Iron-Byron/Testing-Documentation-for-SMP/Images/PCBeasyeda.png

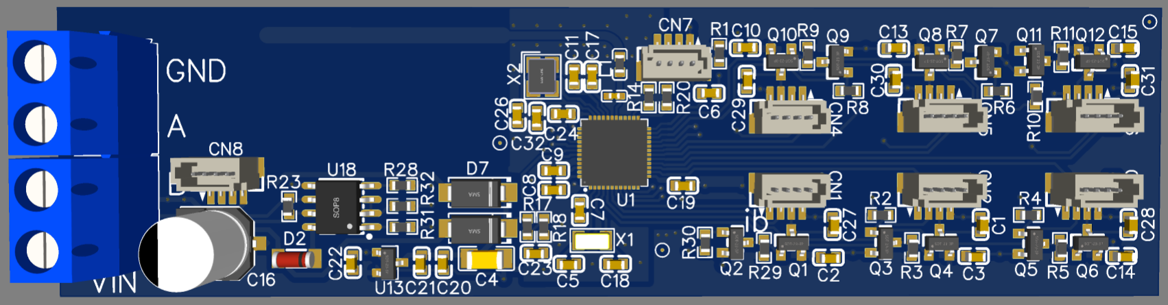
Images/PCBeasyeda.png
