Iron-Byron/Testing-Documentation-for-SMP/Diagram.pptx

4

5

6

1

2

3

1

## Slide 2

Counter

Analog

3V3

GND

## Slide 3

4

5

6

1

2

3

## Slide 4

Sense Board 1

Sense Board 2

Sense Board 4

Sense Board 3

Sense Board 5

Sense Board 6

Main Processing MCU

(6x ADC Temperature Sensors)

(6x Counter Moisture Sensors)

Outputs

RS485
String

BLE Firmware
Update

BLE
Calibration

## Slide 5

+

3v3

control signal

Battery

+

+

control signal

switch

+

Sensor 1

MCU

control signal

switch

+

+

Sensor 2

control signal

switch

switch

+

Sensor 4

Sensor 3

control signal

control signal

switch

+

Sensor 5

switch

+

Sensor 6

## Slide 6

## Slide 7

100

100

100

200

200
