Iron-Byron/Testing-Documentation-for-SMP/Schematic of Sense boards/SMP ver 11.00/SMP ver 11.00 PCB Assy files/SMP ver 11.00 PCB Assy files/SMP ver 11.00 PCB 3D Bottom files.PDF

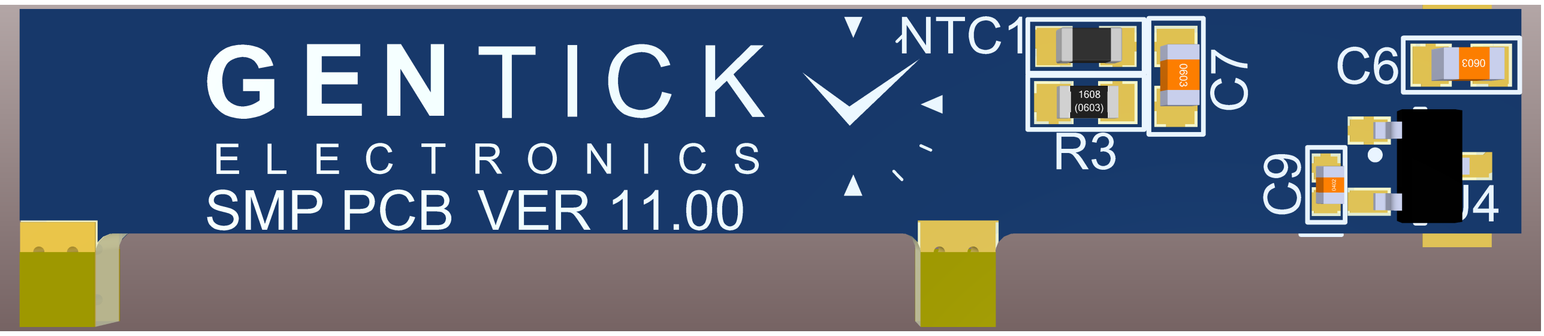
[picture p6: figure]
