Iron-Byron/Testing-Documentation-for-SMP/Schematic of Sense boards/SMP ver 10.00/SMP ver 10.00 PCB PDF files/SMP ver 10.00 PCB 3D Bottom files.PDF

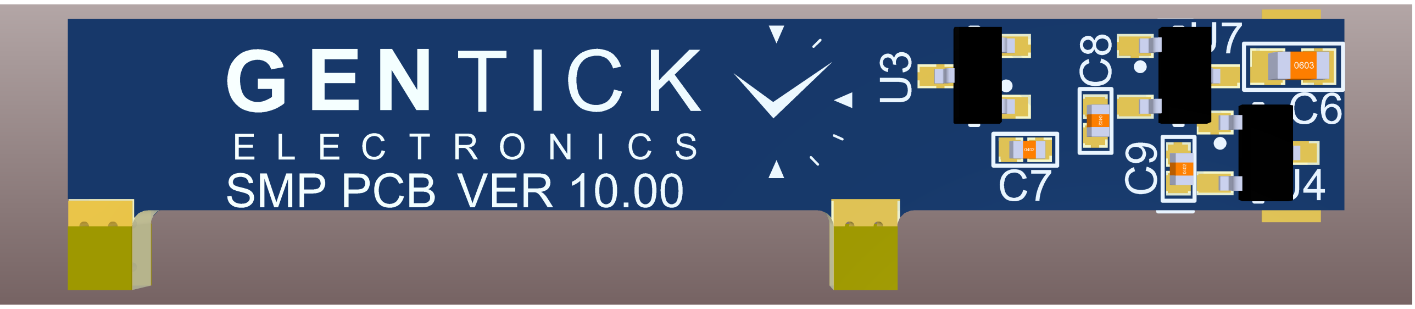
[picture p8: figure]
