Iron-Byron/Testing-Documentation-for-SMP/Images/29.04.2025.1to3temp.png

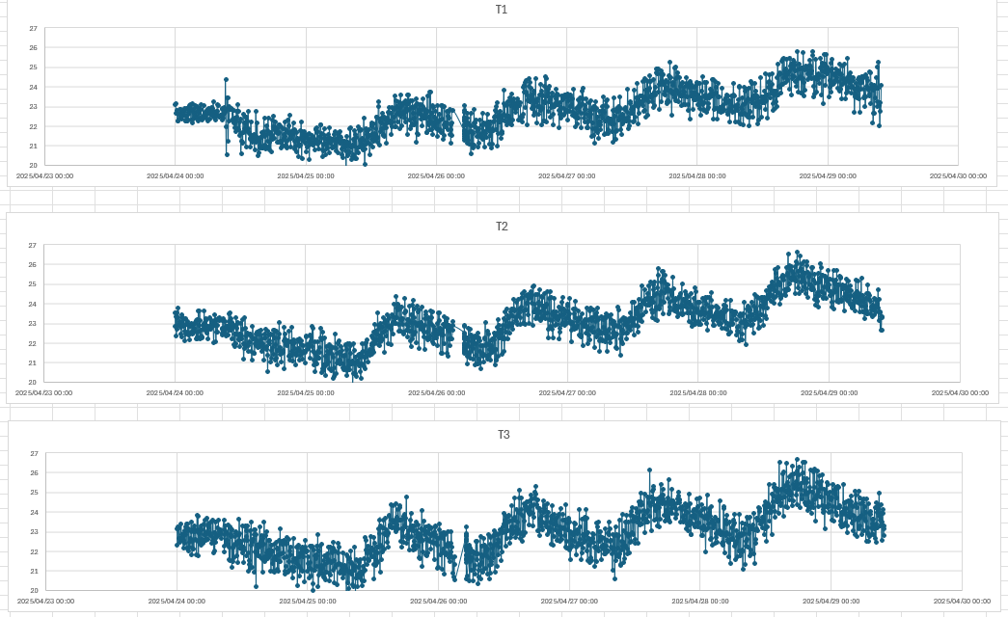
Images/29.04.2025.1to3temp.png
