Iron-Byron/Testing-Documentation-for-SMP/Images/29.04.2025.4to6temp.png

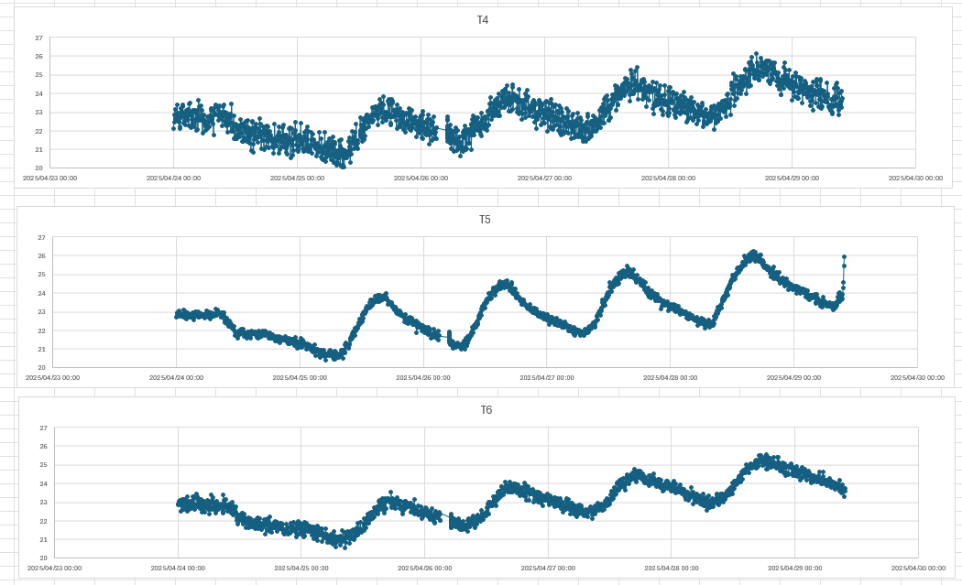
Images/29.04.2025.4to6temp.png
