Iron-Byron/Testing-Documentation-for-SMP/Images/Connector.png

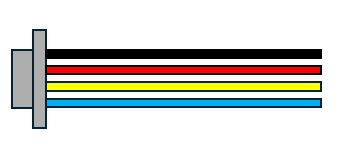
Images/Connector.png
