Iron-Byron/Testing-Documentation-for-SMP/Images/MCUboard.png

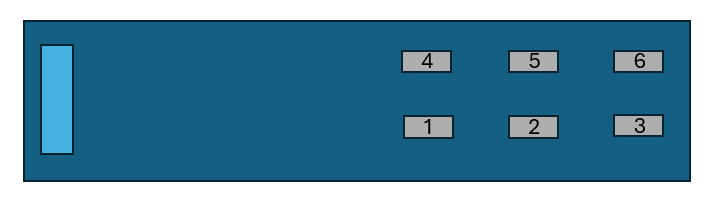
Images/MCUboard.png
