Iron-Byron/Testing-Documentation-for-SMP/Images/nrf52832_001.jpg

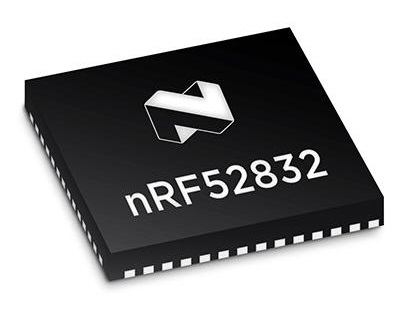
Images/nrf52832_001.jpg
