Iron-Byron/Testing-Documentation-for-SMP/Images/NTCno.nos.png

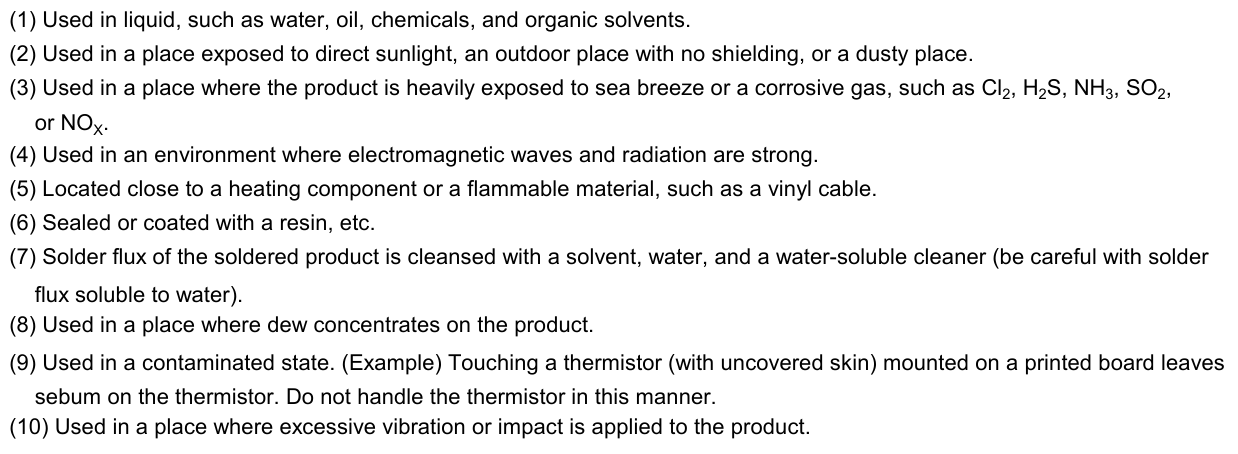
Images/NTCno.nos.png
