Iron-Byron/Testing-Documentation-for-SMP/Images/Probespacing.png

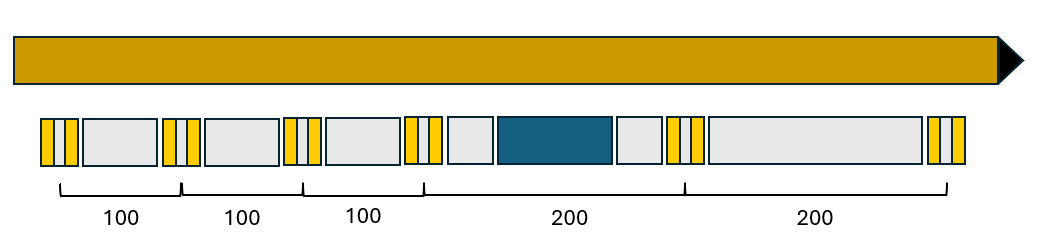
Images/Probespacing.png
