Iron-Byron/Testing-Documentation-for-SMP/Images/soilTemps.png

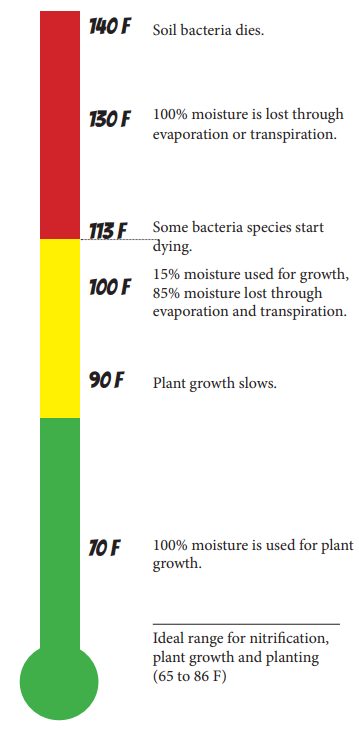
Images/soilTemps.png
