Iron-Byron/Testing-Documentation-for-SMP/Images/TempSchemat.png

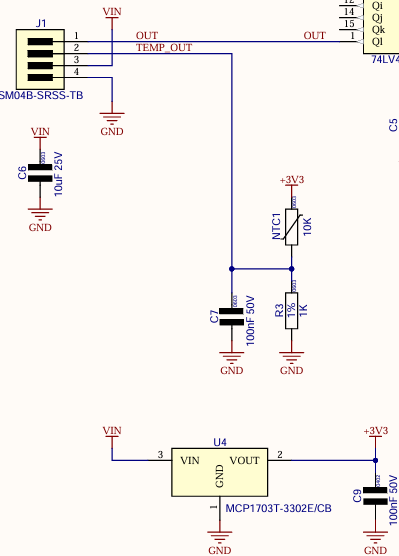
Images/TempSchemat.png
