Iron-Byron/Testing-Documentation-for-SMP/Schematic of Sense boards/SMP ver 11.00/SMP ver 11.00 PCB BOM_Building.xlsx

Title : SMP ver 11.00 PCB Parts List
Doc No : n/a
Date : 19/11/2024
Prepared By : EDM
Doc Rev : 01 |  |  | `
 |  |  |  |  |  |  |  |  |  |  | 1000 | stock
Item | Quantity | Designator | Description | Value | Voltage | Tol | Watt | Footprint | Manufacturer | Part Number | DNF
1 | 3 | C4, C5, C9 | Cap Ceramic X5R | 100nF | 50V | 5% |  | CAPC0402X60N | Various | 100nF 0402 50V 5% X5R | 3000
2 | 1 | C7 | Cap Ceramic X5R | 100nF | 50V | 5% |  | CAPC0603X85N | Various | 100nF 0603 50V 5% X5R | 1000
3 | 1 | C1 | Cap Ceramic C0G/NP0 | 100pF | 50V | 10% |  | CAPC0402X60N | Various | 100pF 0402 50V 10% C0G/NP0 | 1000
4 | 1 | C2 | Cap Ceramic C0G/NP0 | 10pF | 50V | 5% |  | CAPC0402X60N | Various | 10pF 0402 50V 5% C0G/NP0 | 1000
5 | 1 | C6 | Cap Ceramic X5R | 10uF | 25V | 10% |  | CAPC0603X85N | Various | 10uF 0603 25V 10% X5R | 1000
6 | 1 | C3 | Cap Ceramic C0G/NP0 | 4.7pF | 50V | 5% |  | CAPC0402X60N | Various | 4.7pF 0402 50V 5% C0G/NP0 | 1000
7 | 1 | J1 | Connector Wire to Board 1.0mm Rt Angle | SM04B-SRSS-TB |  |  |  | SM04B-SRSS-TB | JST | SM04B-SRSS-TB | 1000 | 1500
8 | 1 | U1 | IC 12-Bit Binary Ripple Counter | 74LV4040FT |  |  |  | TSSOP16-4.5x5.0 | Toshiba | 74LV4040FT | 1000 | 2500
9 | 1 | U2 | IC Single Schmitt-Trigger Inverter | 74AHC1G14DBVR |  |  |  | SOT23-5 | Texas | 74AHC1G14DBVR | 1000
10 | 1 | NTC1 | NTC Thermistor 0603 | 10K |  |  |  | NTC0603 | Panasonic | ERT-J1VG103FA | 1000
11 | 1 | R3 | Resistor Chip SMD | 1K |  | 1% | 100mW | RESC0603X60N | Various | 1K 0603 1% | 1000
12 | 2 | R1, R2 | Resistor Chip SMD | 510R |  | 1% | 63mW | RESC0402X40N | Various | 510R 0402 1% | 2000
13 | 1 | U4 | Voltage Regulator LDO 250mA | XC6206P332MR-G |  |  |  | SOT23A | Torex | XC6206P332MR-G | 1000
14 | 1 |  | SMP ver 11.00 PCB (2 Layer) |  |  |  |  |  | EDM |  | 1000
