Iron-Byron/Testing-Documentation-for-SMP/Schematic of Sense boards/SMP ver 11.00/SMP ver 11.00 PCB Assy files/SMP ver 11.00 PCB Assy files/SMP ver 11.00 PCB Parts List.xlsx

Title : SMP ver 11.00 PCB Parts List
Doc No : n/a
Date : 19/11/2024
Prepared By : EDM
Doc Rev : 01 |  |  | `
Item | Quantity | Designator | Description | Value | Voltage | Tol | Watt | Footprint | Manufacturer | Part Number | DNF
1 | 3 | C4, C5, C9 | Cap Ceramic X5R | 100nF | 50V | 5% |  | CAPC0402X60N | Various | 100nF 0402 50V 5% X5R
2 | 1 | C7 | Cap Ceramic X5R | 100nF | 50V | 5% |  | CAPC0603X85N | Various | 100nF 0603 50V 5% X5R
3 | 1 | C1 | Cap Ceramic C0G/NP0 | 100pF | 50V | 10% |  | CAPC0402X60N | Various | 100pF 0402 50V 10% C0G/NP0
4 | 1 | C2 | Cap Ceramic C0G/NP0 | 10pF | 50V | 5% |  | CAPC0402X60N | Various | 10pF 0402 50V 5% C0G/NP0
5 | 1 | C6 | Cap Ceramic X5R | 10uF | 25V | 10% |  | CAPC0603X85N | Various | 10uF 0603 25V 10% X5R
6 | 1 | C3 | Cap Ceramic C0G/NP0 | 4.7pF | 50V | 5% |  | CAPC0402X60N | Various | 4.7pF 0402 50V 5% C0G/NP0
7 | 1 | J1 | Connector Wire to Board 1.0mm Rt Angle | SM04B-SRSS-TB |  |  |  | SM04B-SRSS-TB | JST | SM04B-SRSS-TB
8 | 1 | U1 | IC 12-Bit Binary Ripple Counter | 74LV4040APWR |  |  |  | TSSOP16-4.5x5.0 | Texas | 74LV4040APWR
9 | 1 | U2 | IC Single Schmitt-Trigger Inverter | 74AHC1G14DBVR |  |  |  | SOT23-5 | Texas | 74AHC1G14DBVR
10 | 1 | NTC1 | NTC Thermistor 0603 | 1K |  |  |  | NTC0603 | Panasonic | ERT-J1VG102J
11 | 1 | R3 | Resistor Chip SMD | 1K |  | 1% | 100mW | RESC0603X60N | Various | 1K 0603 1%
12 | 2 | R1, R2 | Resistor Chip SMD | 510R |  | 1% | 63mW | RESC0402X40N | Various | 510R 0402 1%
13 | 1 | U4 | Voltage Regulator LDO 250mA | MCP1703T-3302E/CB |  |  |  | SOT23A | Microchip | MCP1703T-3302E/CB
14 | 1 |  | SMP ver 11.00 PCB (2 Layer) |  |  |  |  |  | EDM
