Iron-Byron/Testing-Documentation-for-SMP/Schematic of Sense boards/SMP ver 11.00/SMP ver 11.00 PCB Assy files/SMP ver 11.00 PCB Assy files/SMP ver 11.00 PCB Assy files.PDF

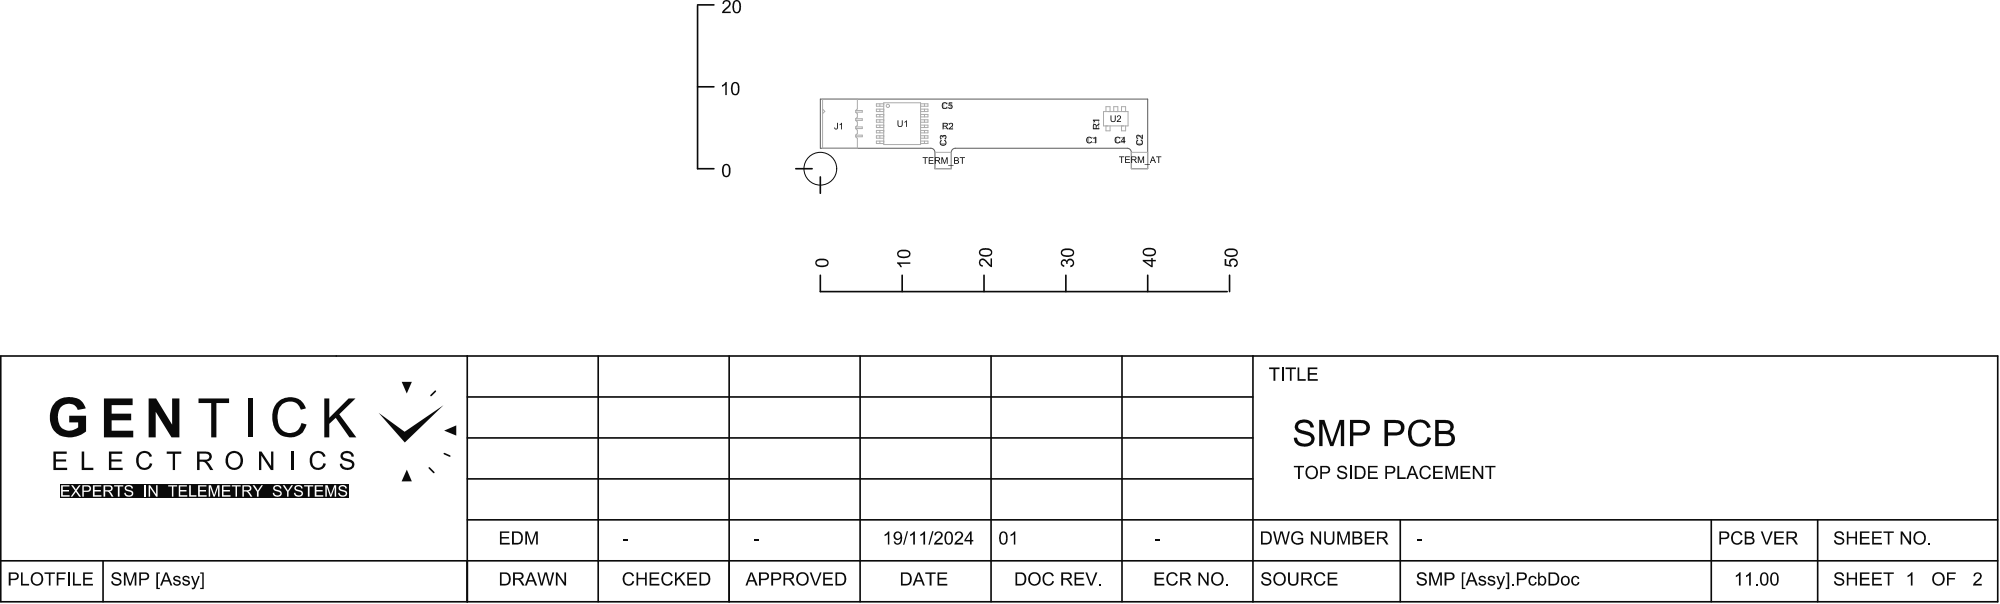
[picture p112: page 1]

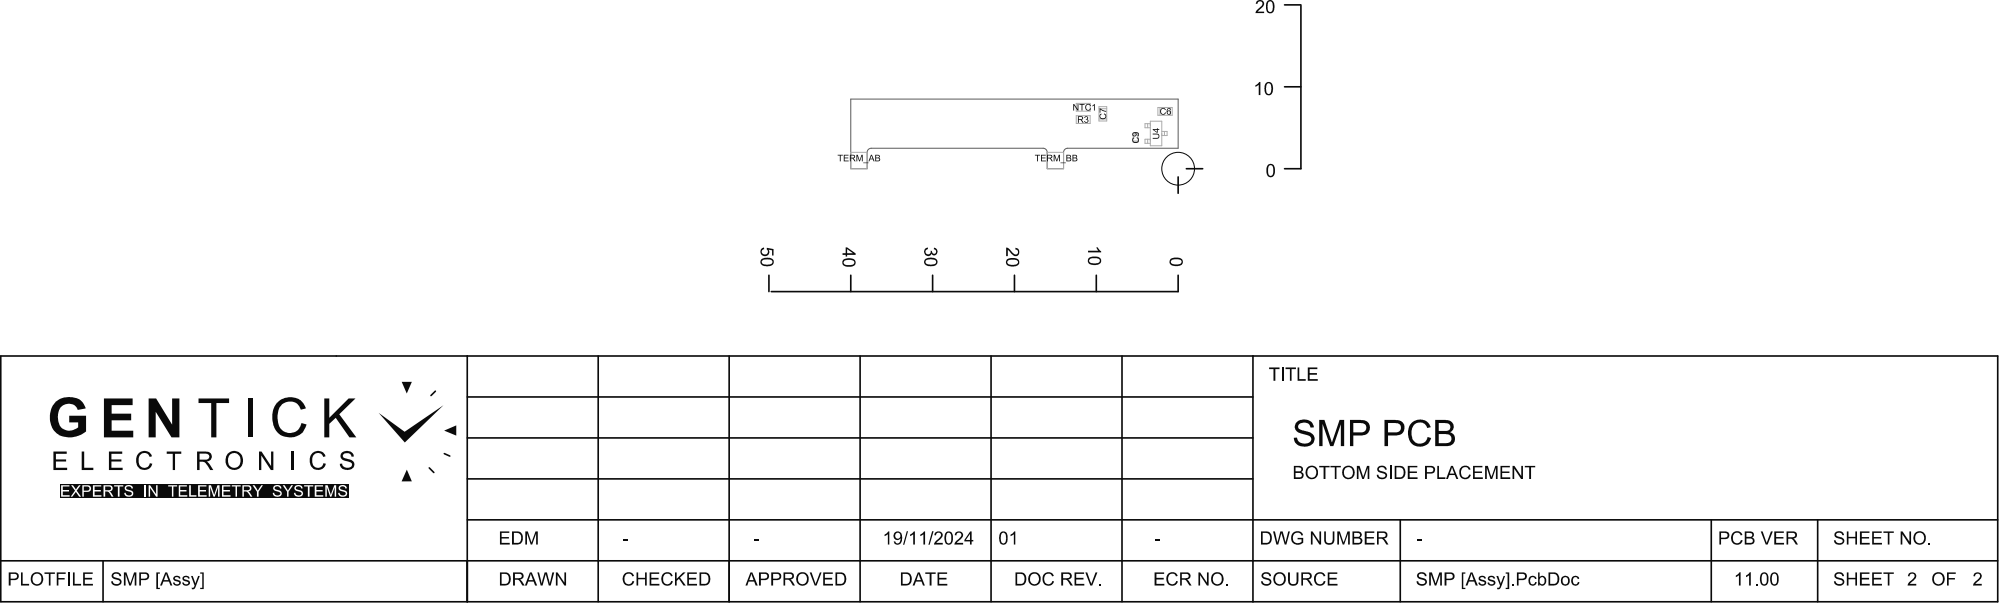
[picture p113: page 2]
