Iron-Byron/Testing-Documentation-for-SMP/Schematic of Sense boards/SMP ver 11.00/SMP ver 11.00 PCB PDF files/SMP ver 11.00 PCB PDF files/SMP ver 11.00 PCB Mfg files.PDF

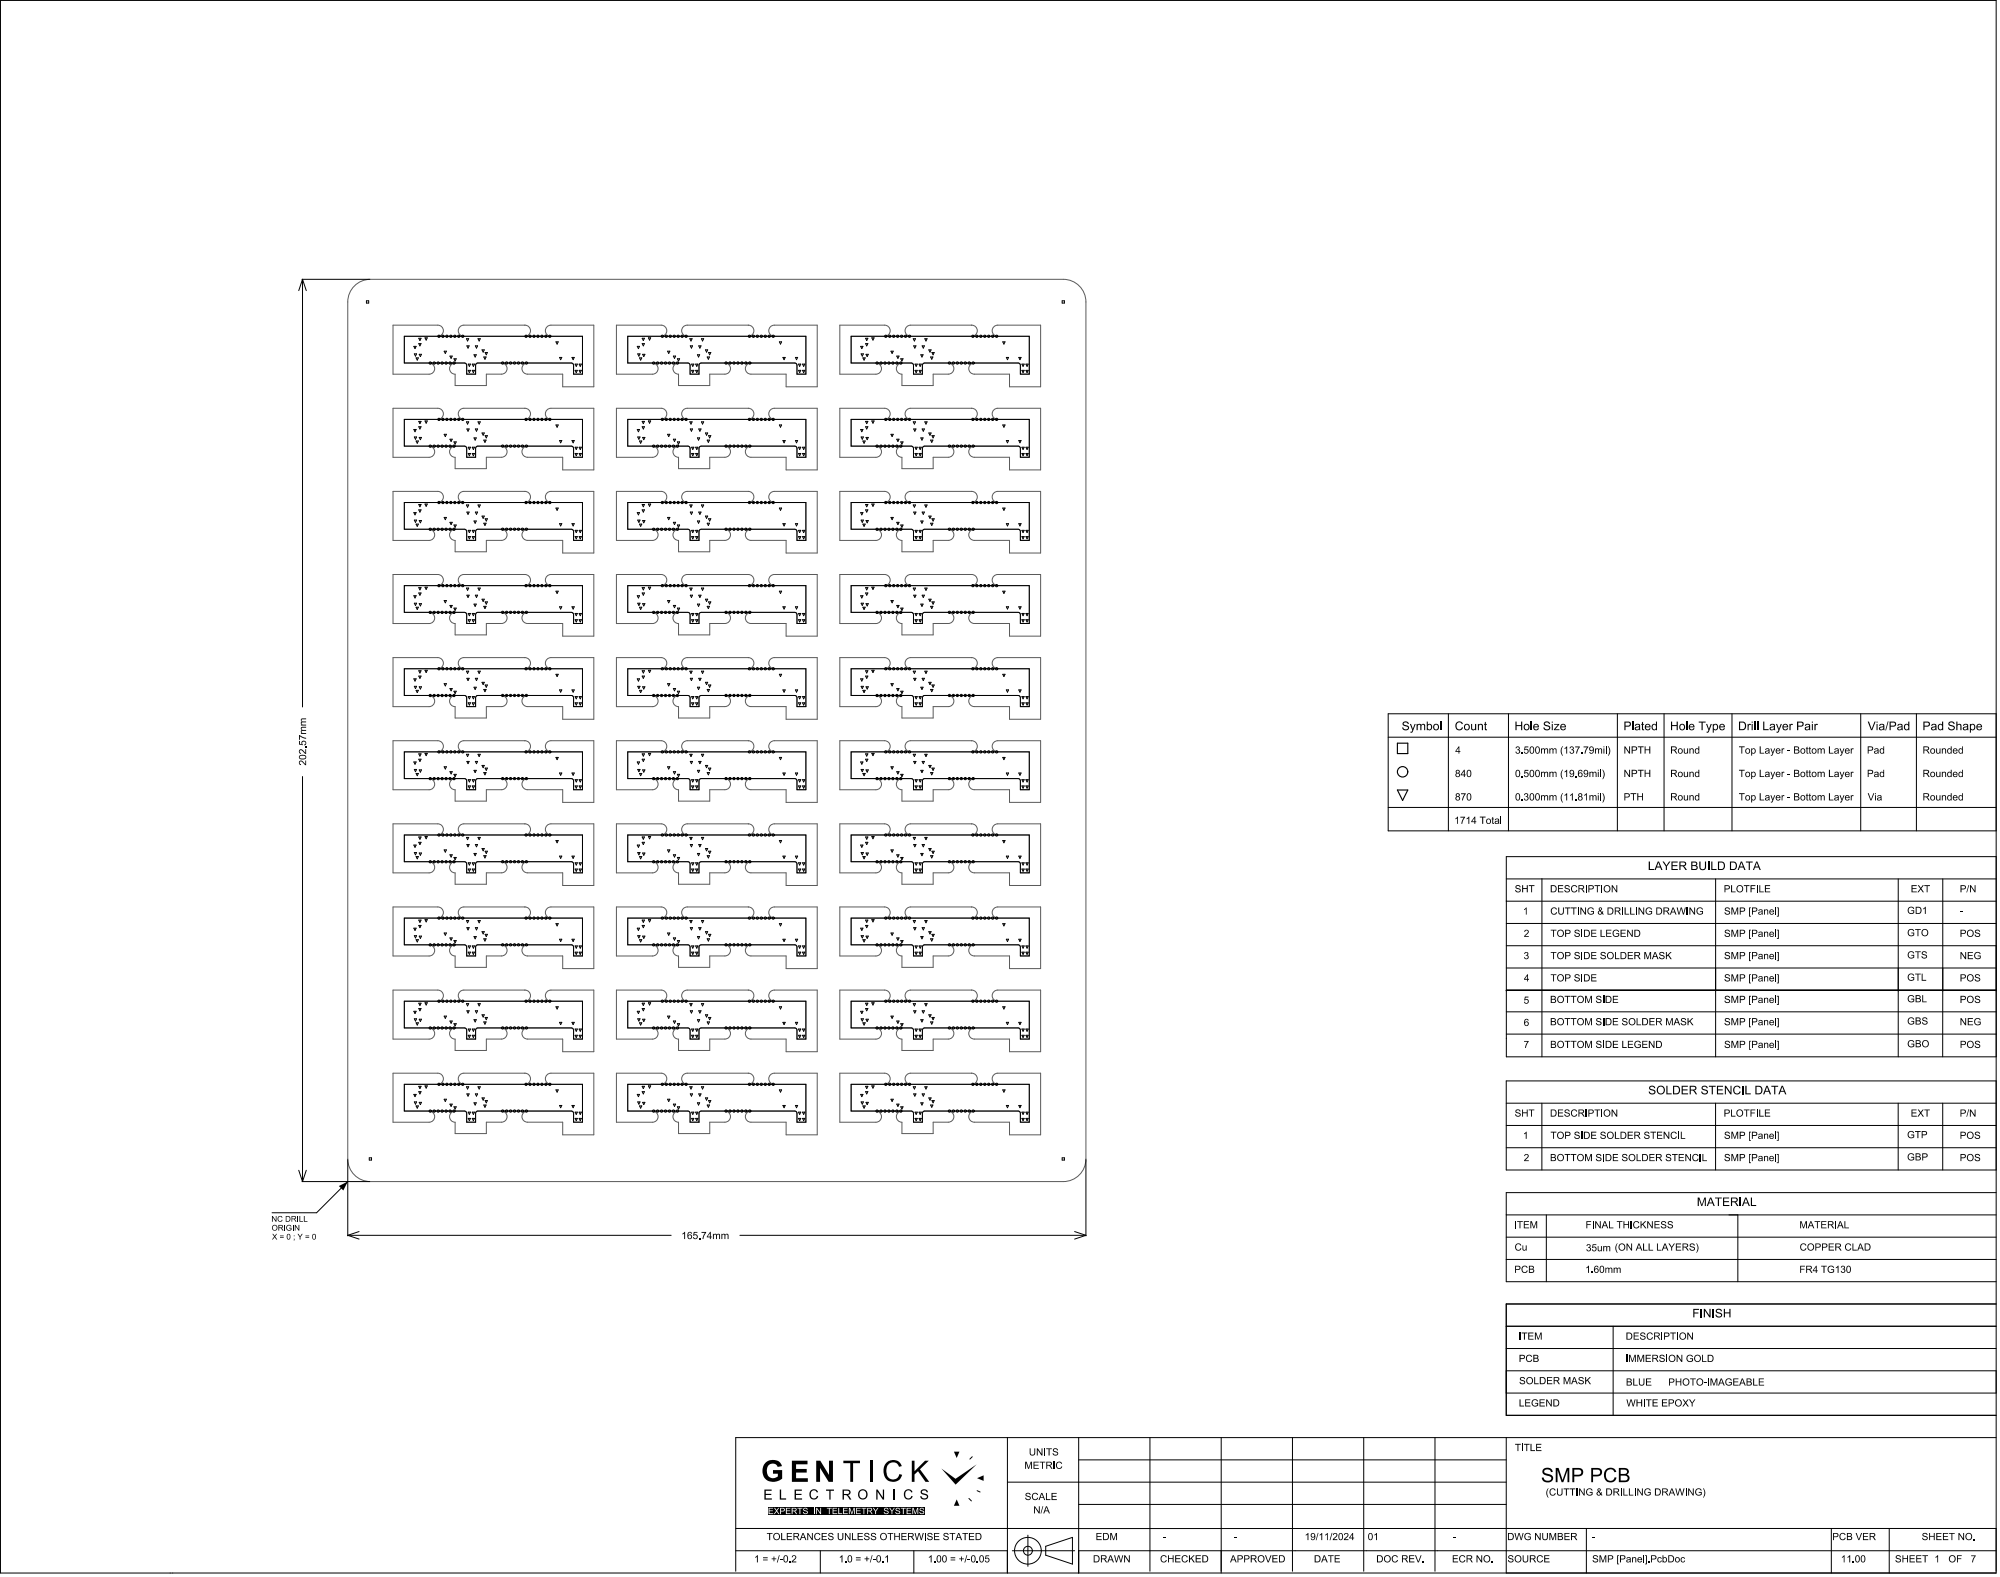
[picture p114: page 1]

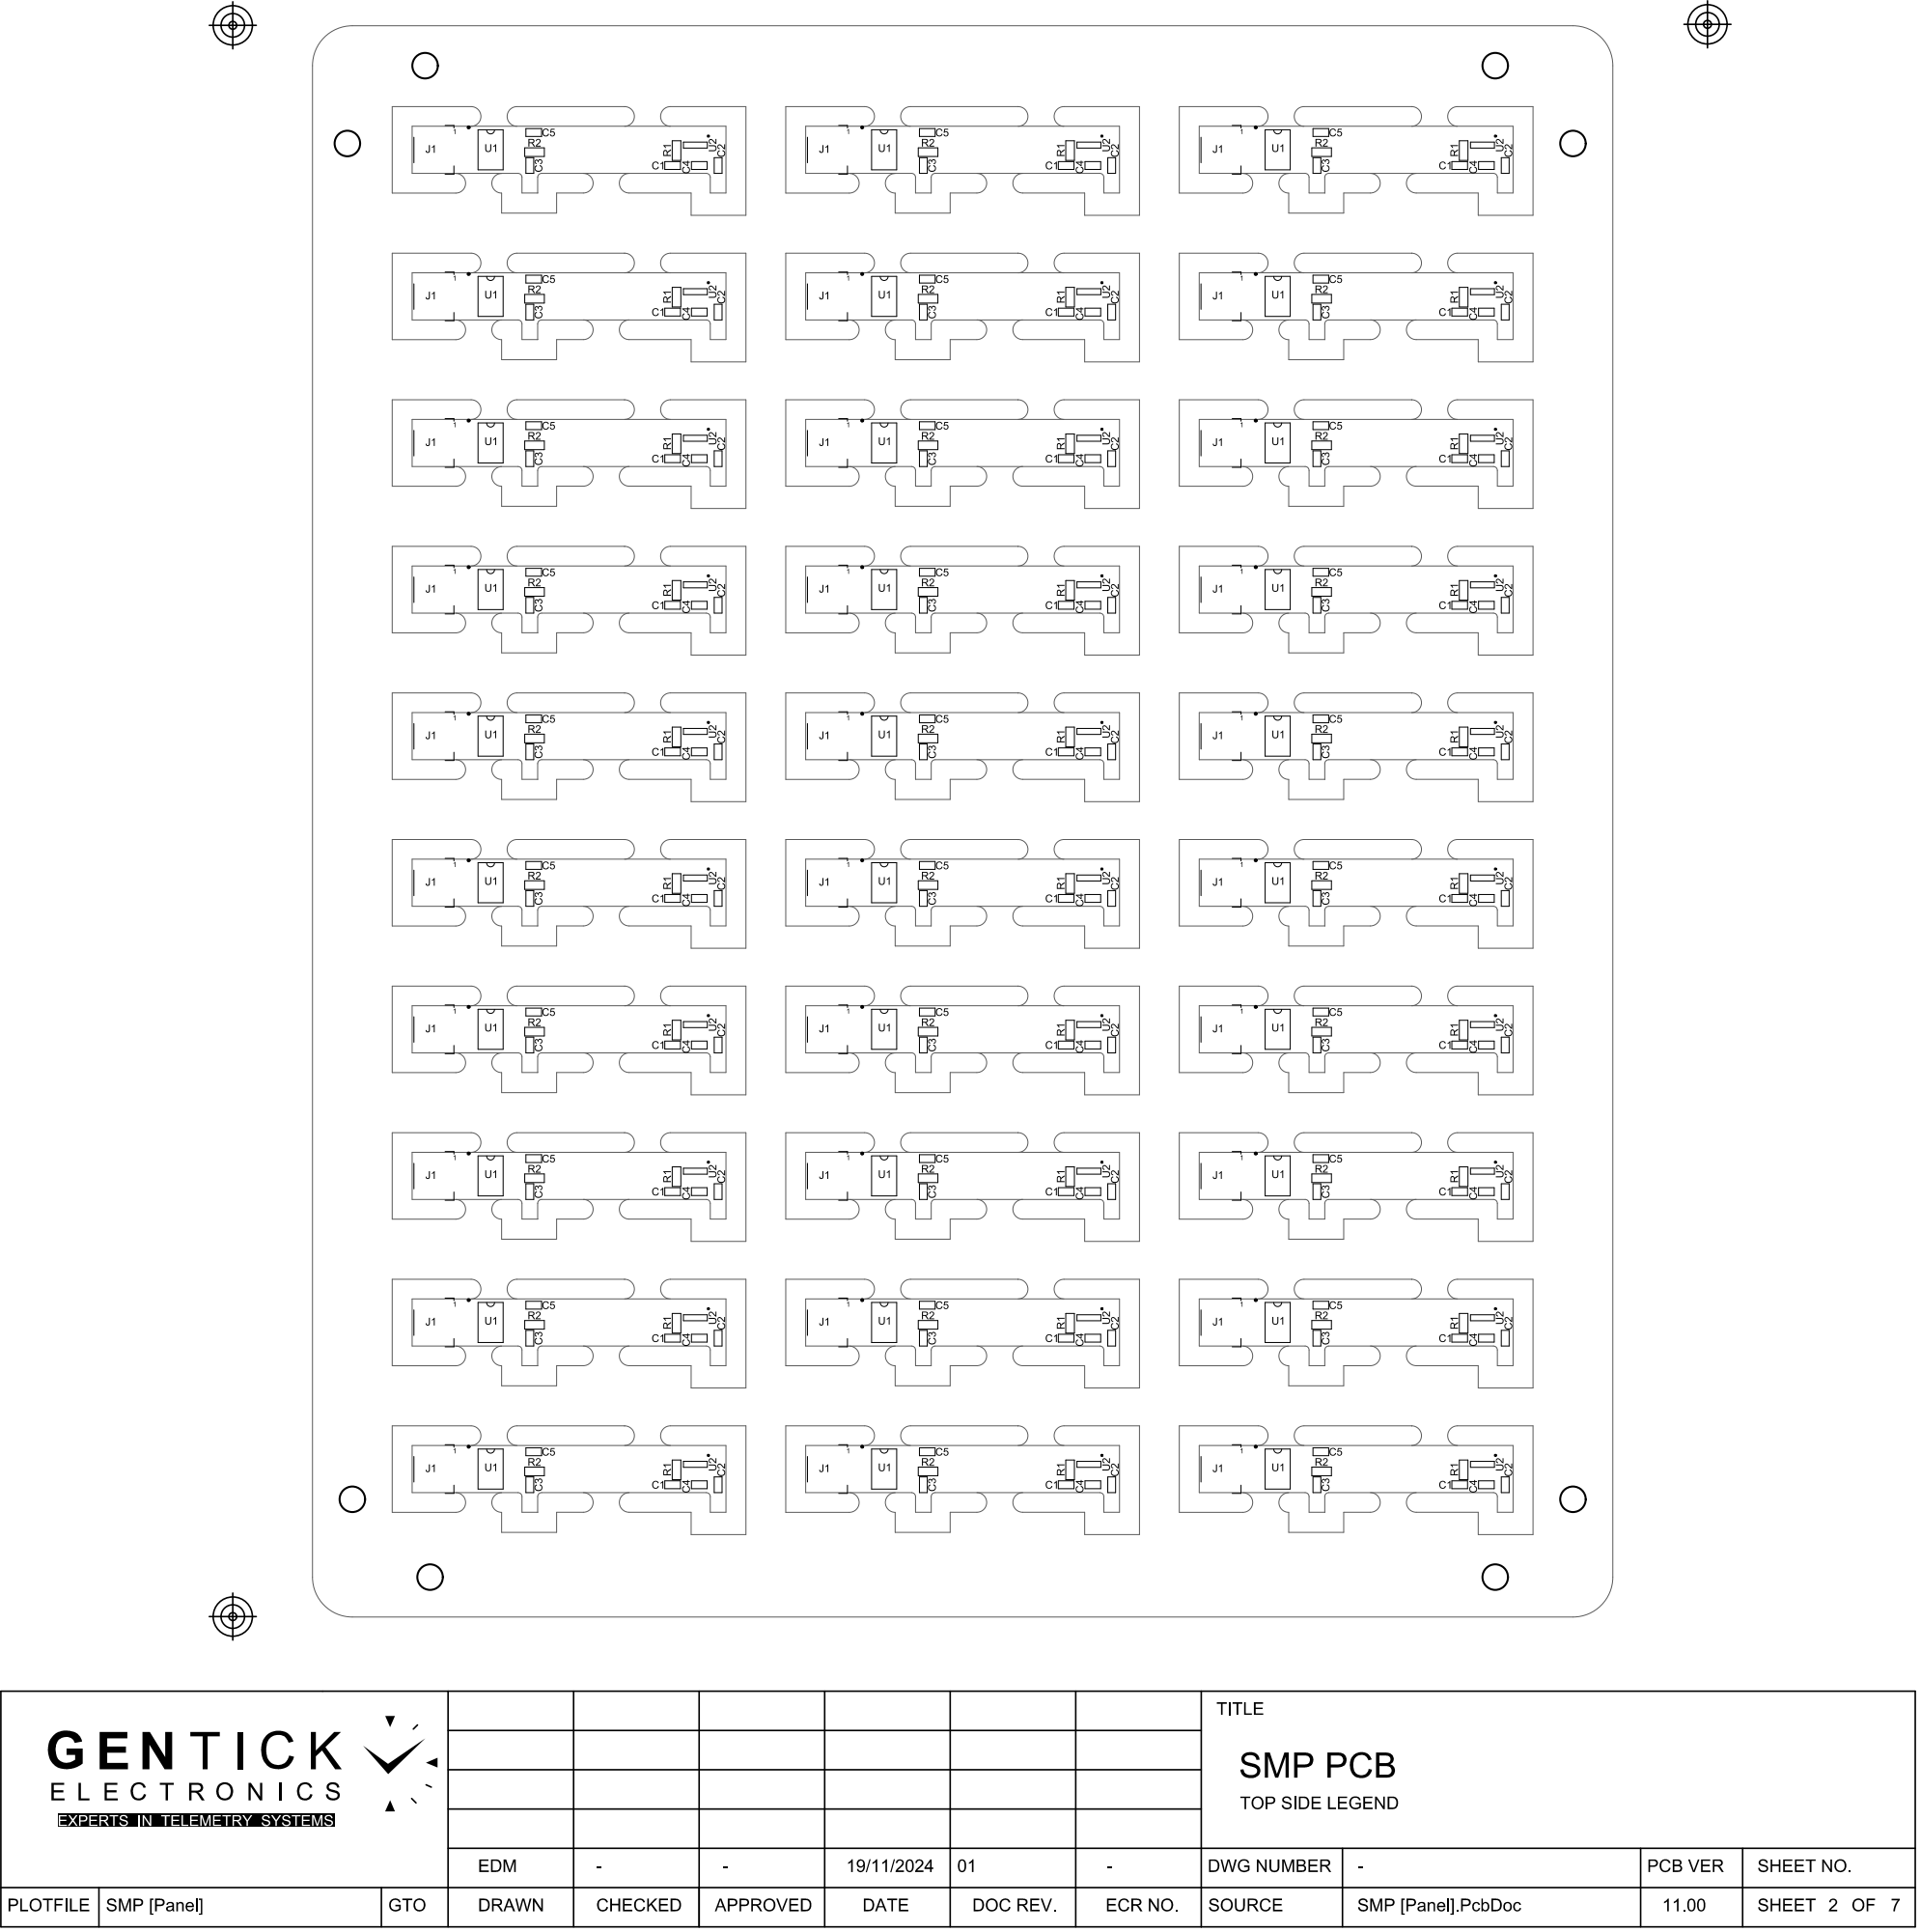
[picture p115: page 2]

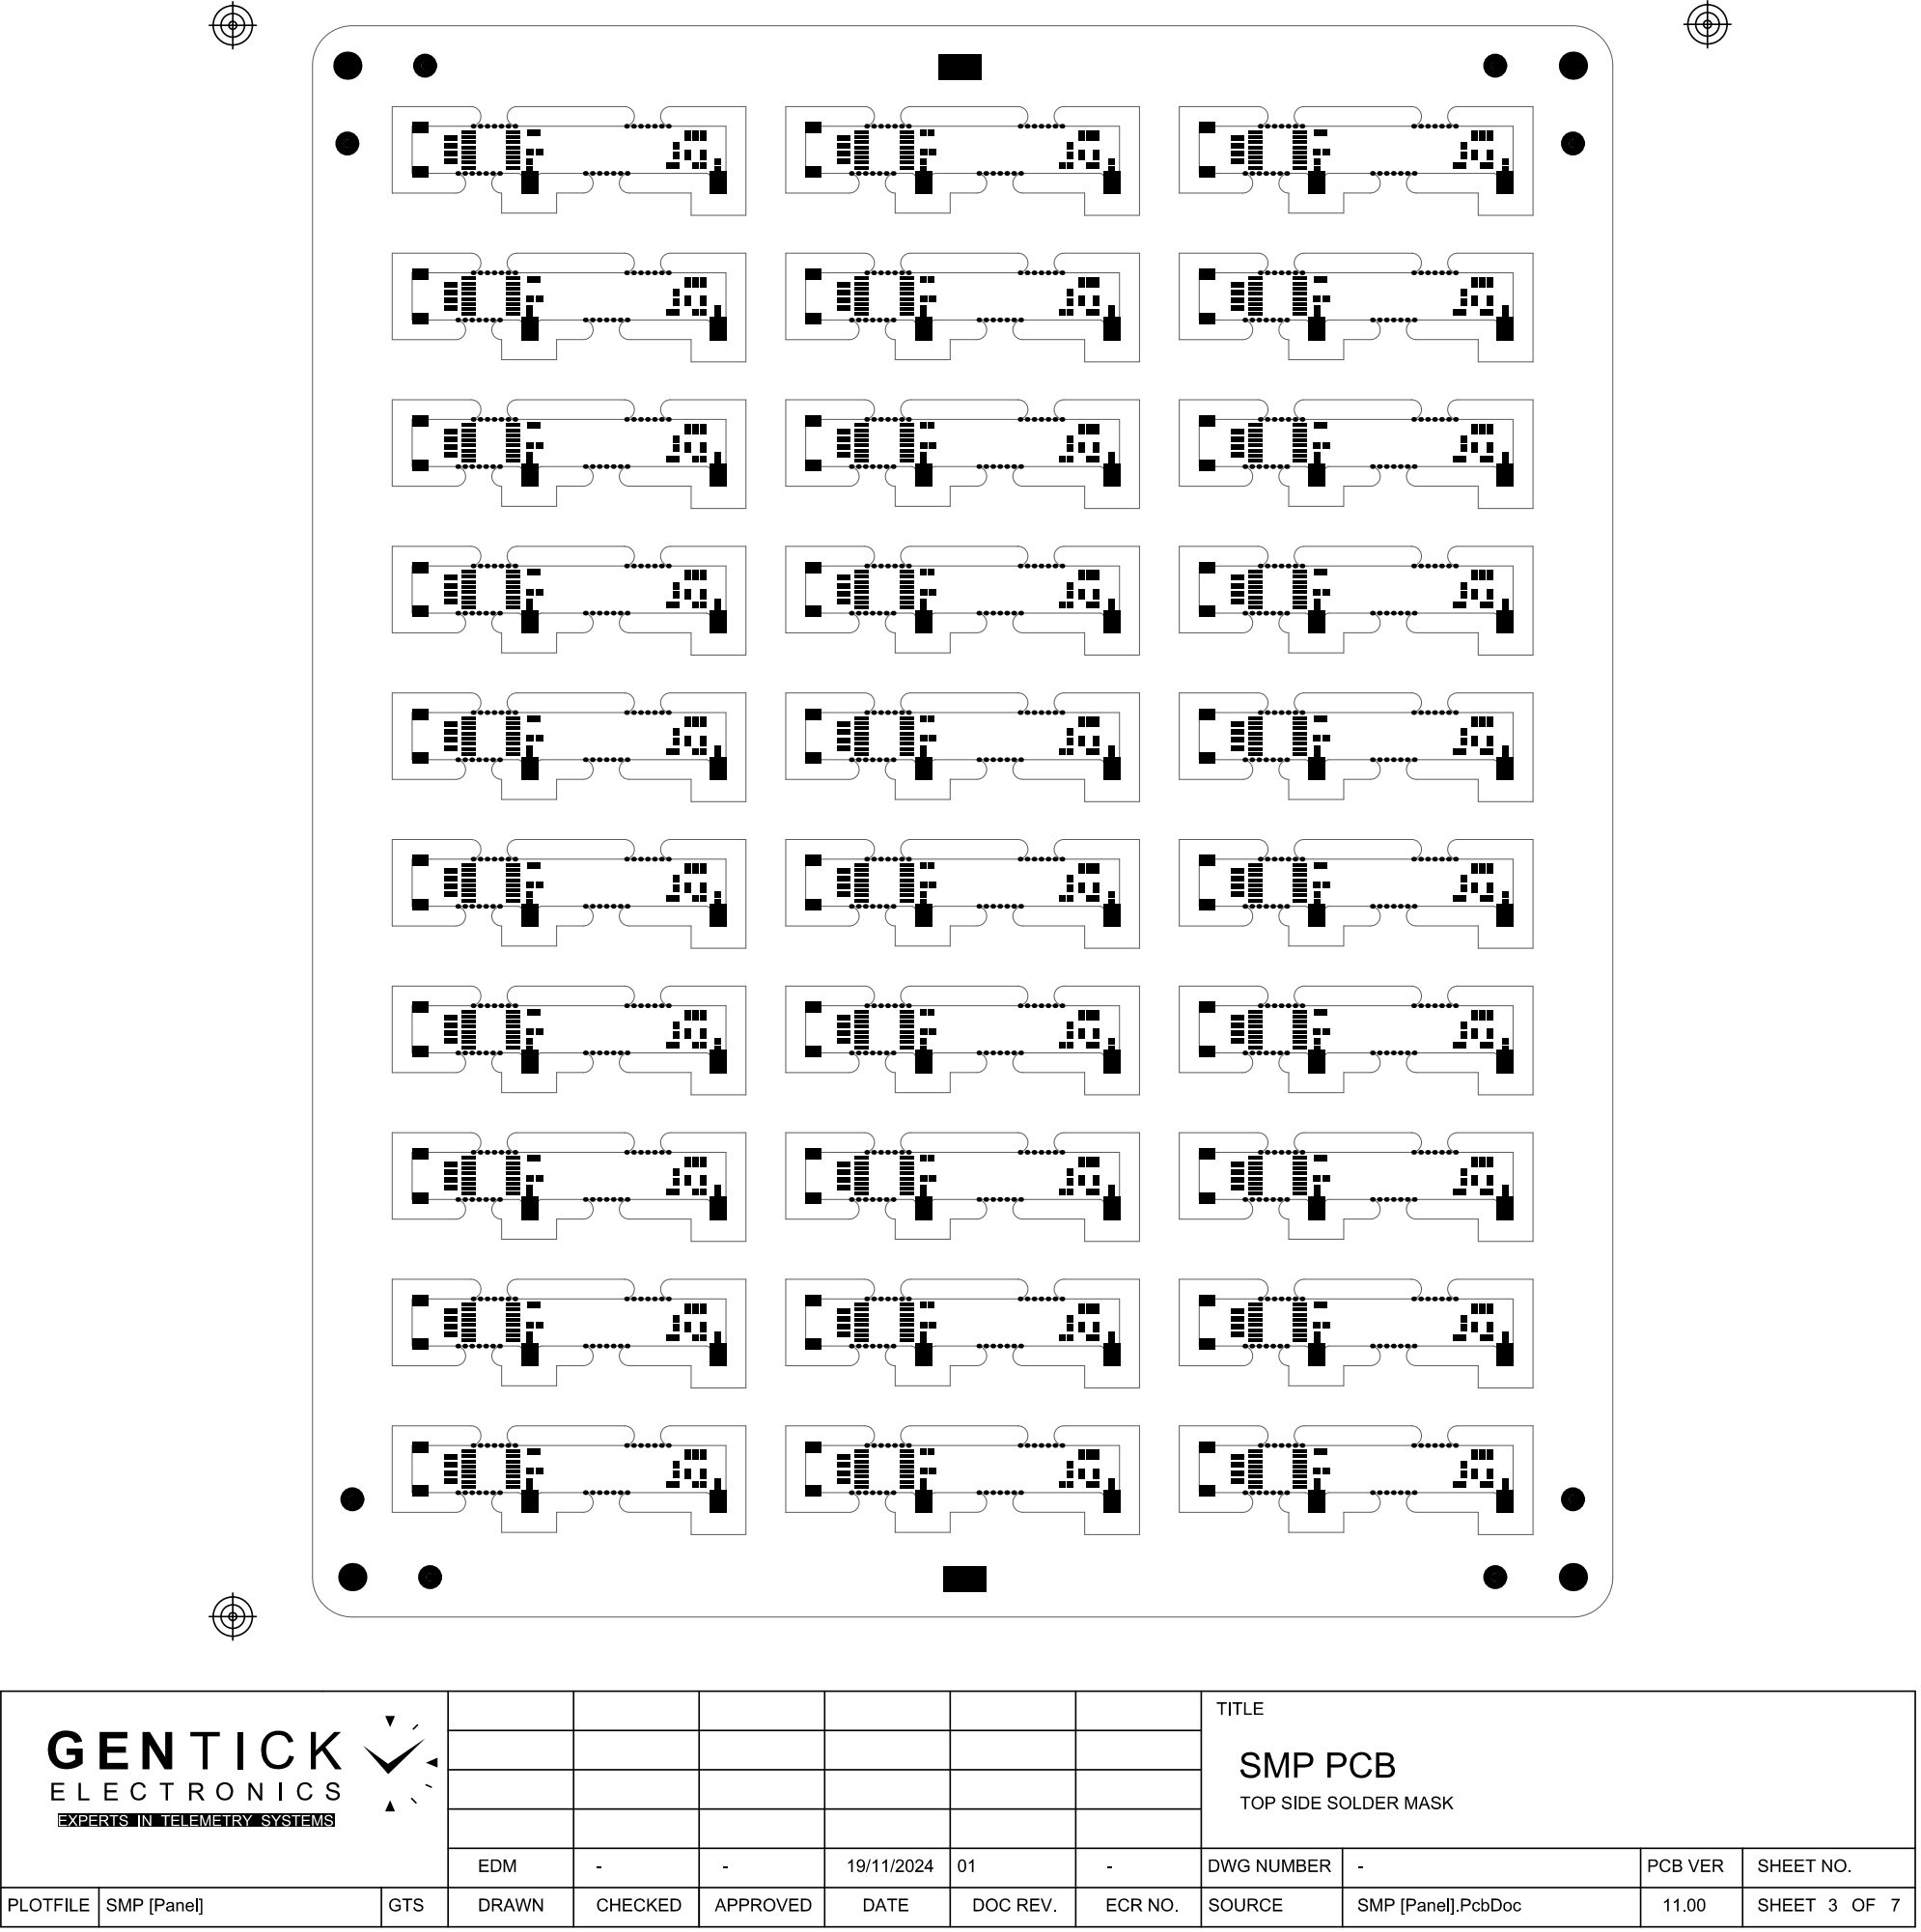
[picture p116: page 3]

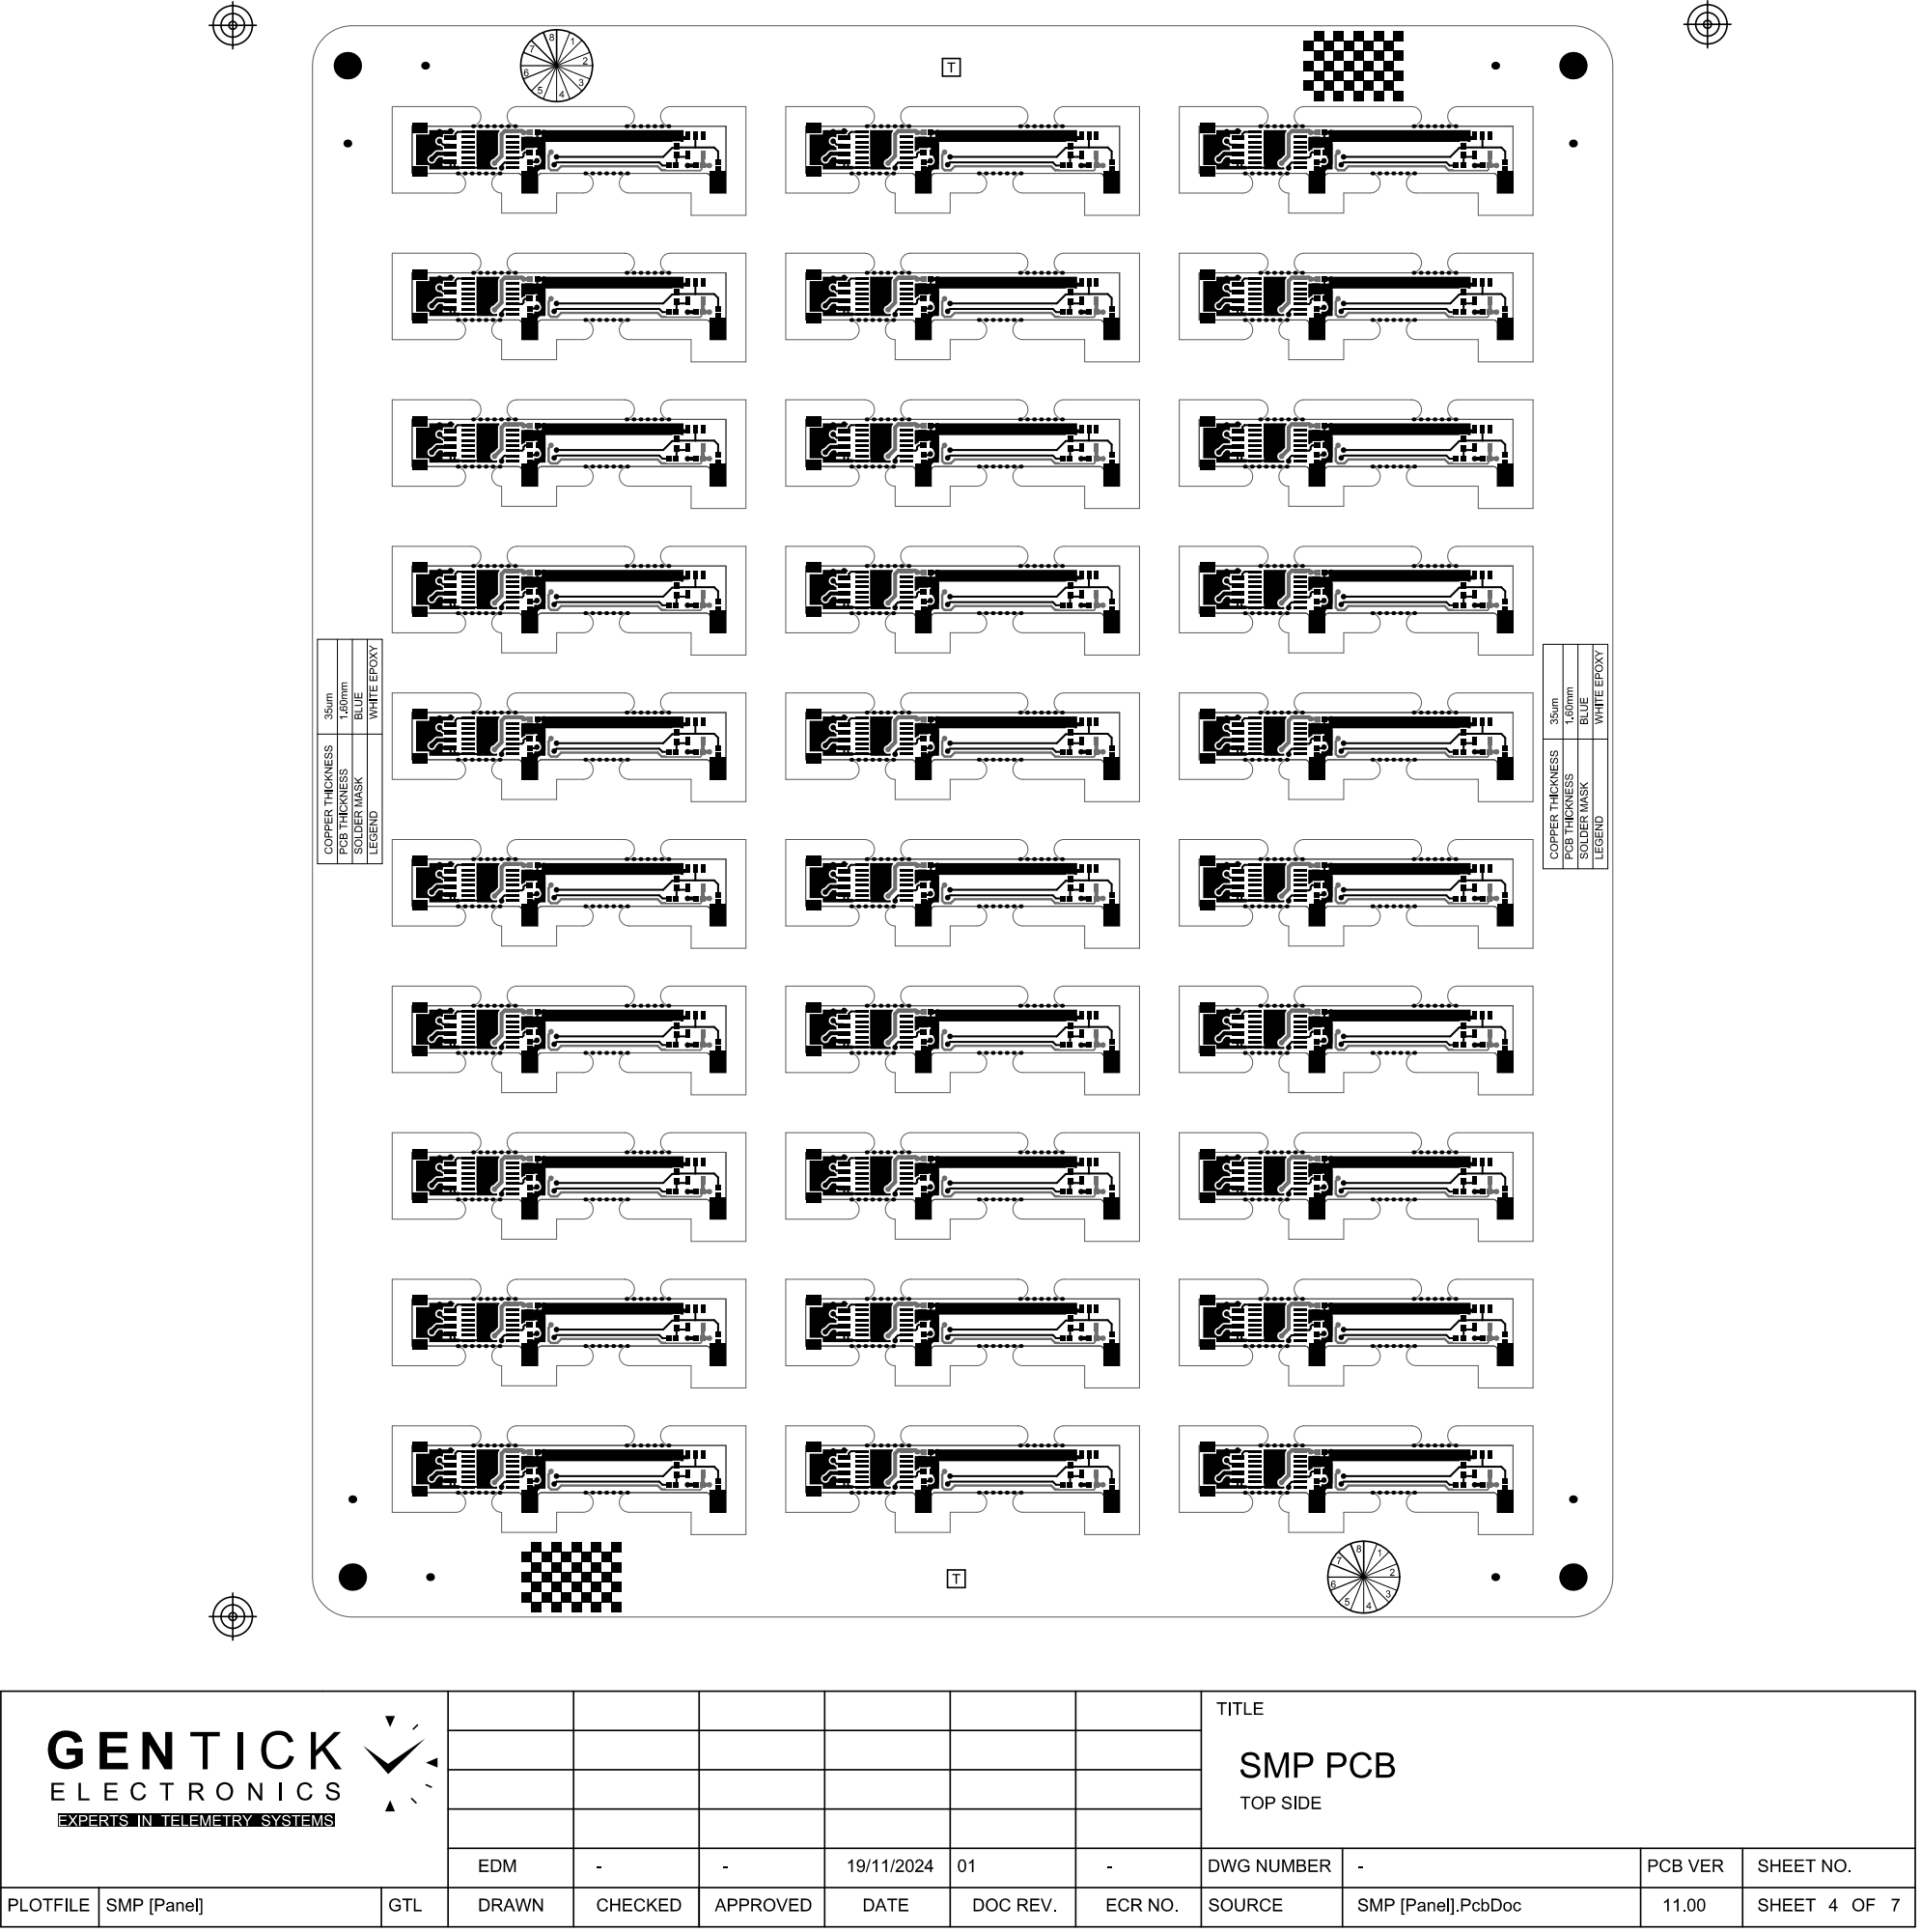
[picture p117: page 4]

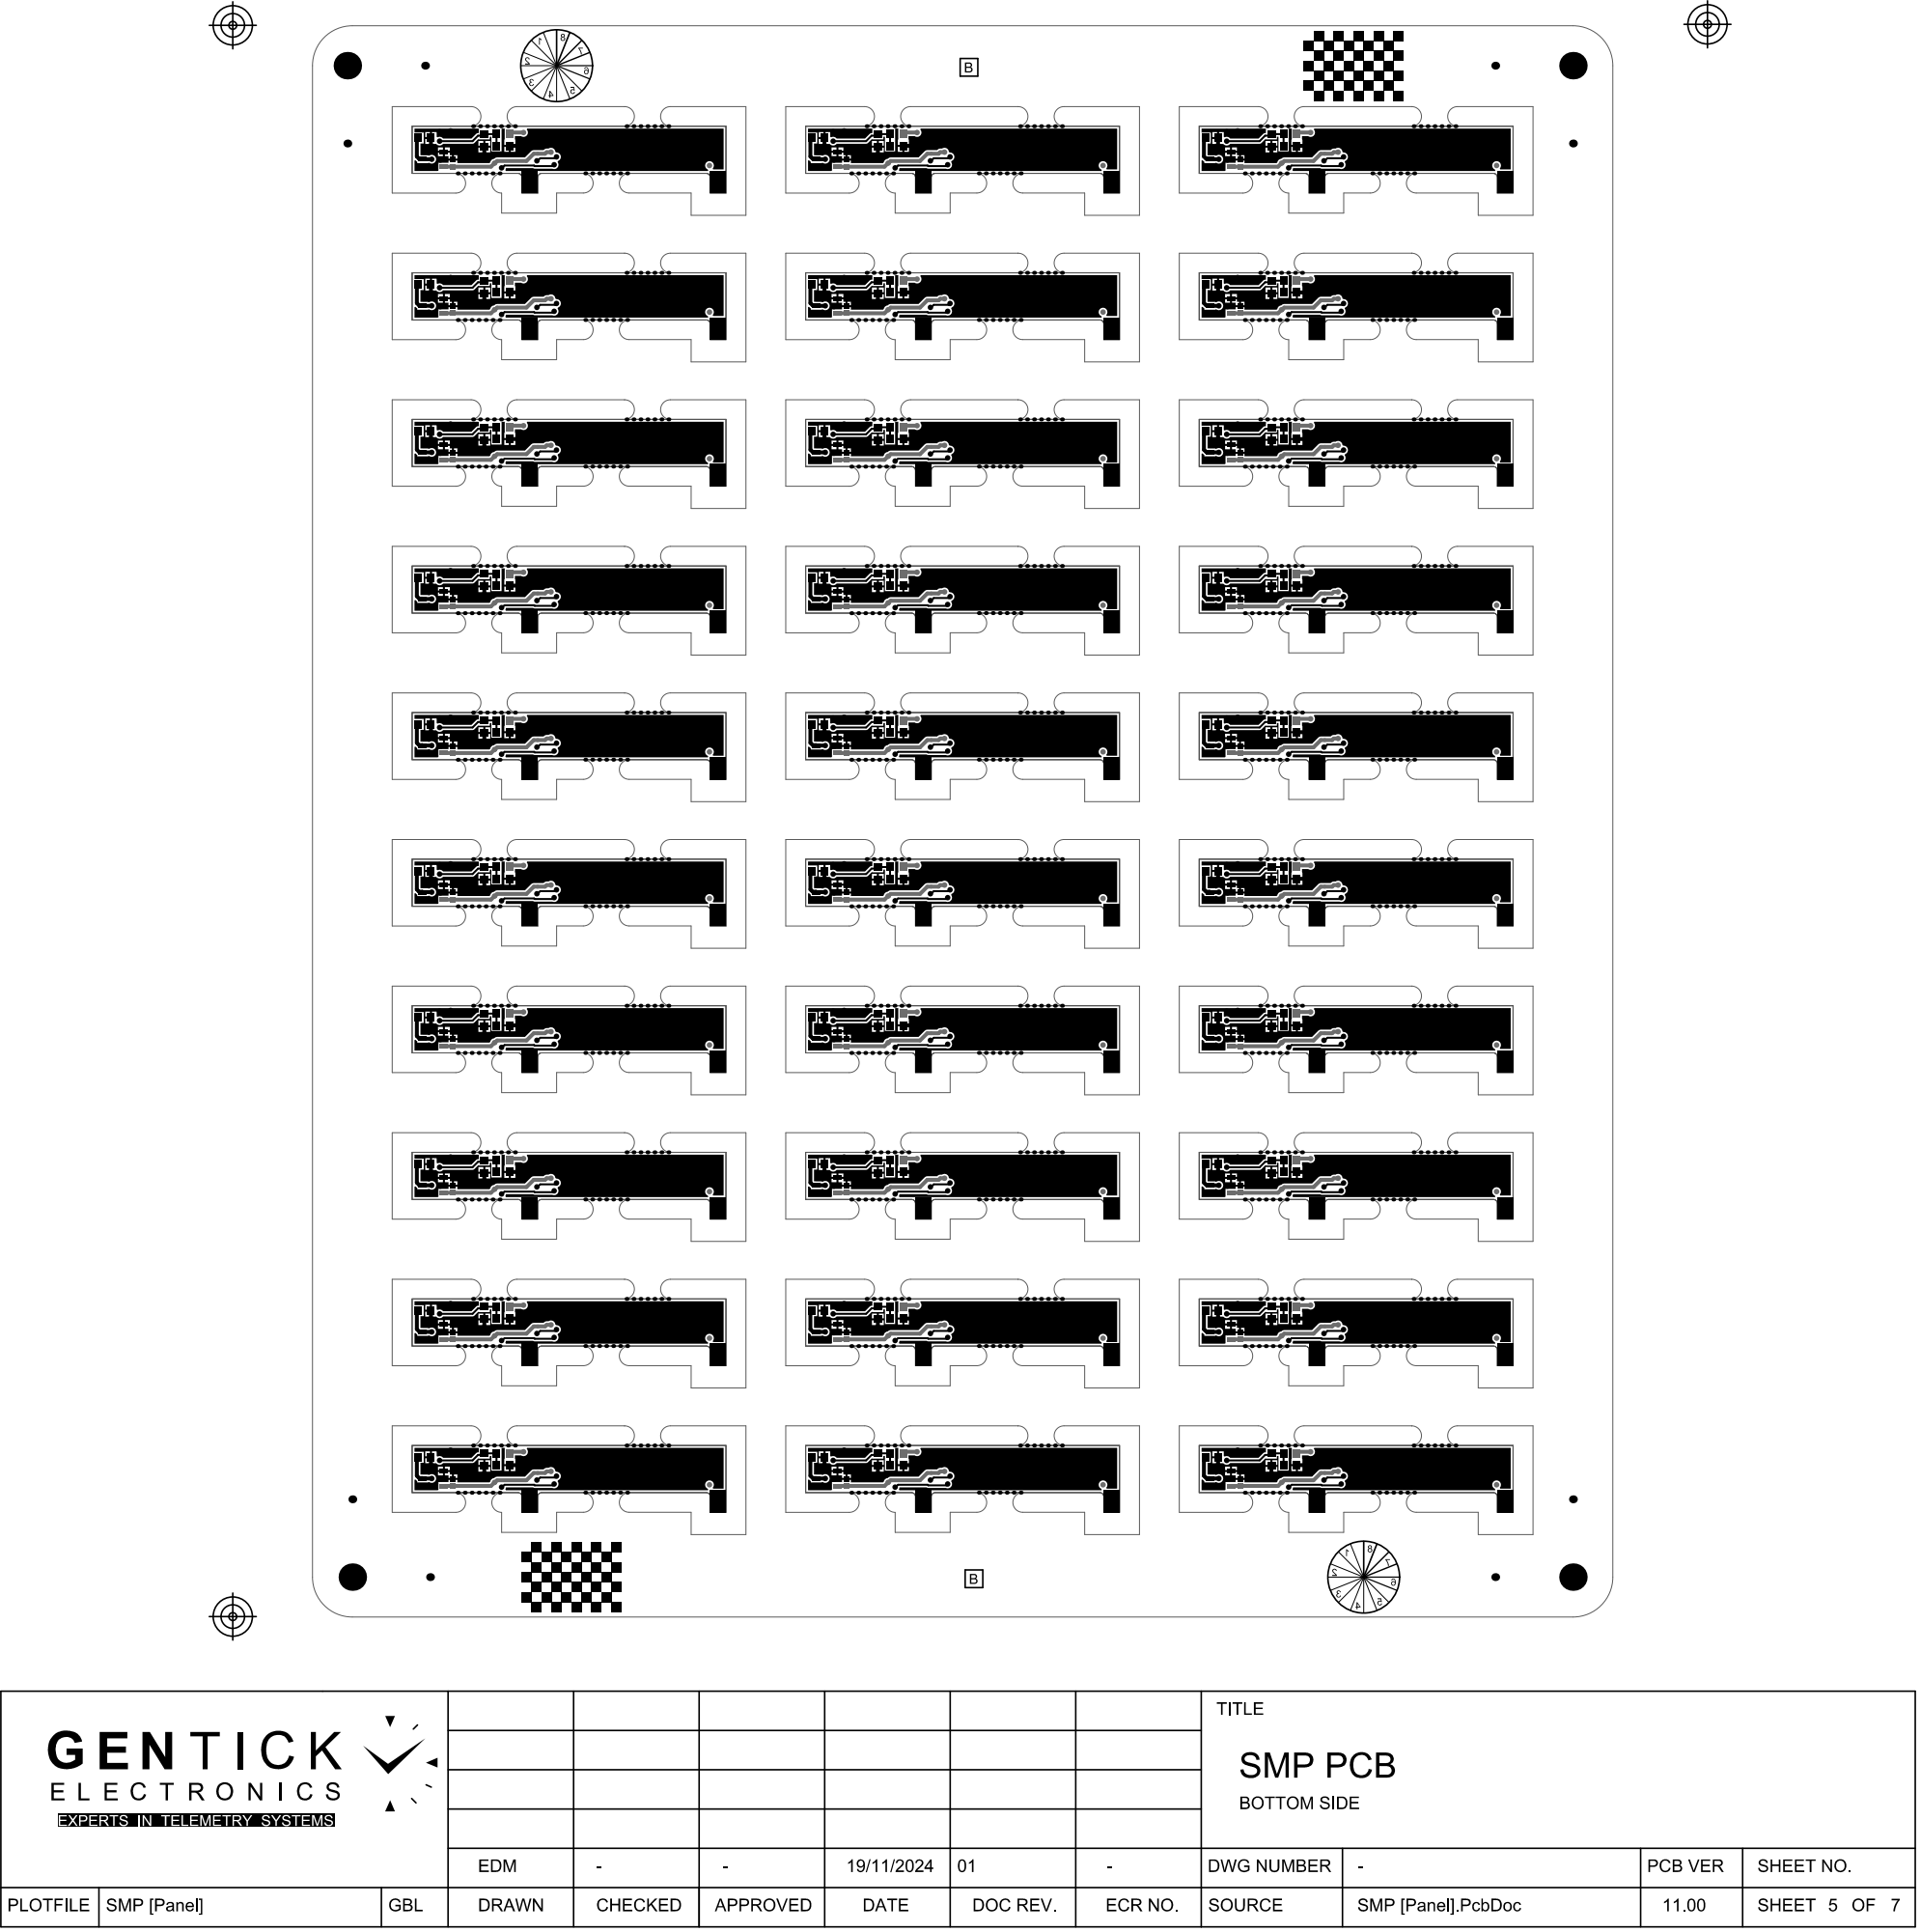
[picture p118: page 5]

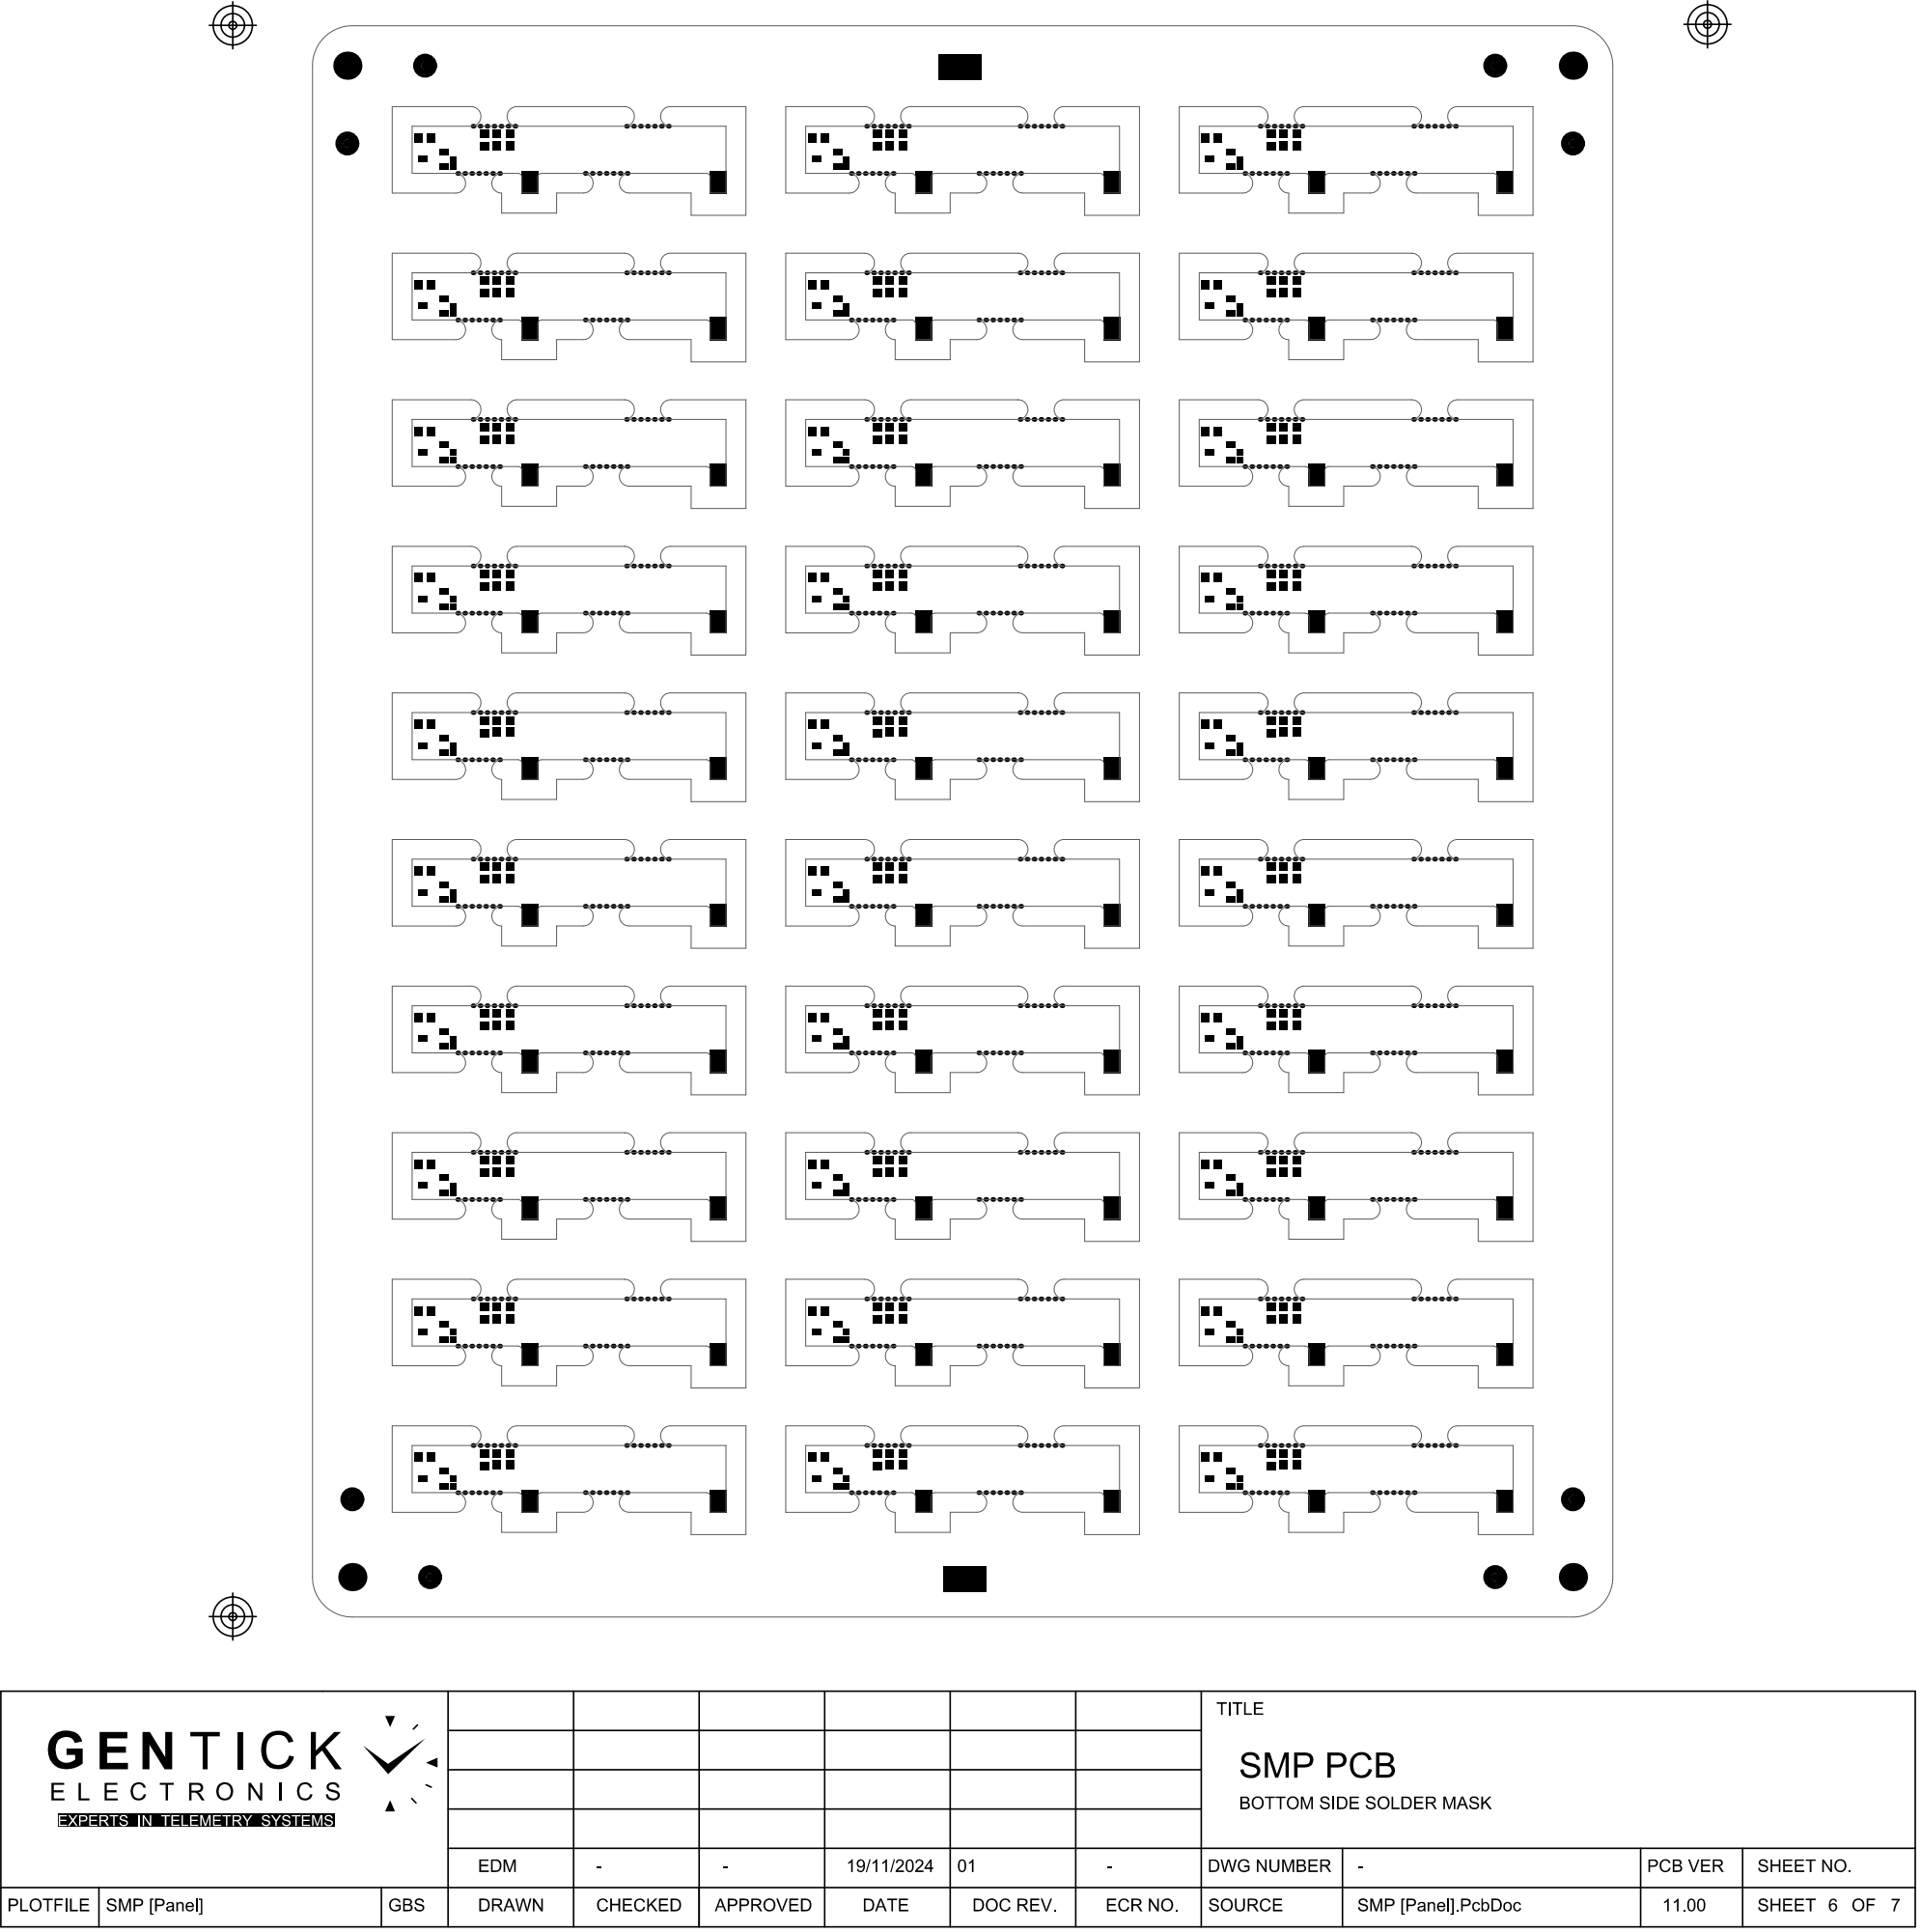
[picture p119: page 6]

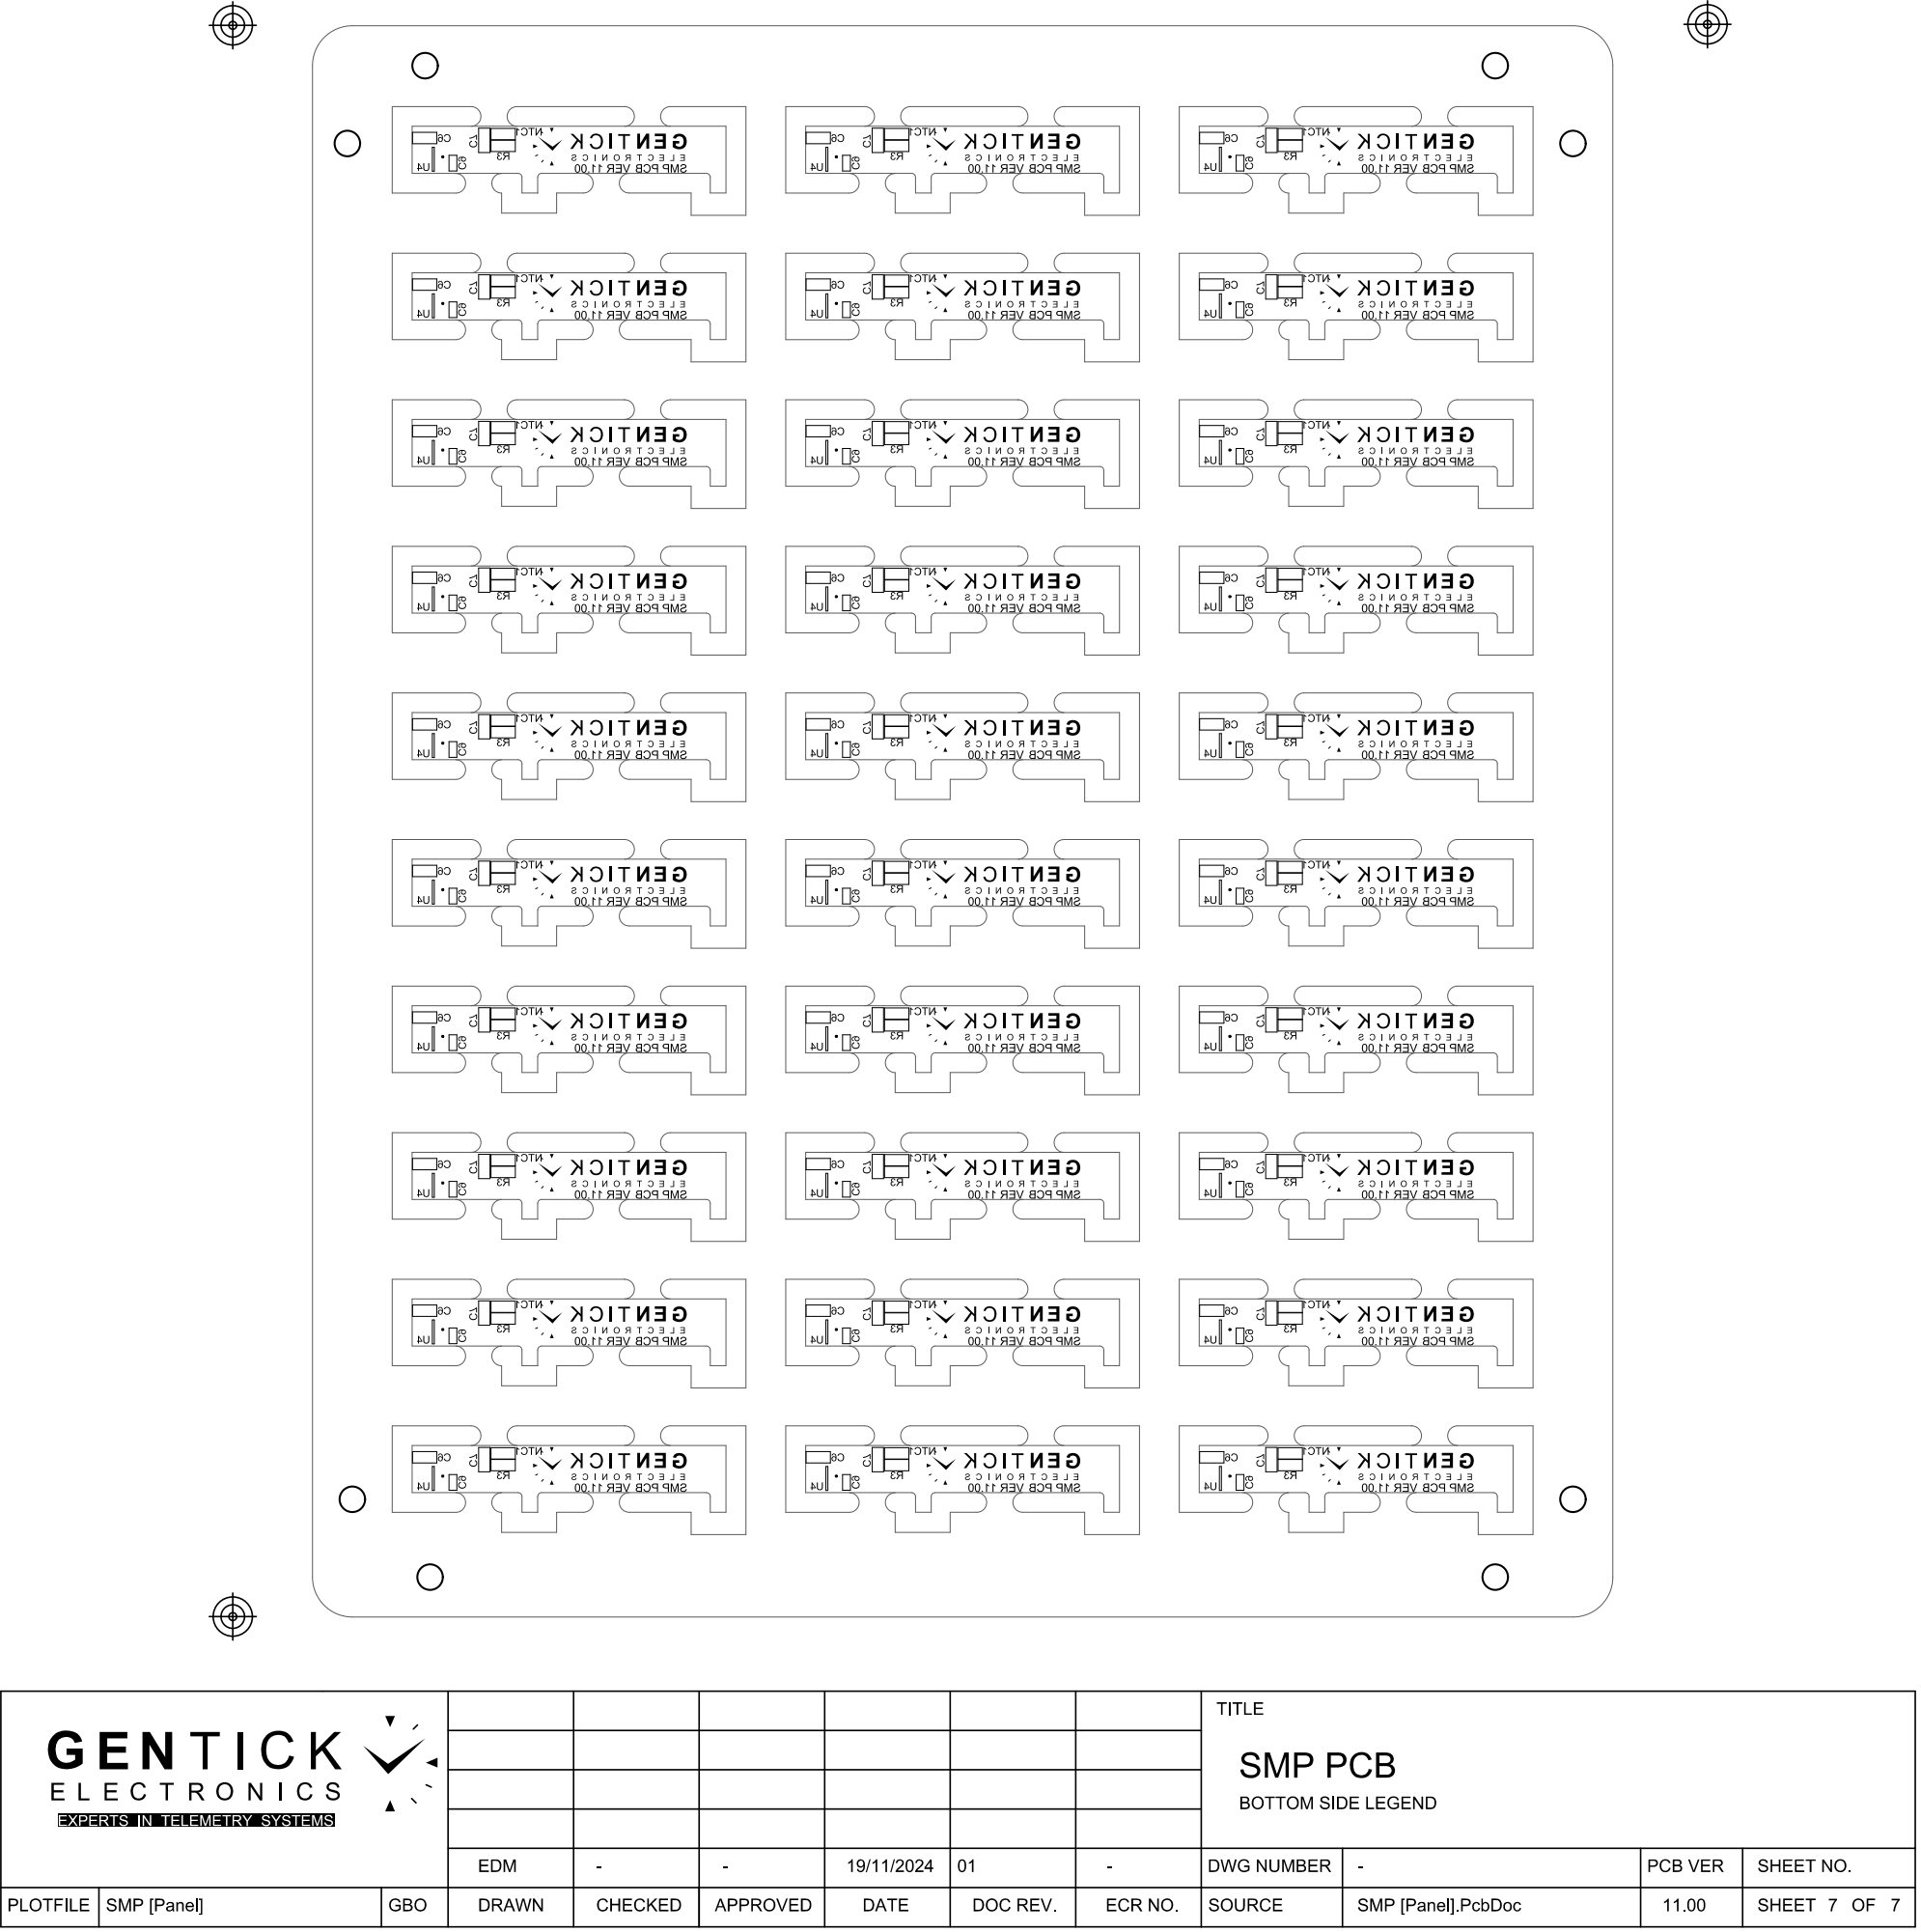
[picture p120: page 7]
