Iron-Byron/Testing-Documentation-for-SMP/Schematic of Sense boards/SMP ver 11.00/SMP ver 11.00 PCB PDF files/SMP ver 11.00 PCB PDF files/SMP ver 11.00 PCB Sch files.PDF

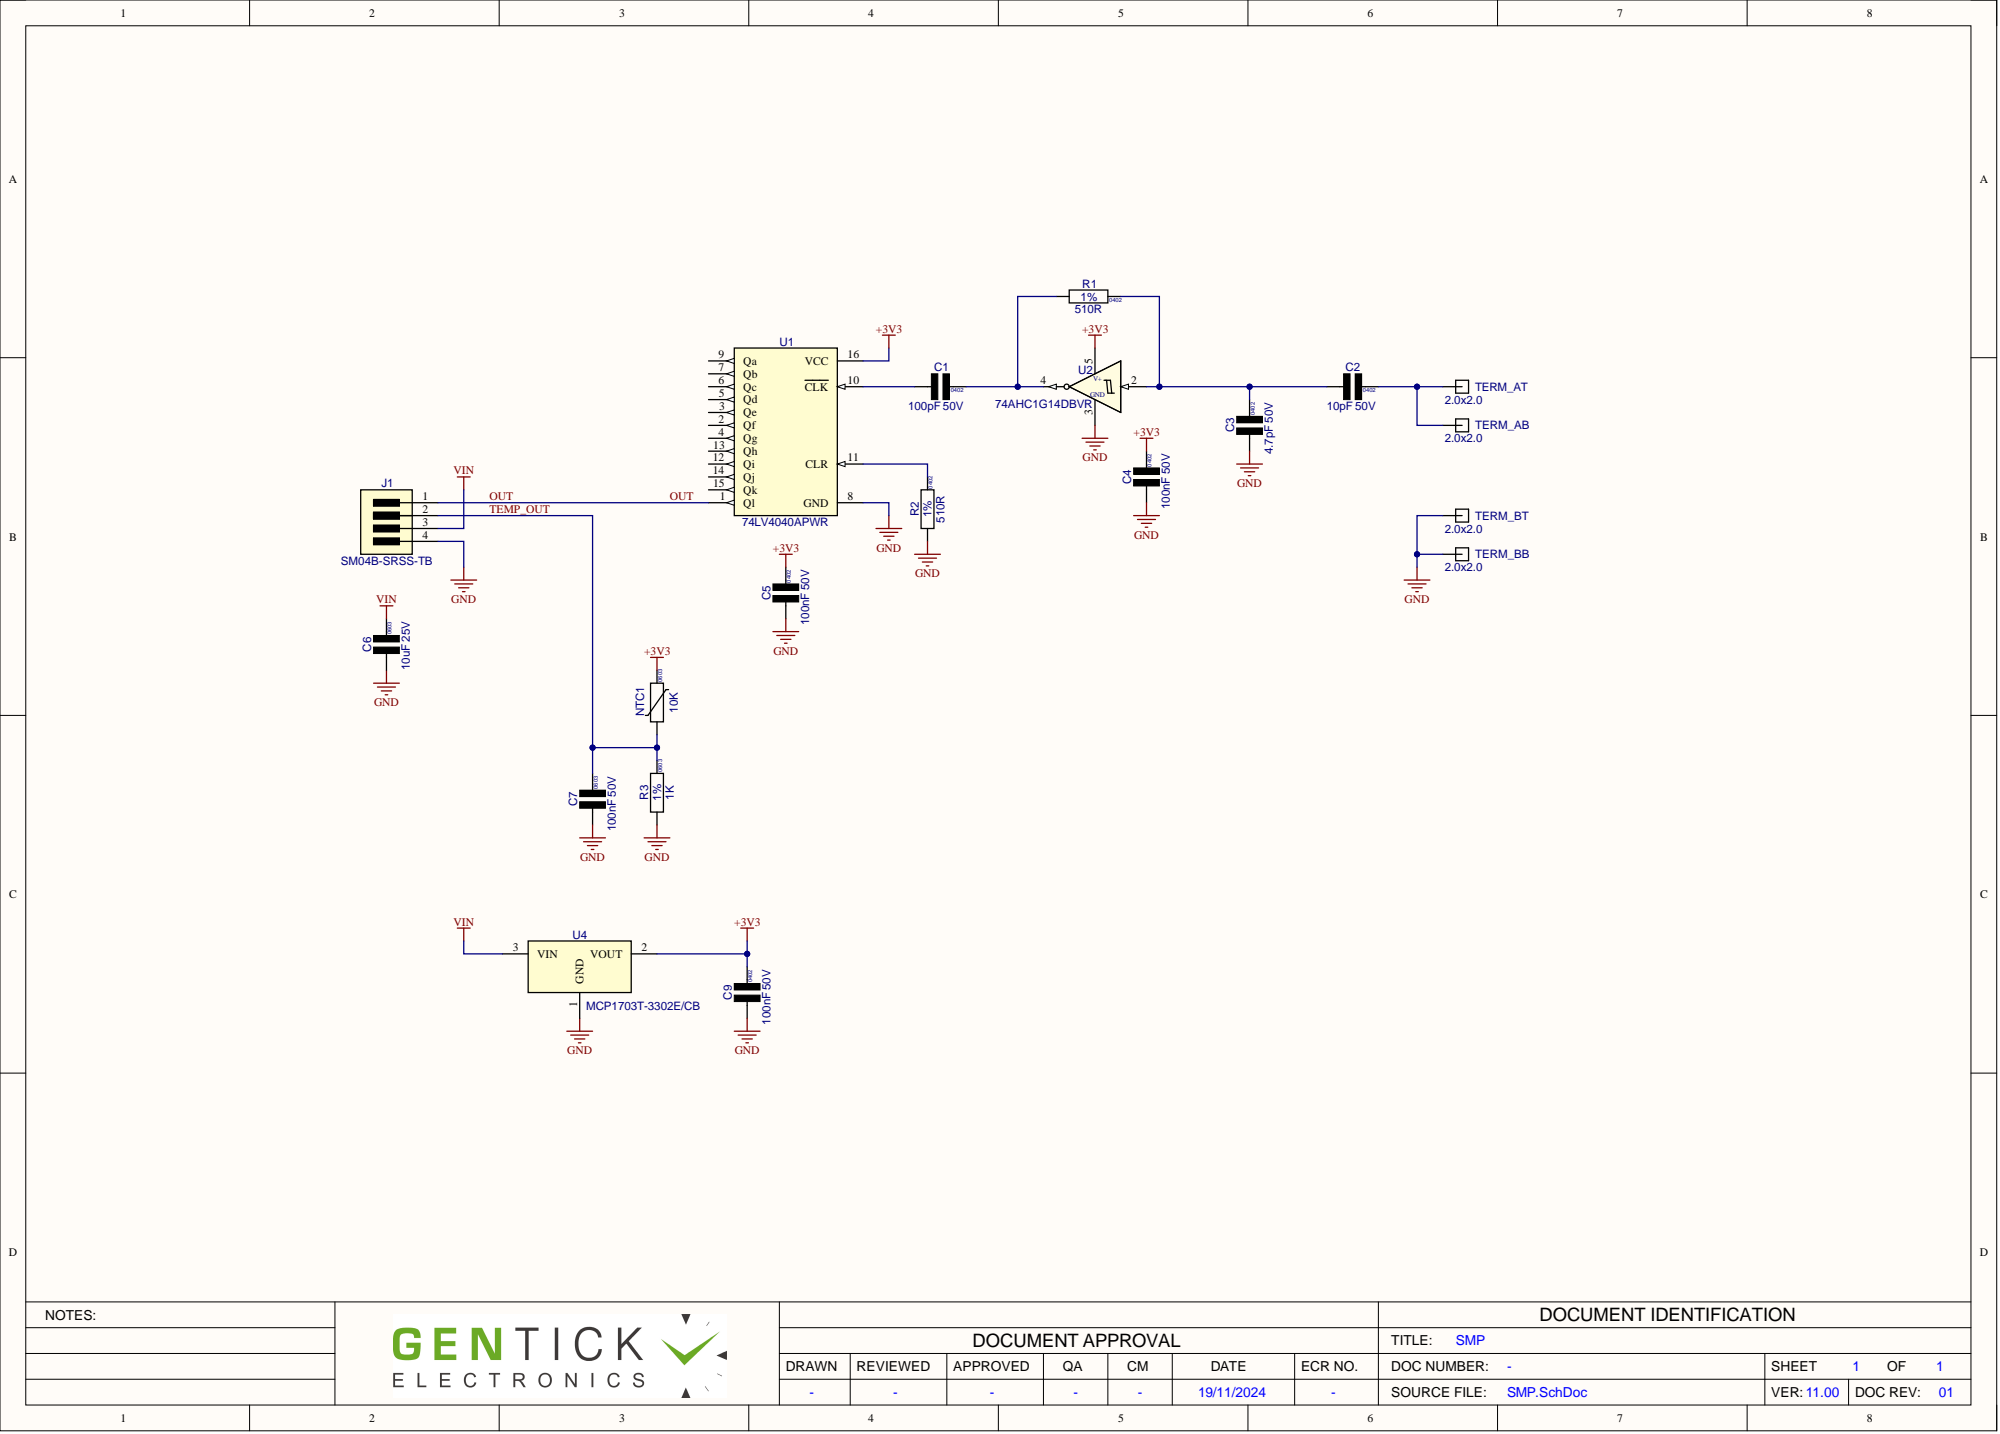
[picture p121: page 1]
