Iron-Byron/Testing-Documentation-for-SMP/Schematic of Sense boards/SMP ver 11.00/SMP ver 11.00 PCB PDF files/SMP ver 11.00 PCB PDF files/SMP ver 11.00 PCB Stencil files.PDF

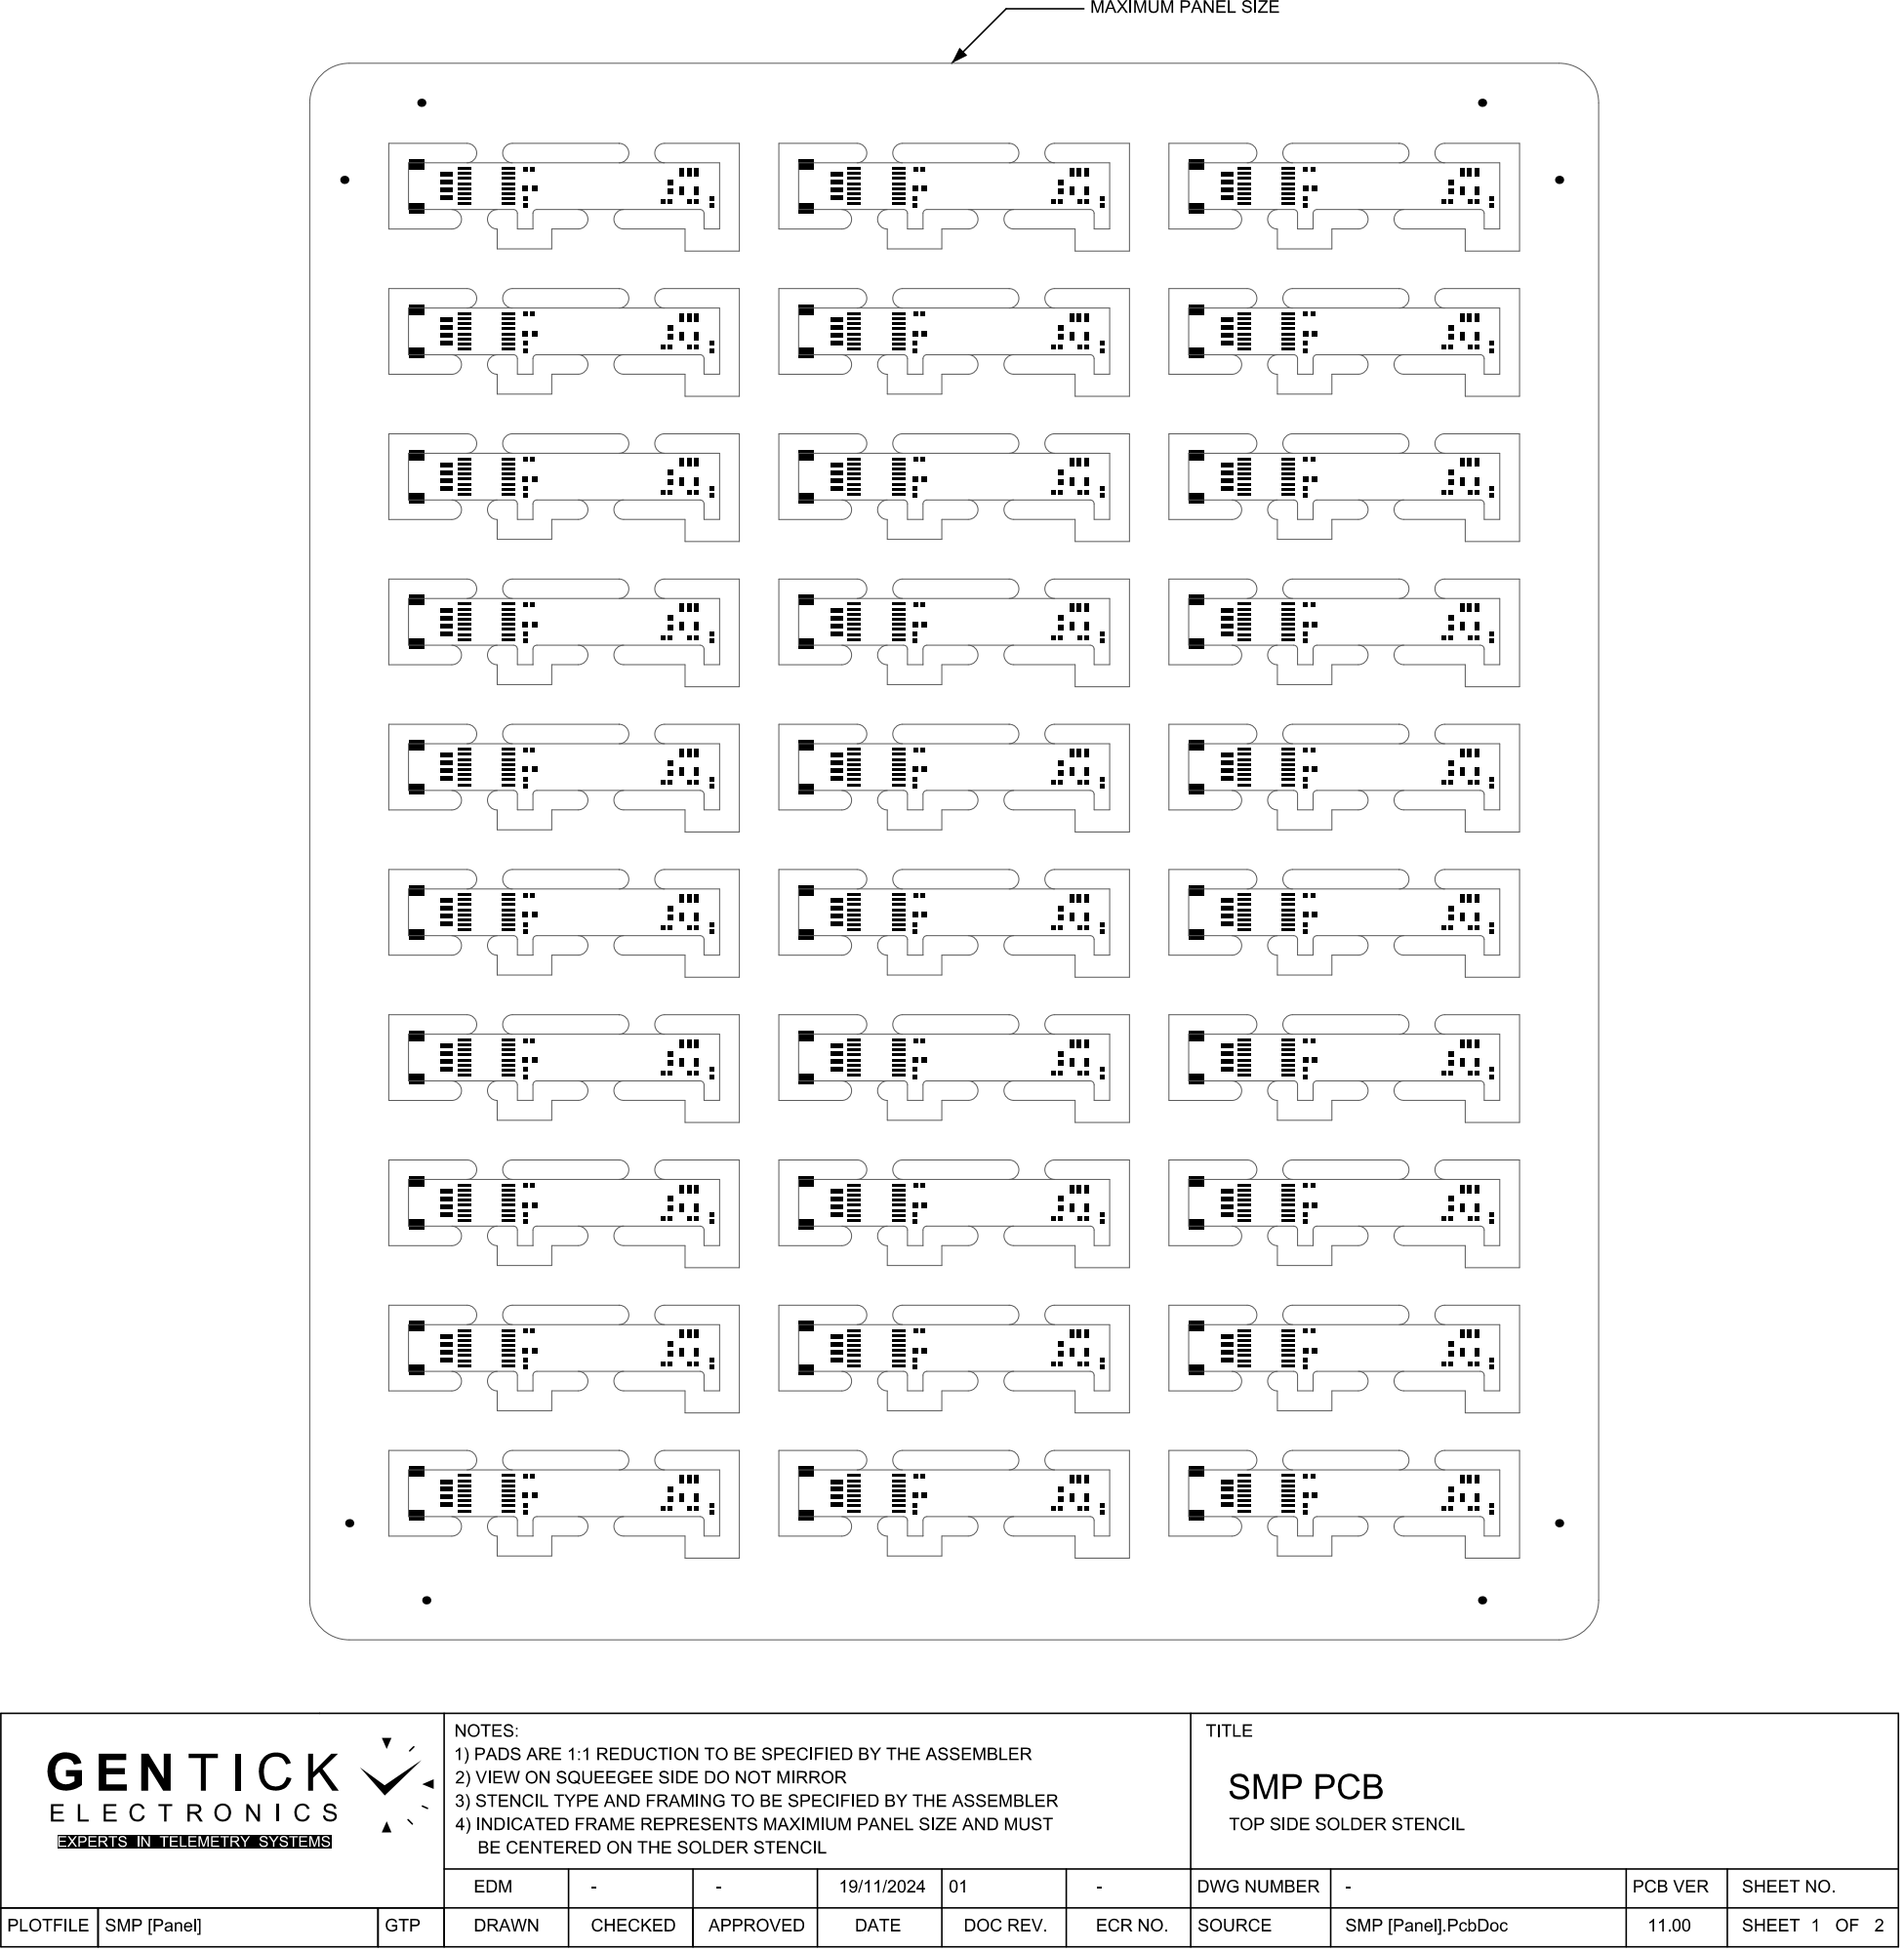
[picture p122: page 1]

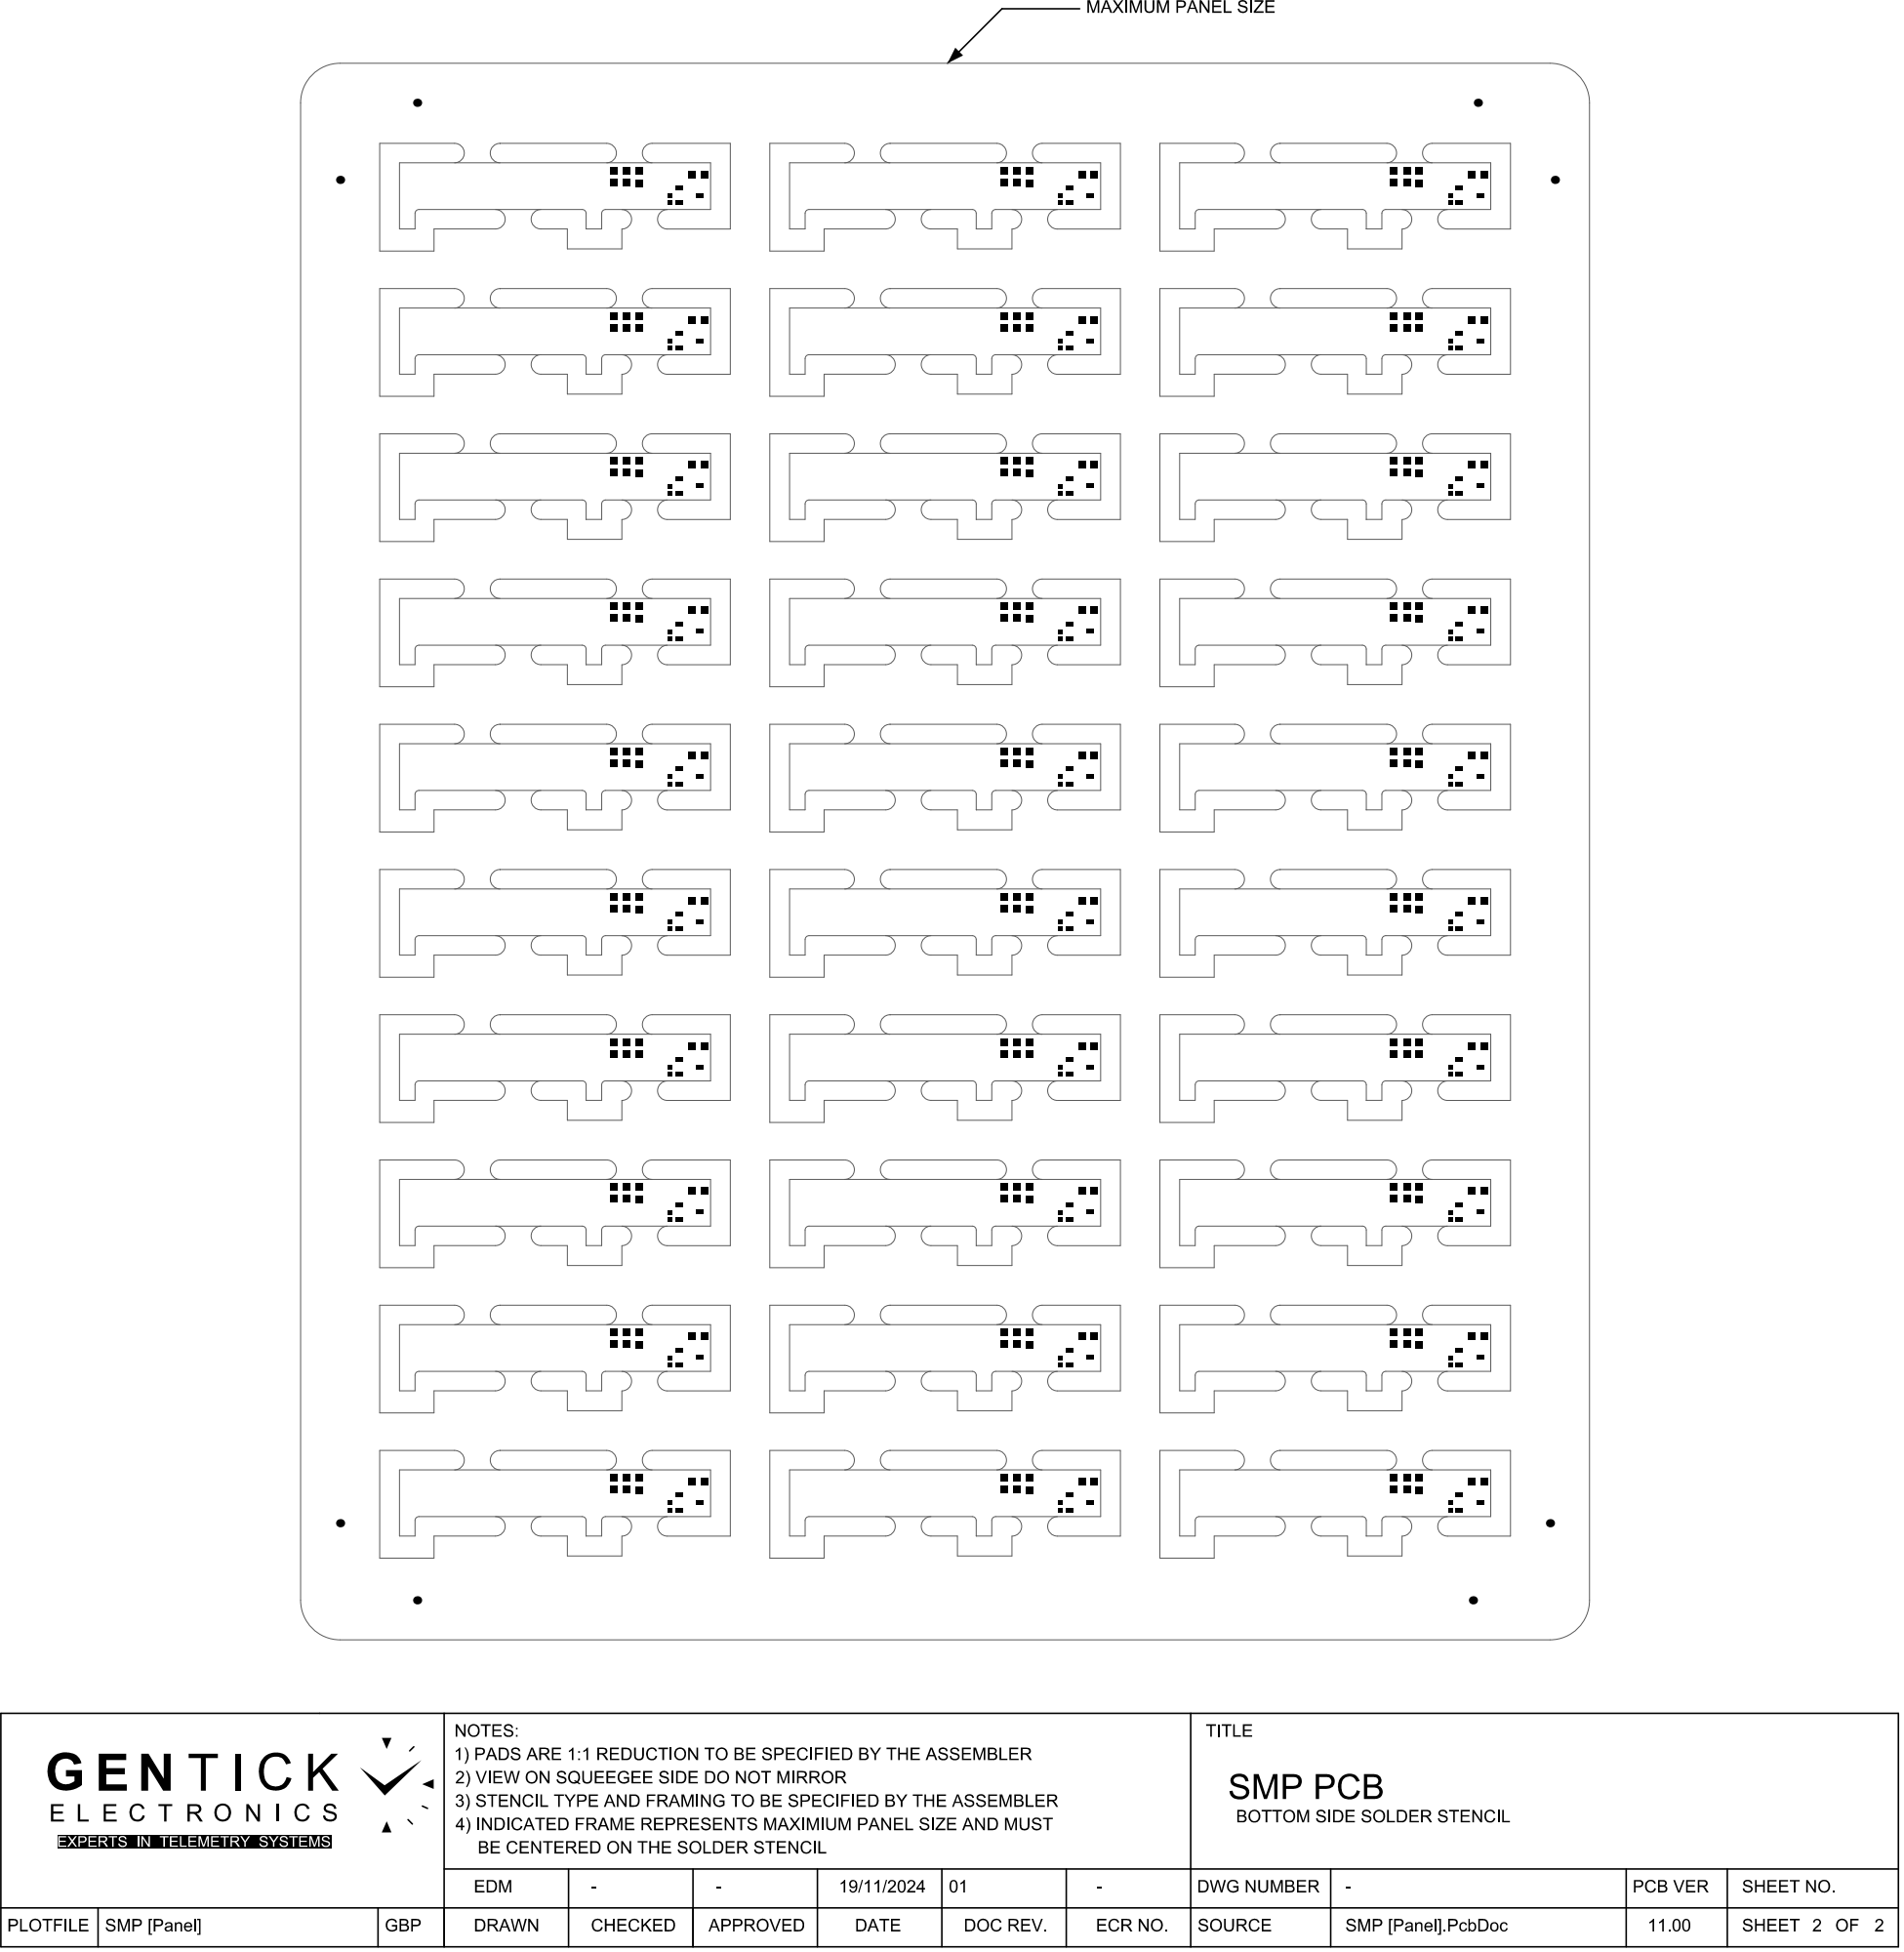
[picture p123: page 2]
