Iron-Byron/Testing-Documentation-for-SMP/Schematic of Sense boards/SMP ver 10.00/SMP ver 10.00 PCB PDF files/SMP ver 10.00 PCB Assy files.PDF

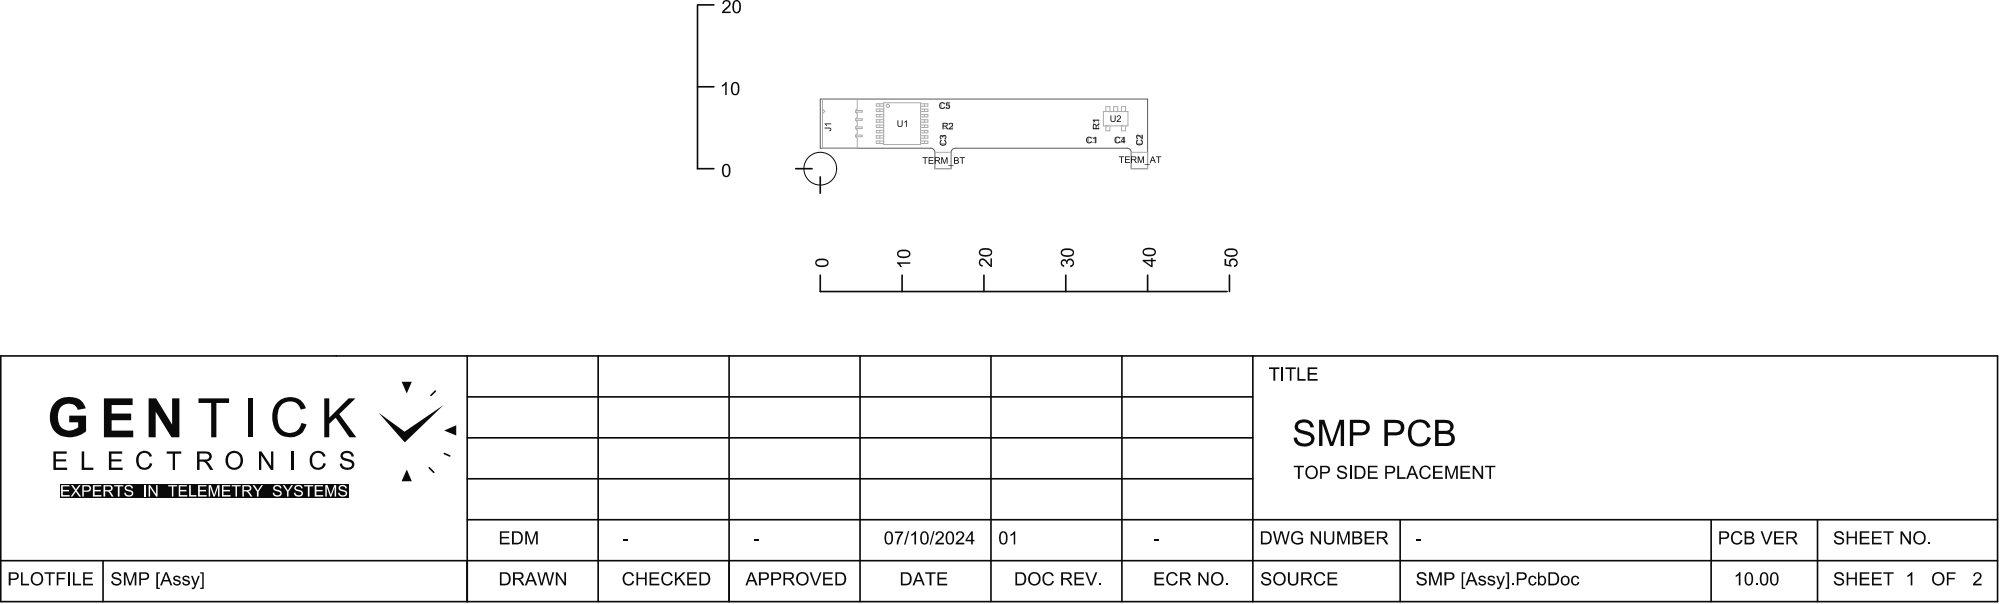
[picture p124: page 1]

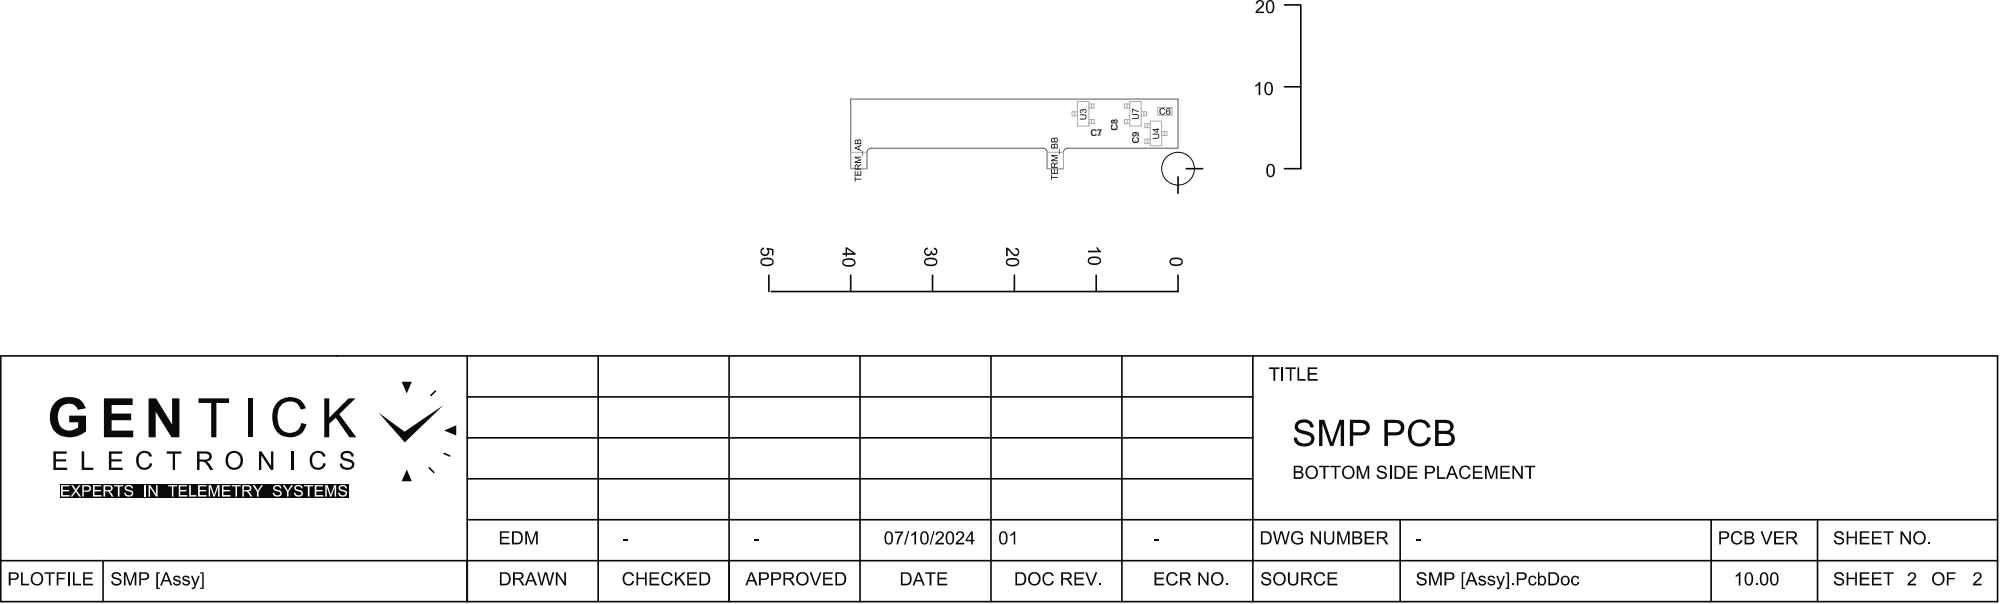
[picture p125: page 2]
