Iron-Byron/Testing-Documentation-for-SMP/Schematic of Sense boards/SMP ver 10.00/SMP ver 10.00 PCB PDF files/SMP ver 10.00 PCB Mfg files.PDF

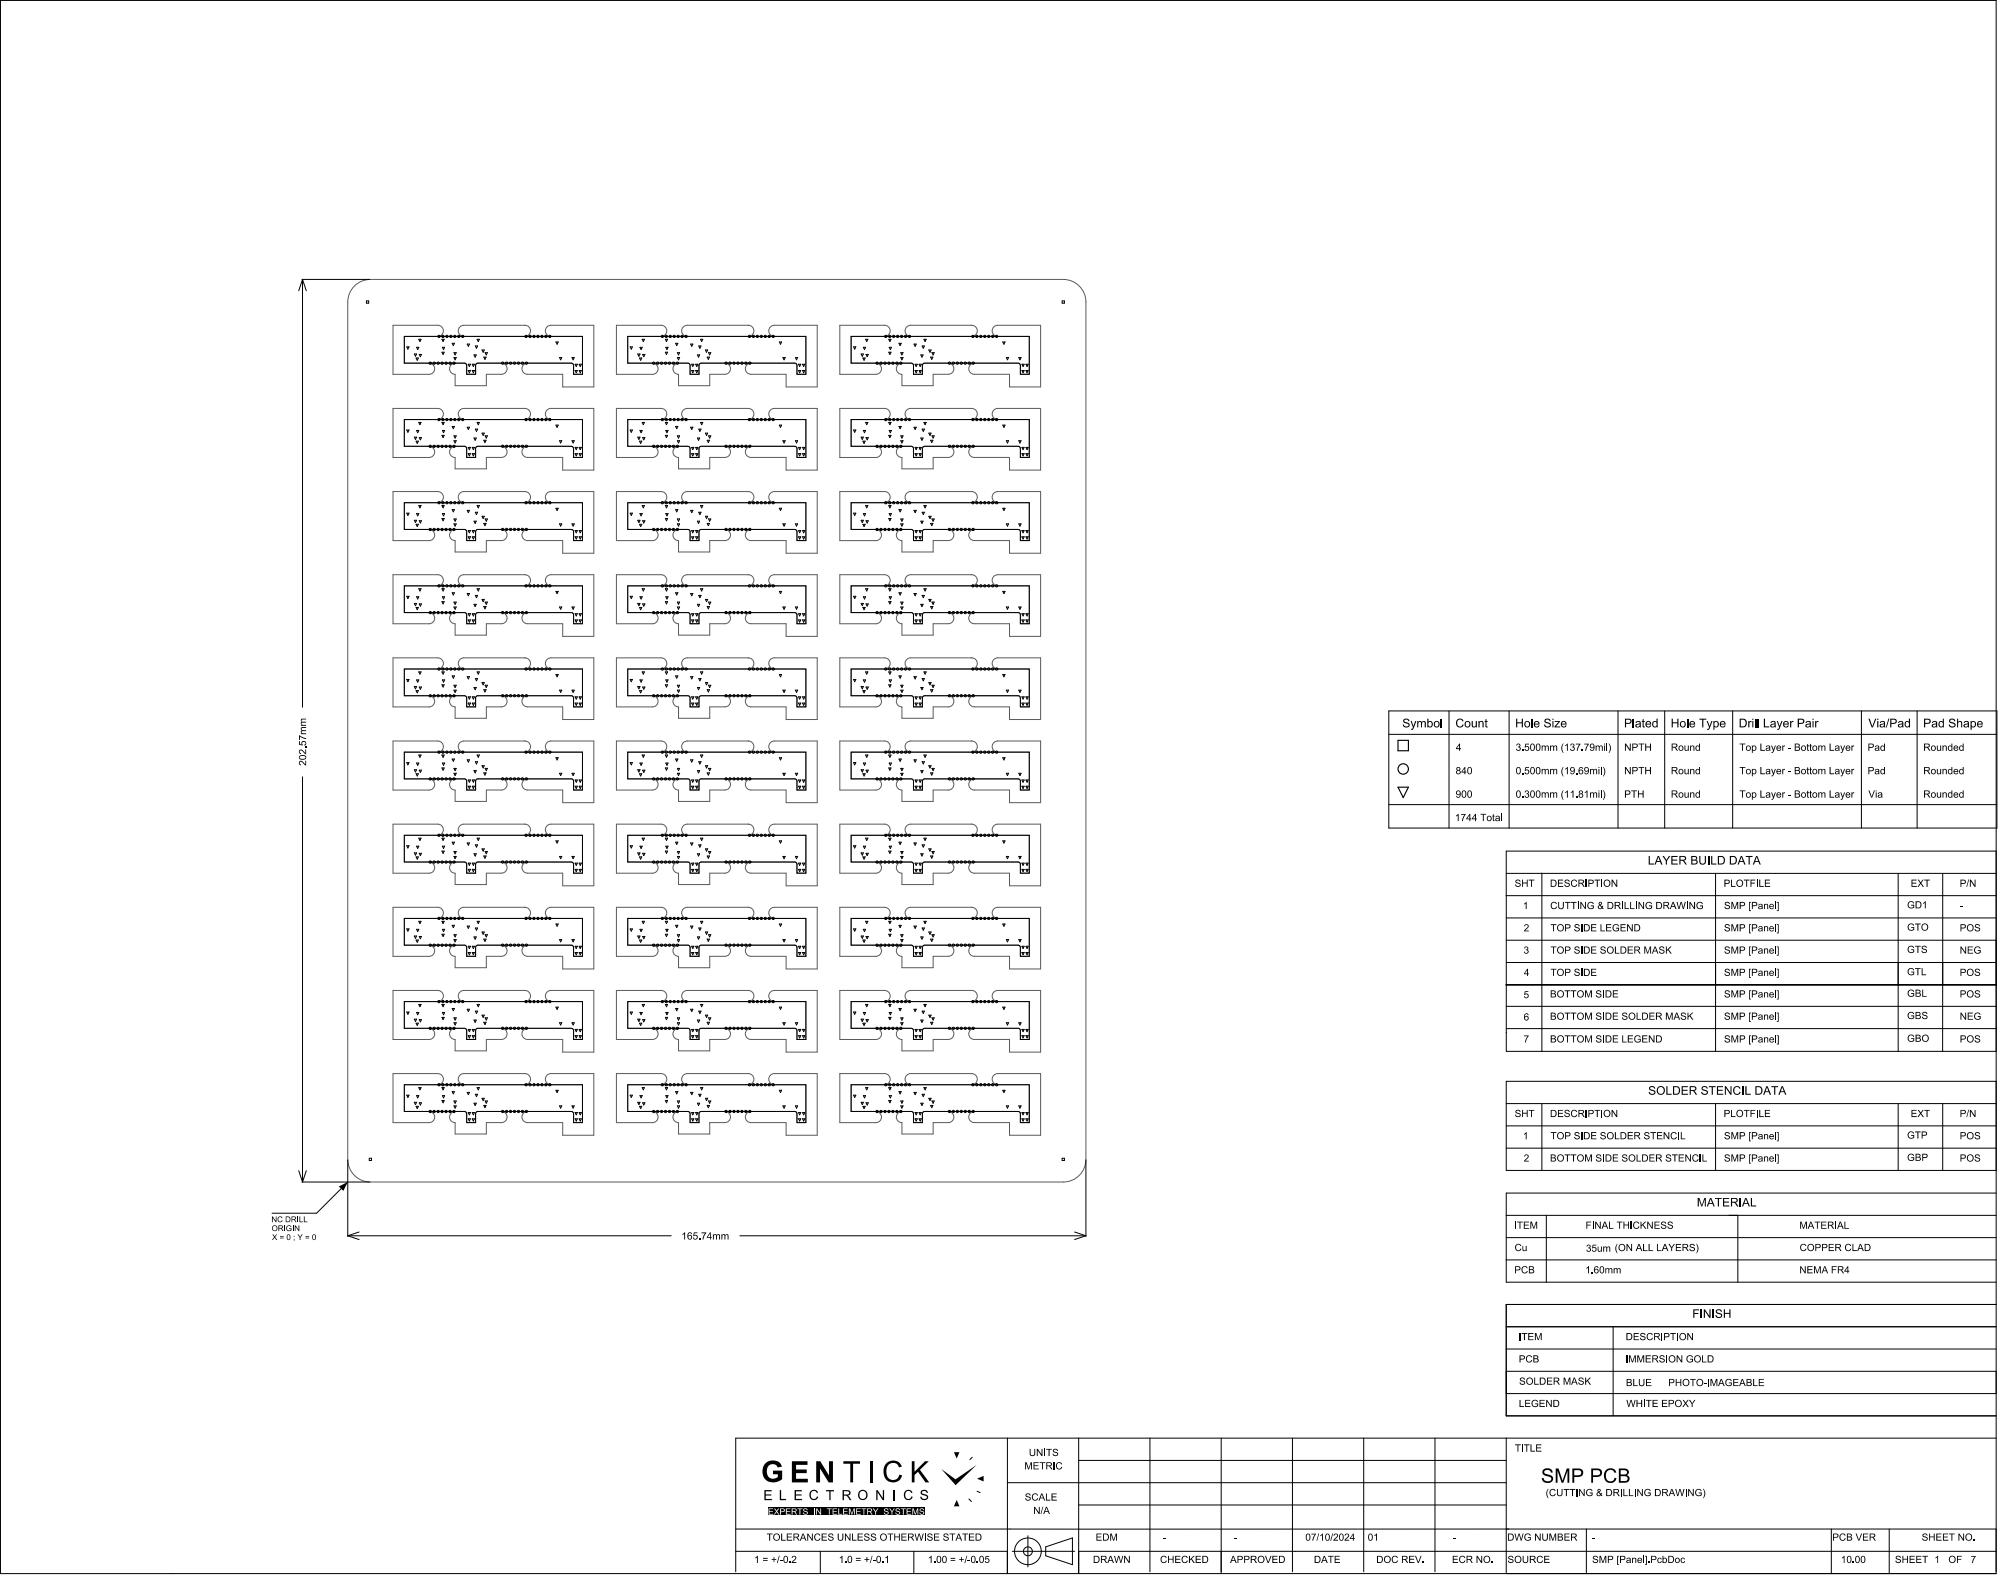
[picture p126: page 1]

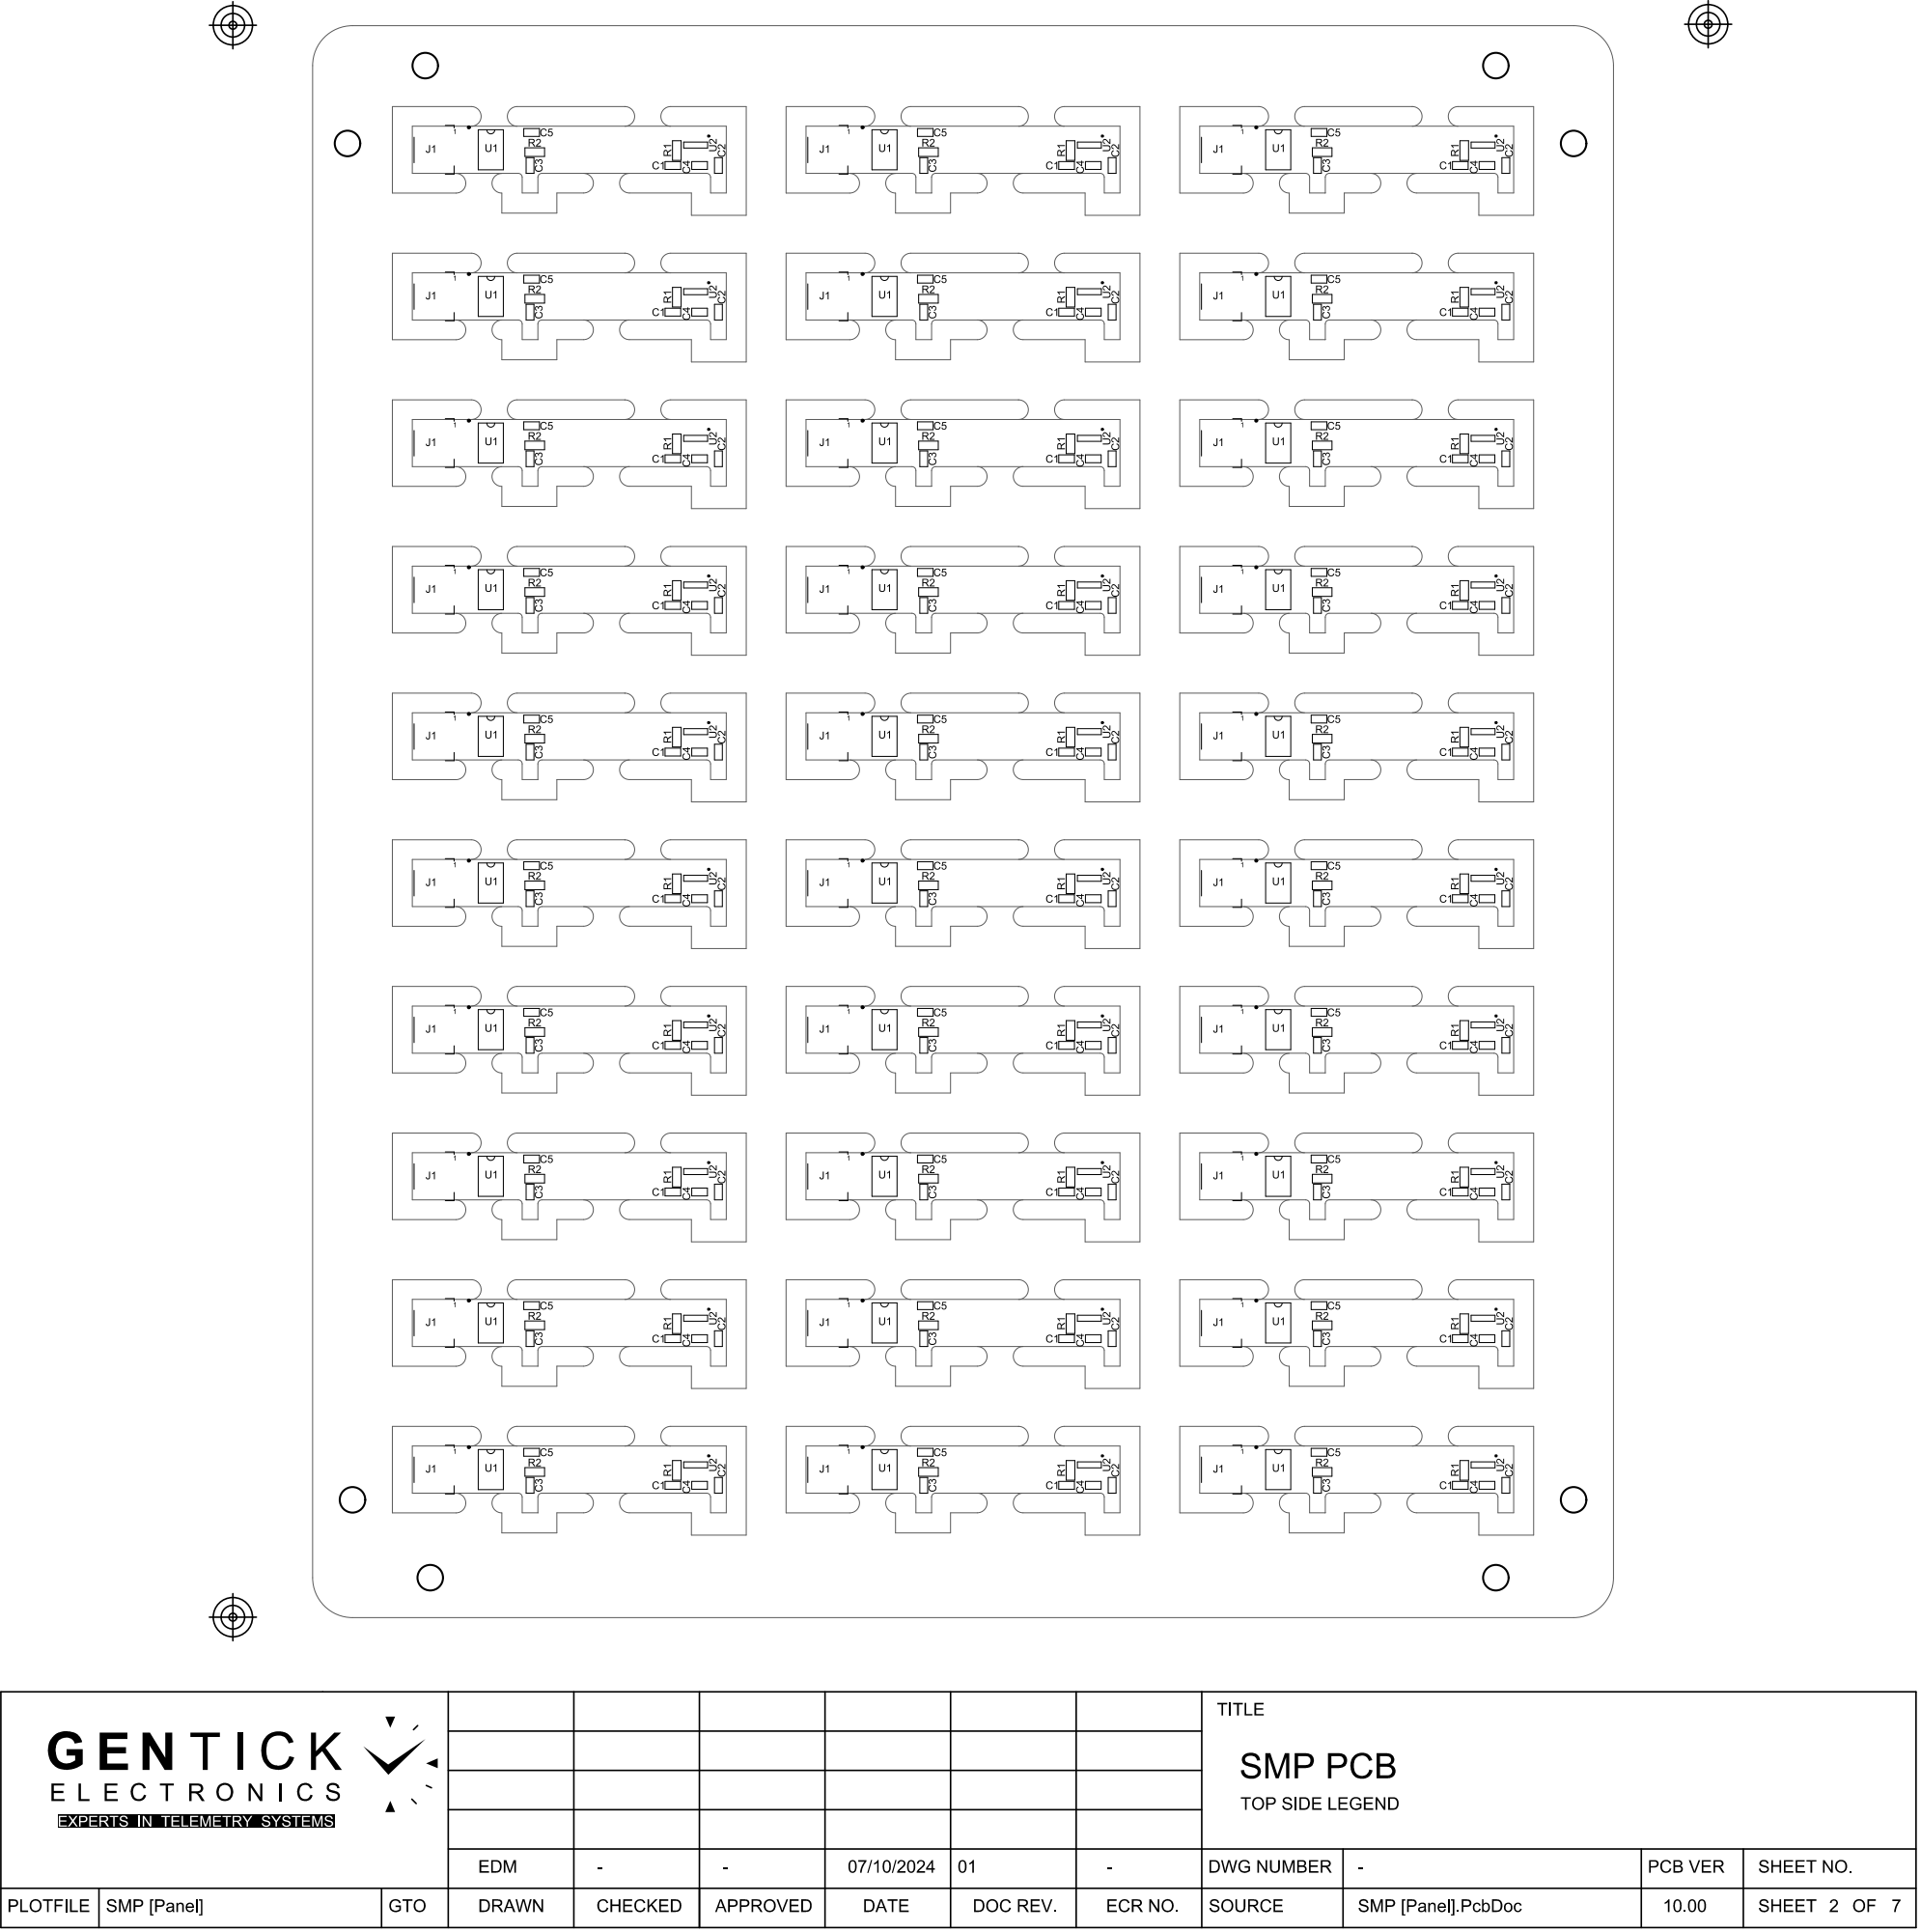
[picture p127: page 2]

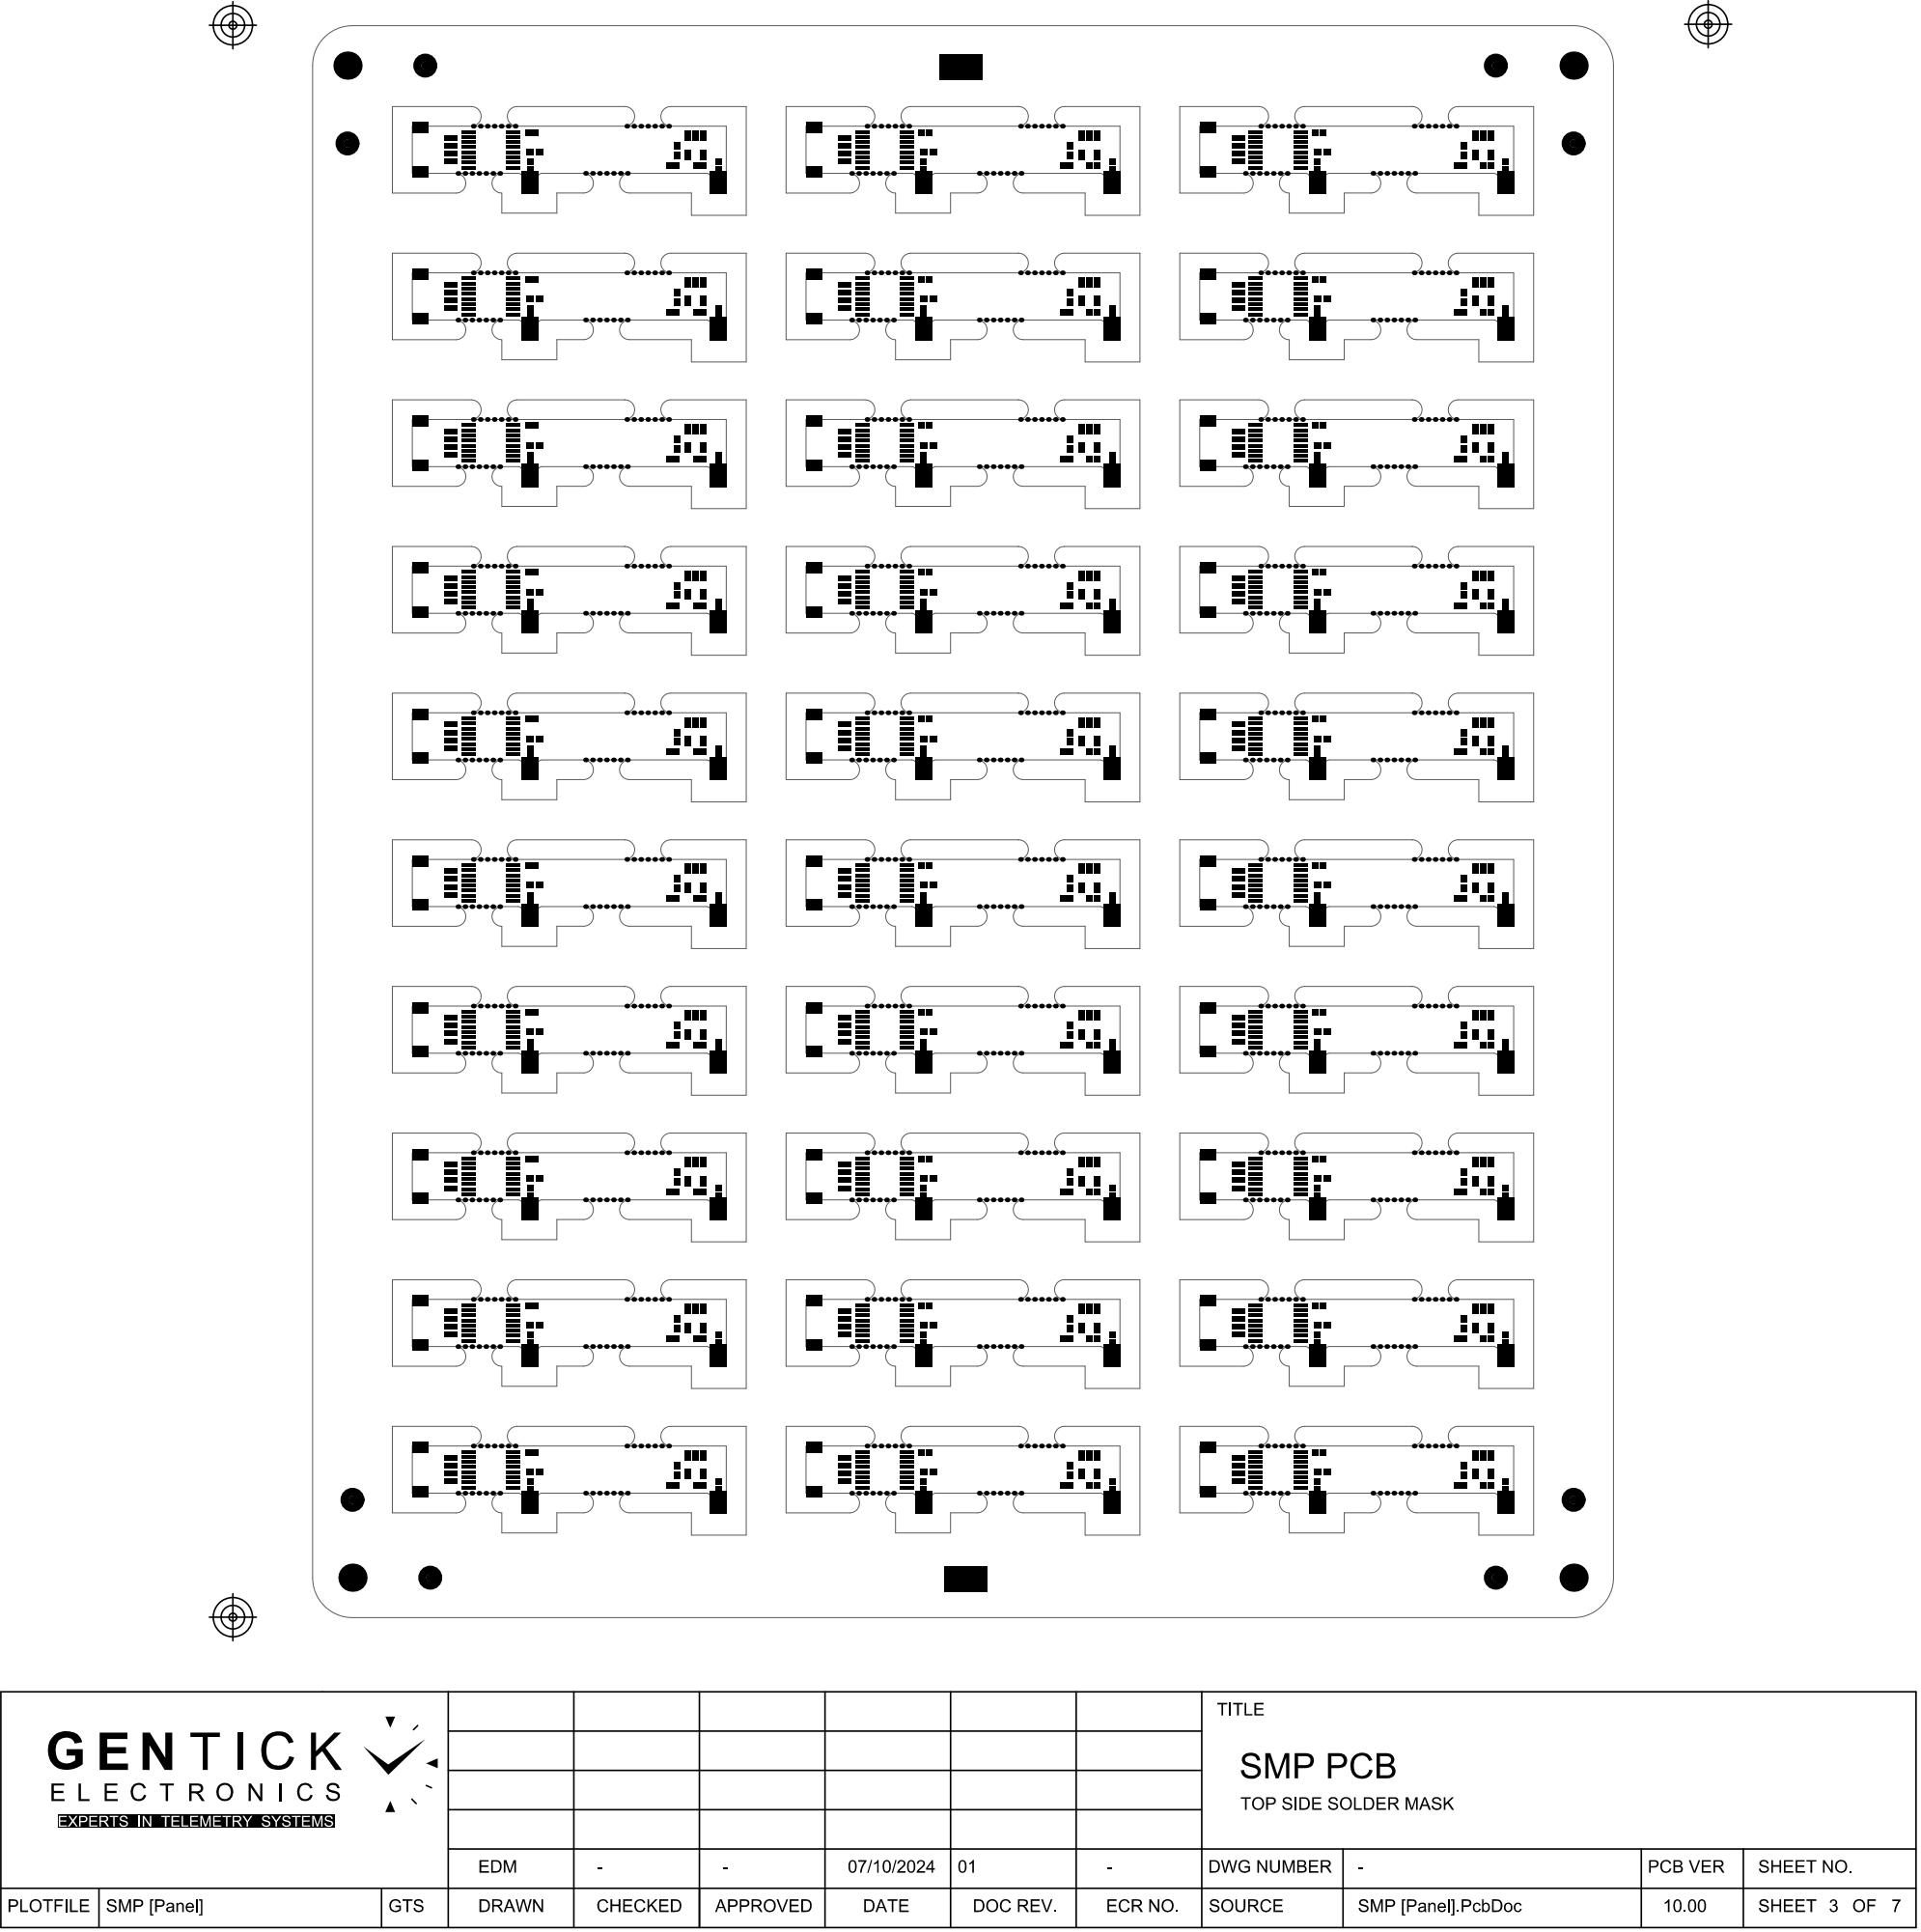
[picture p128: page 3]

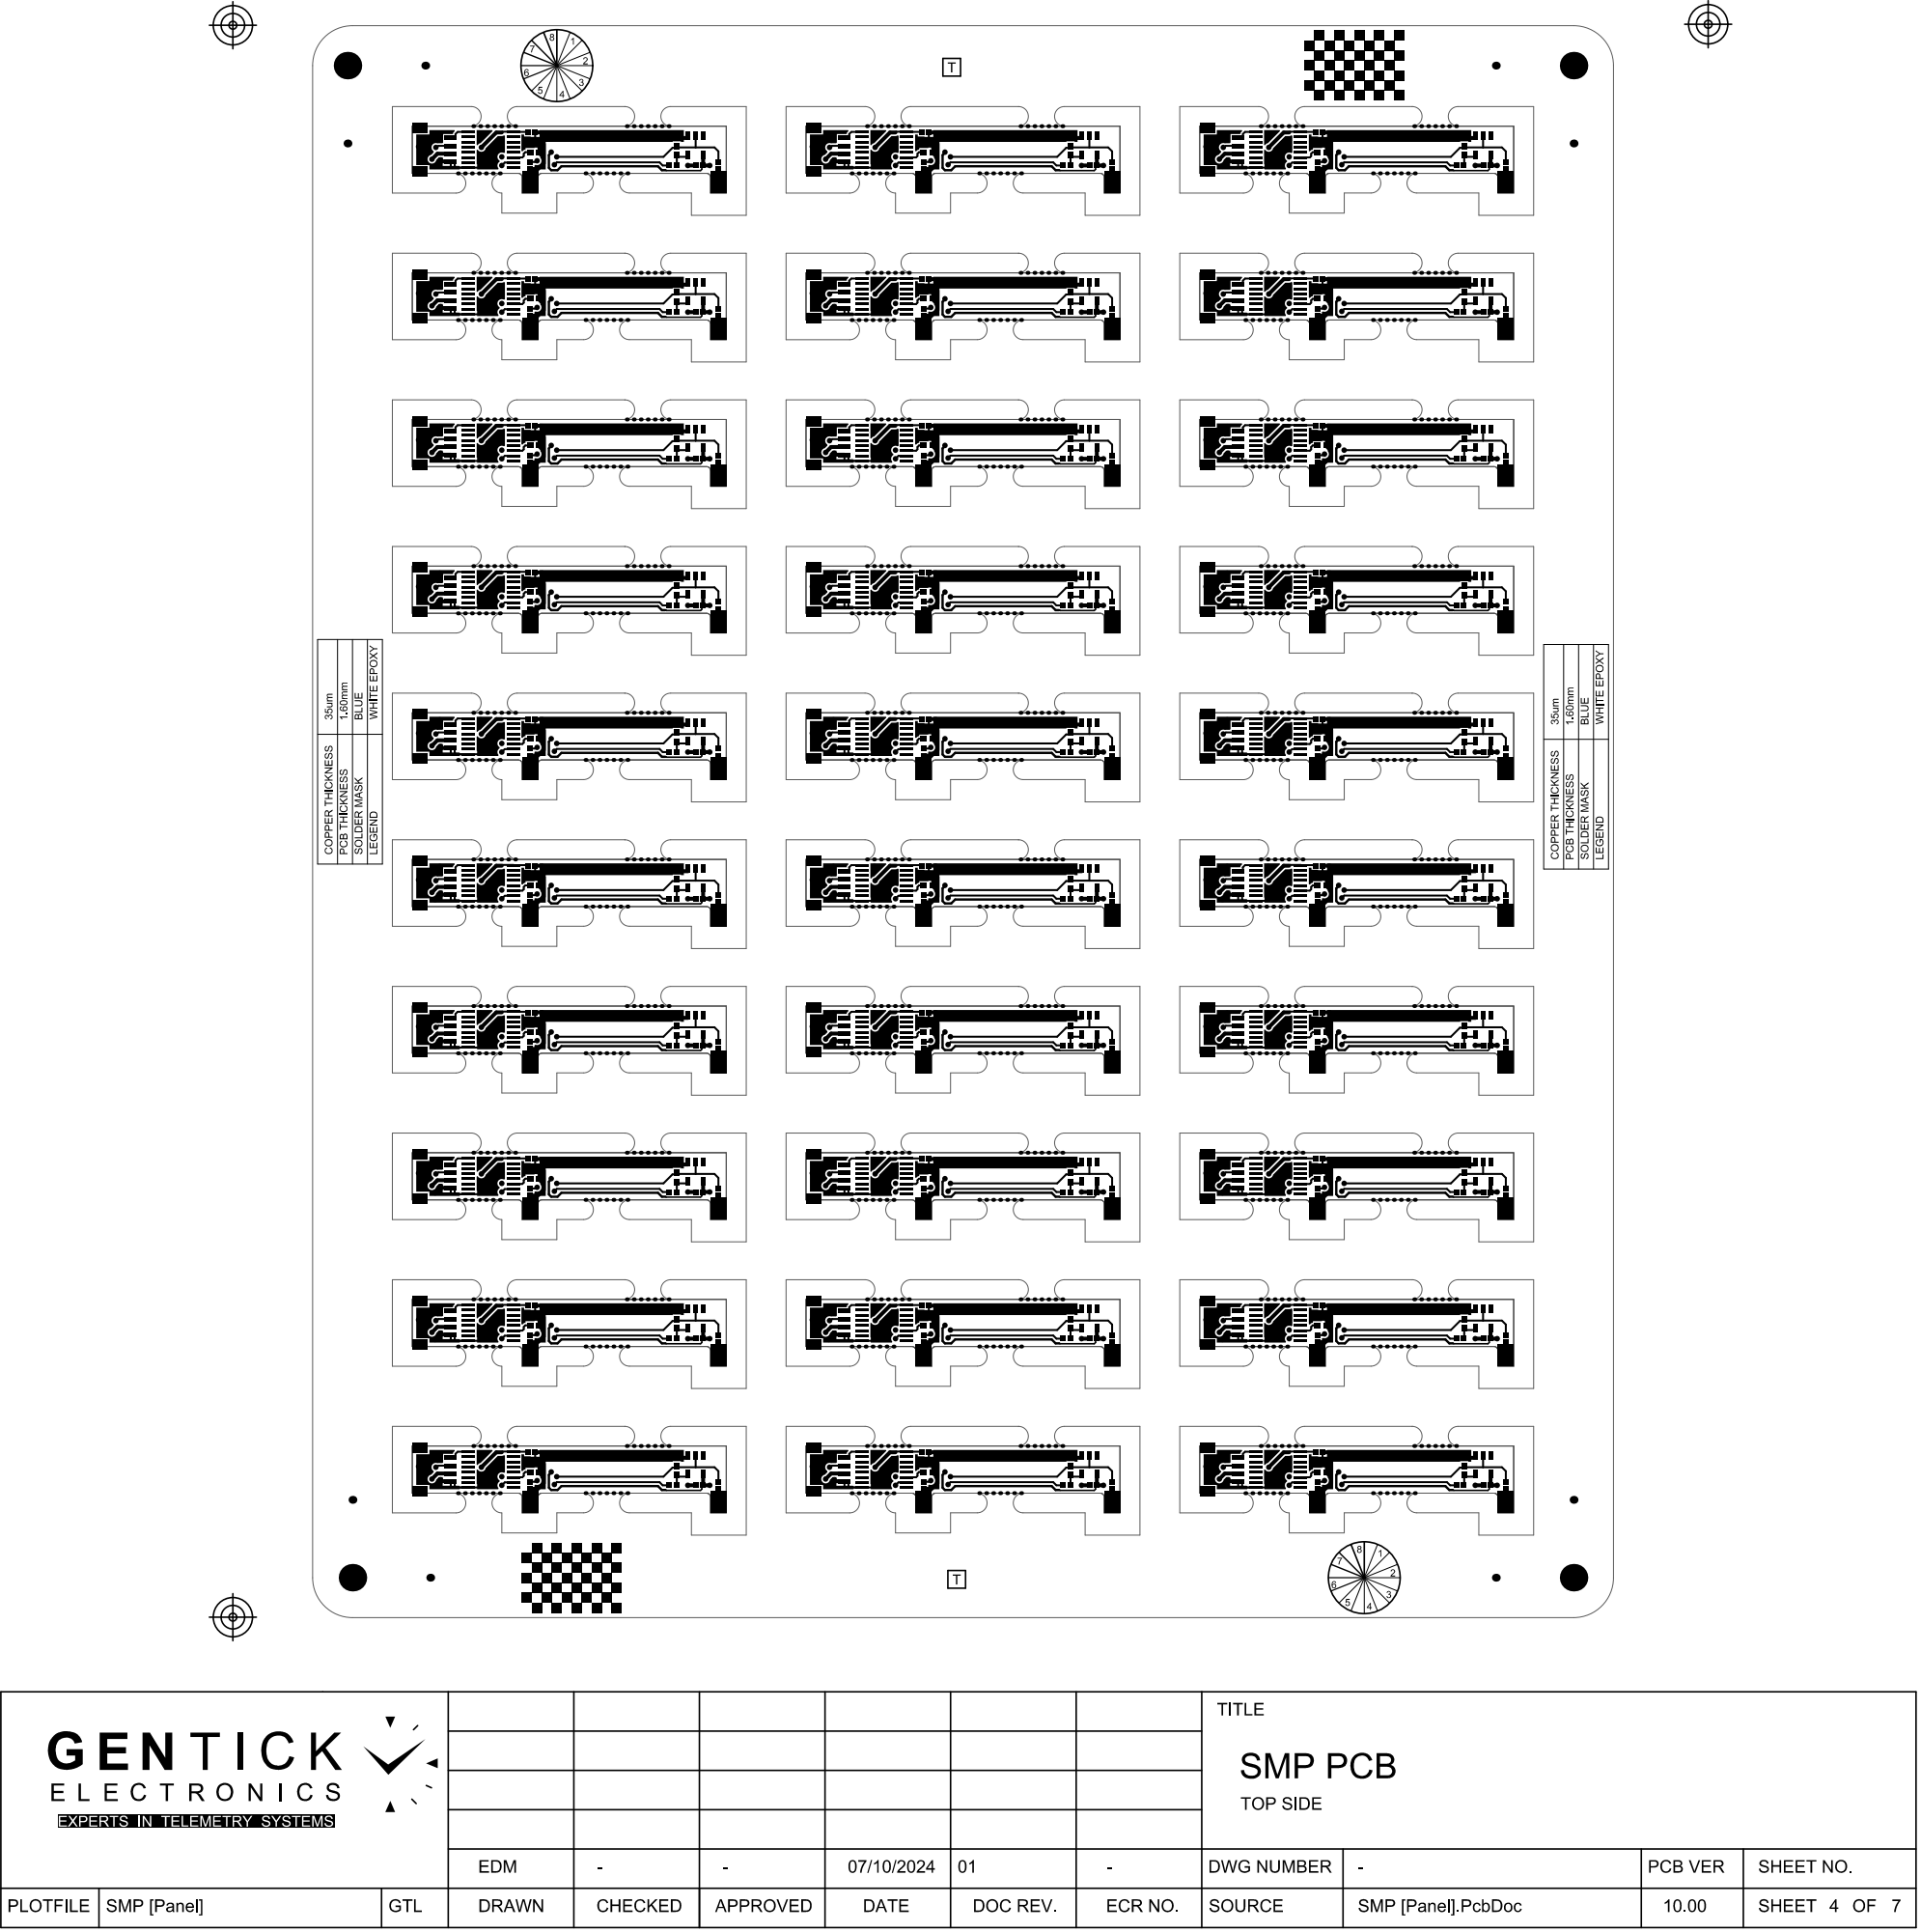
[picture p129: page 4]

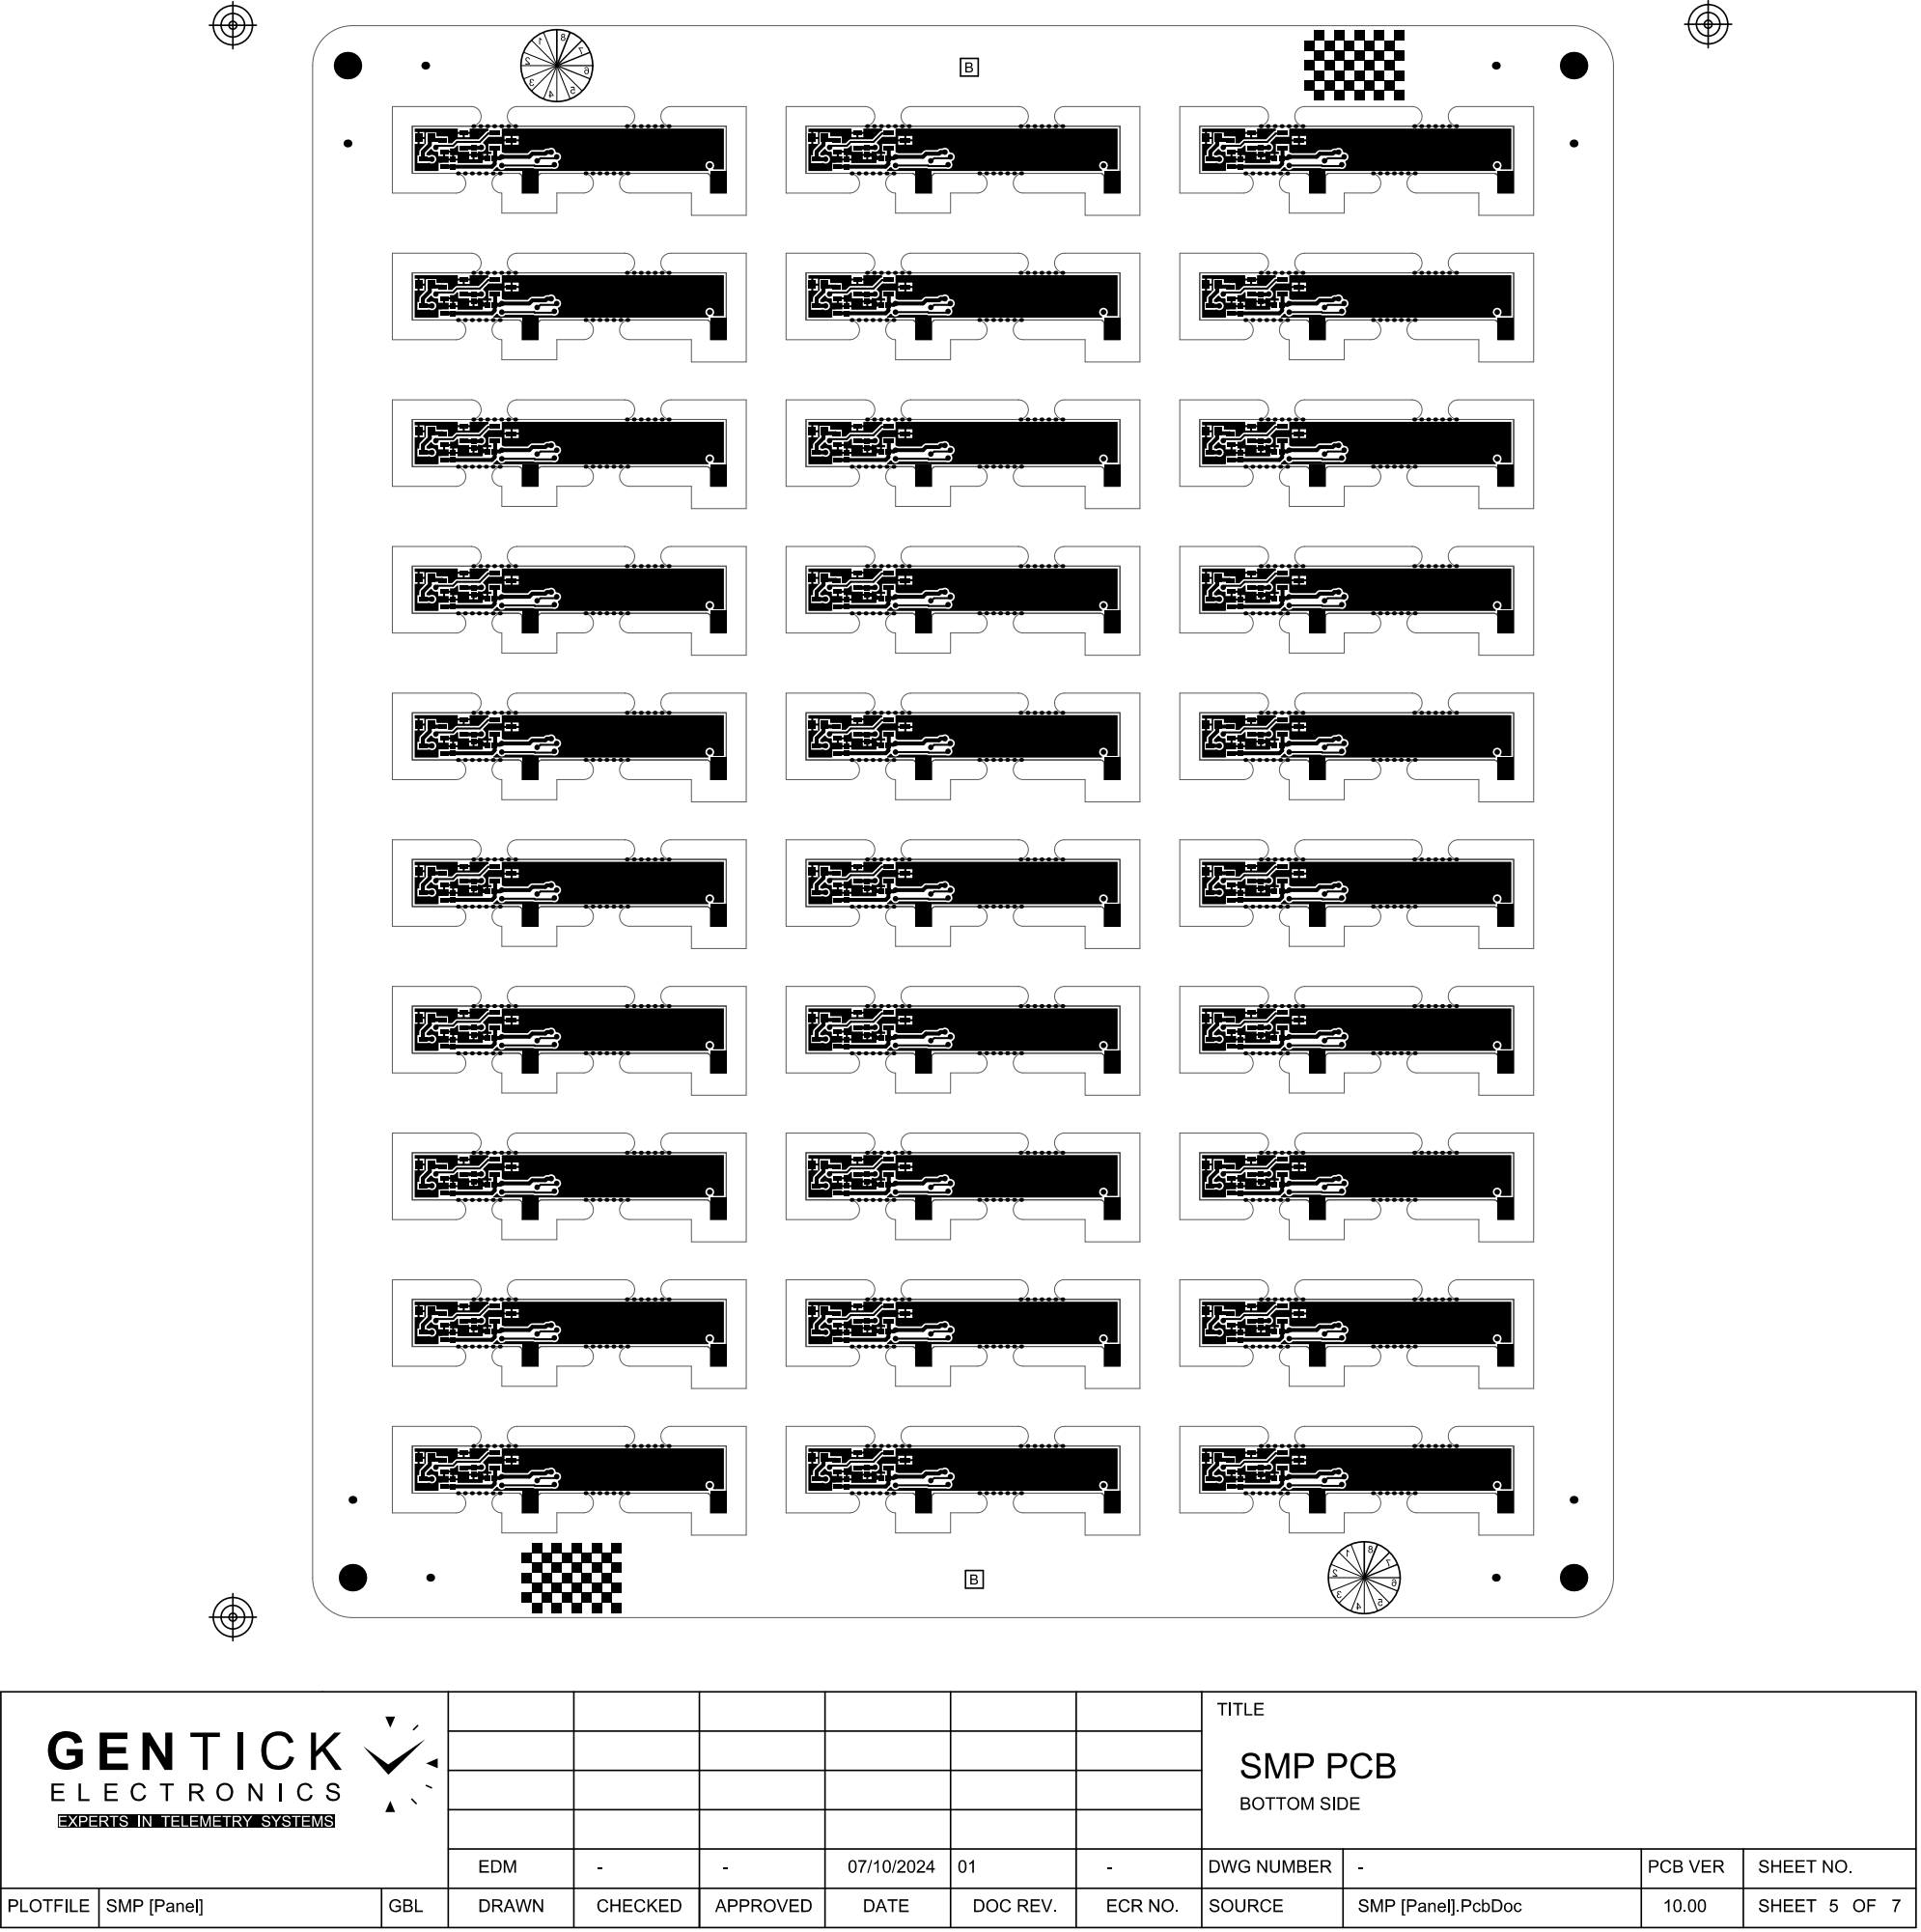
[picture p130: page 5]

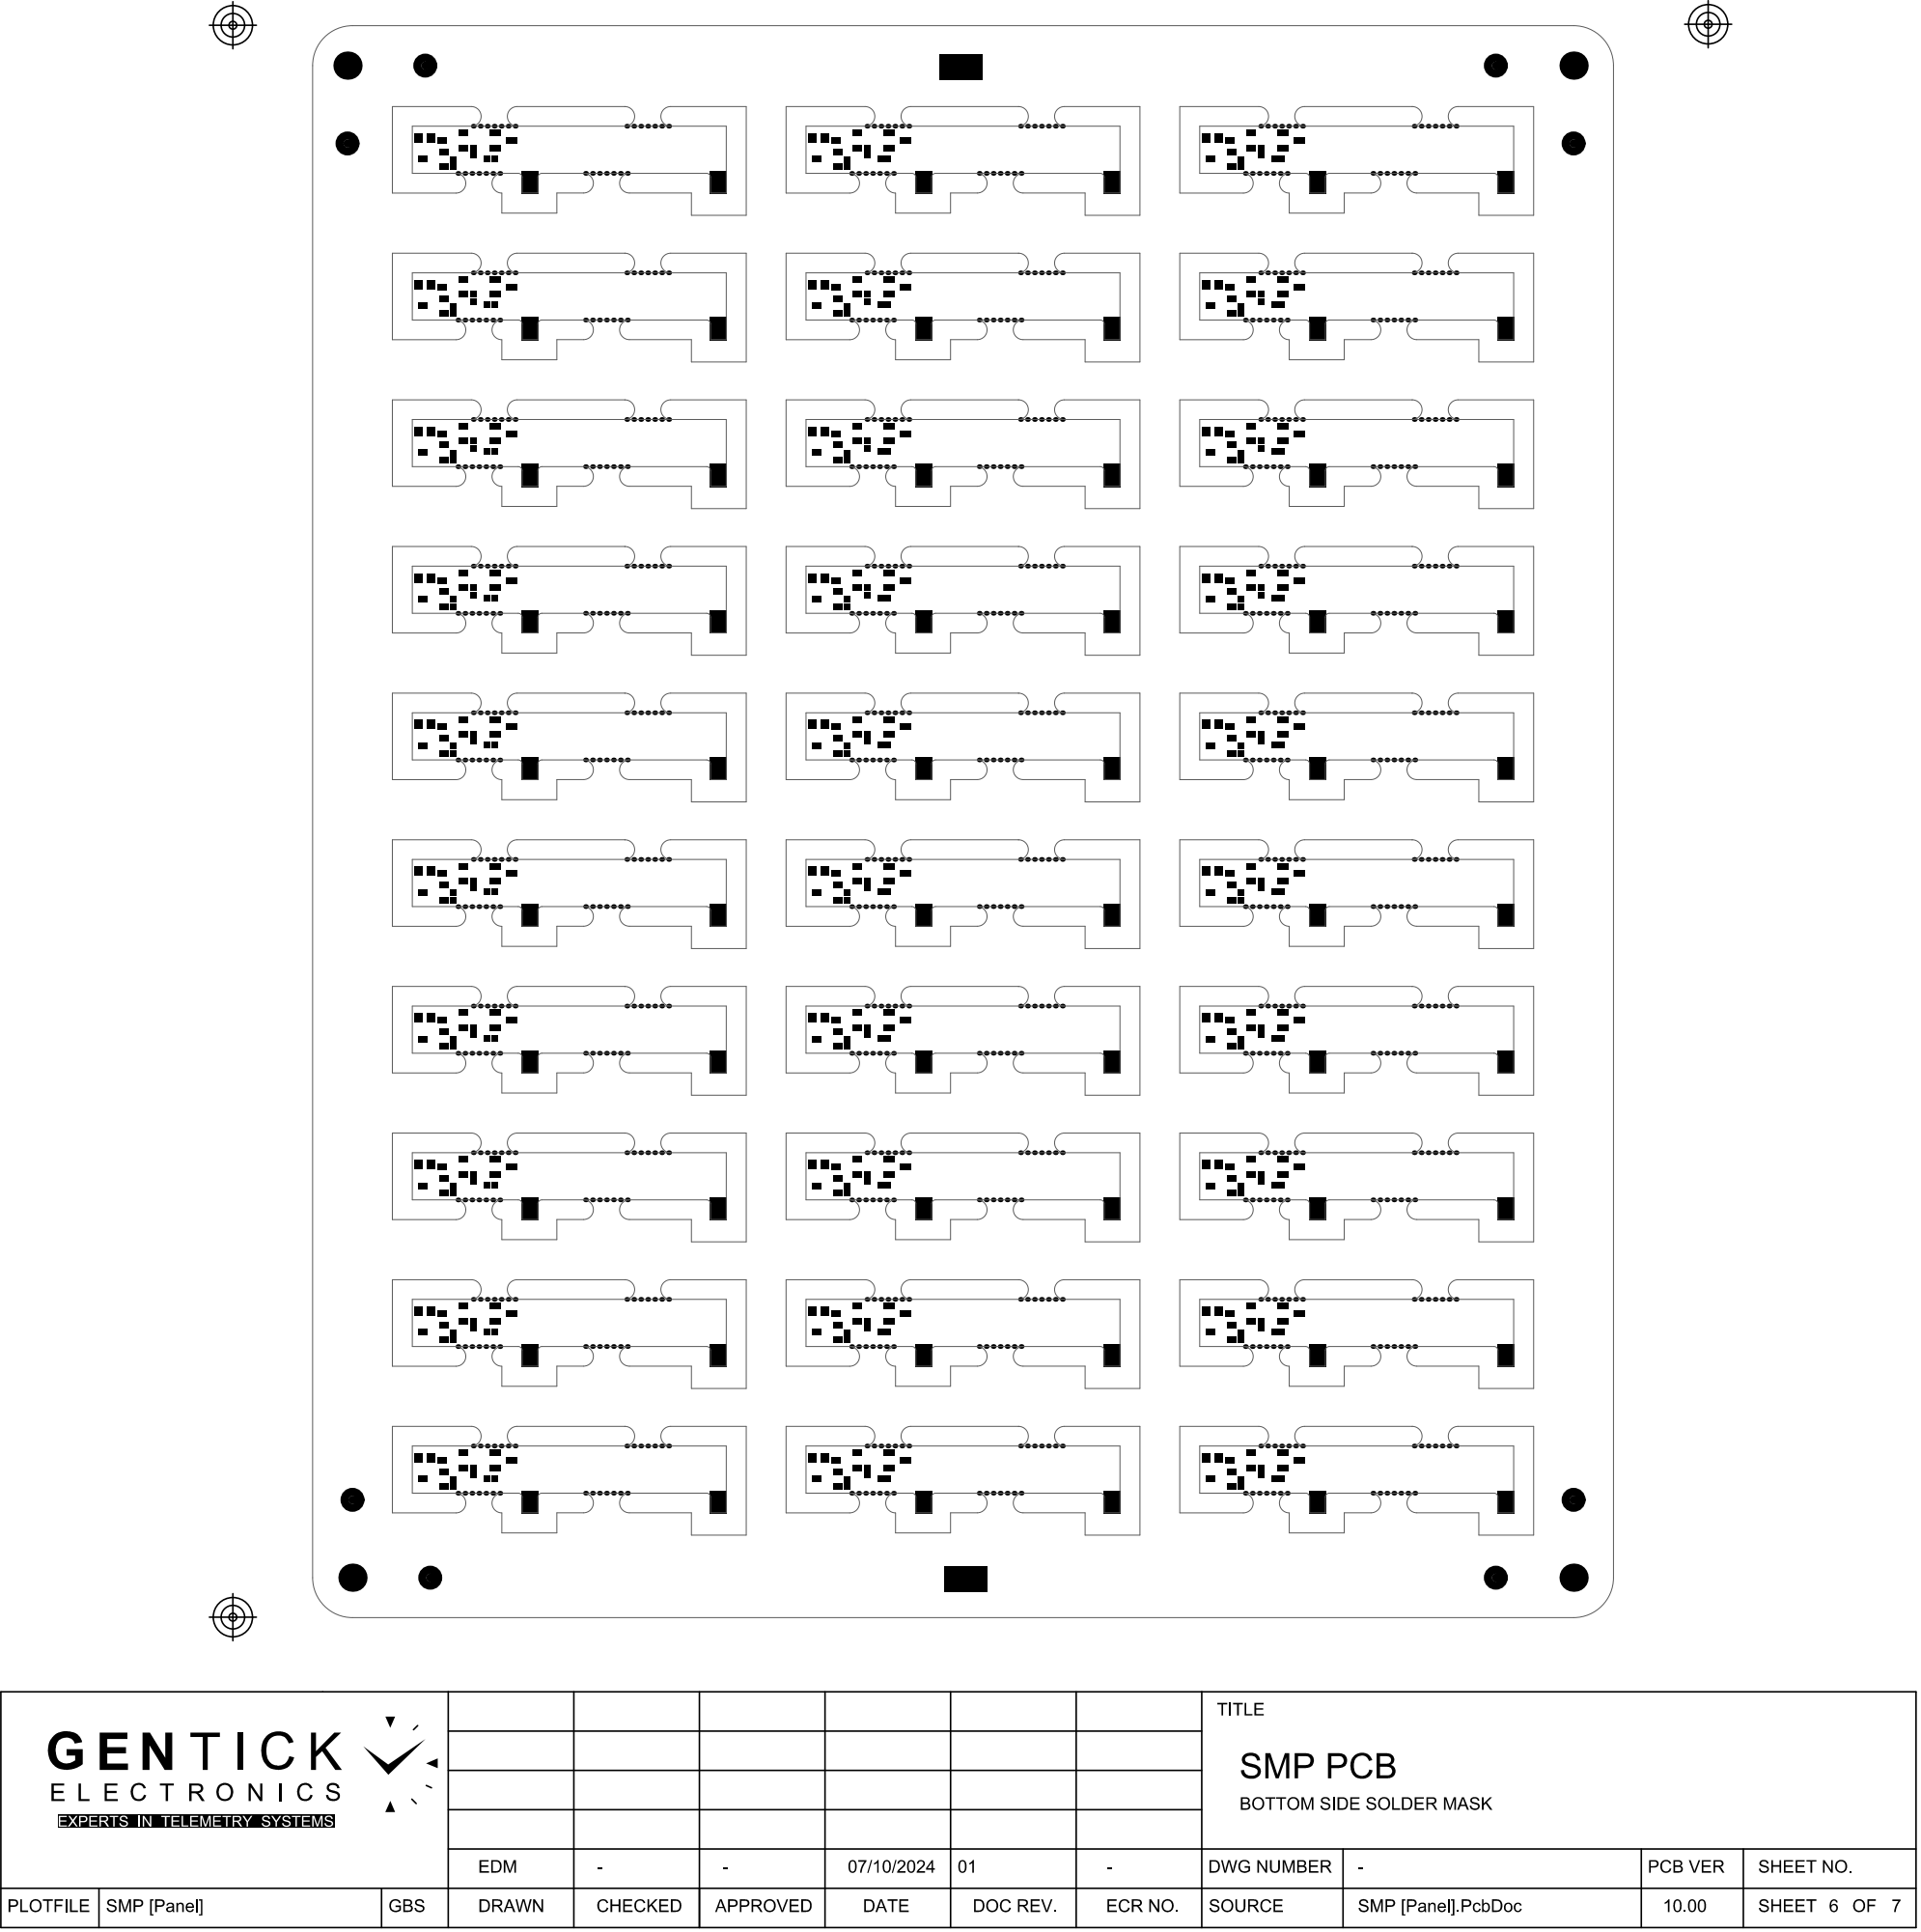
[picture p131: page 6]

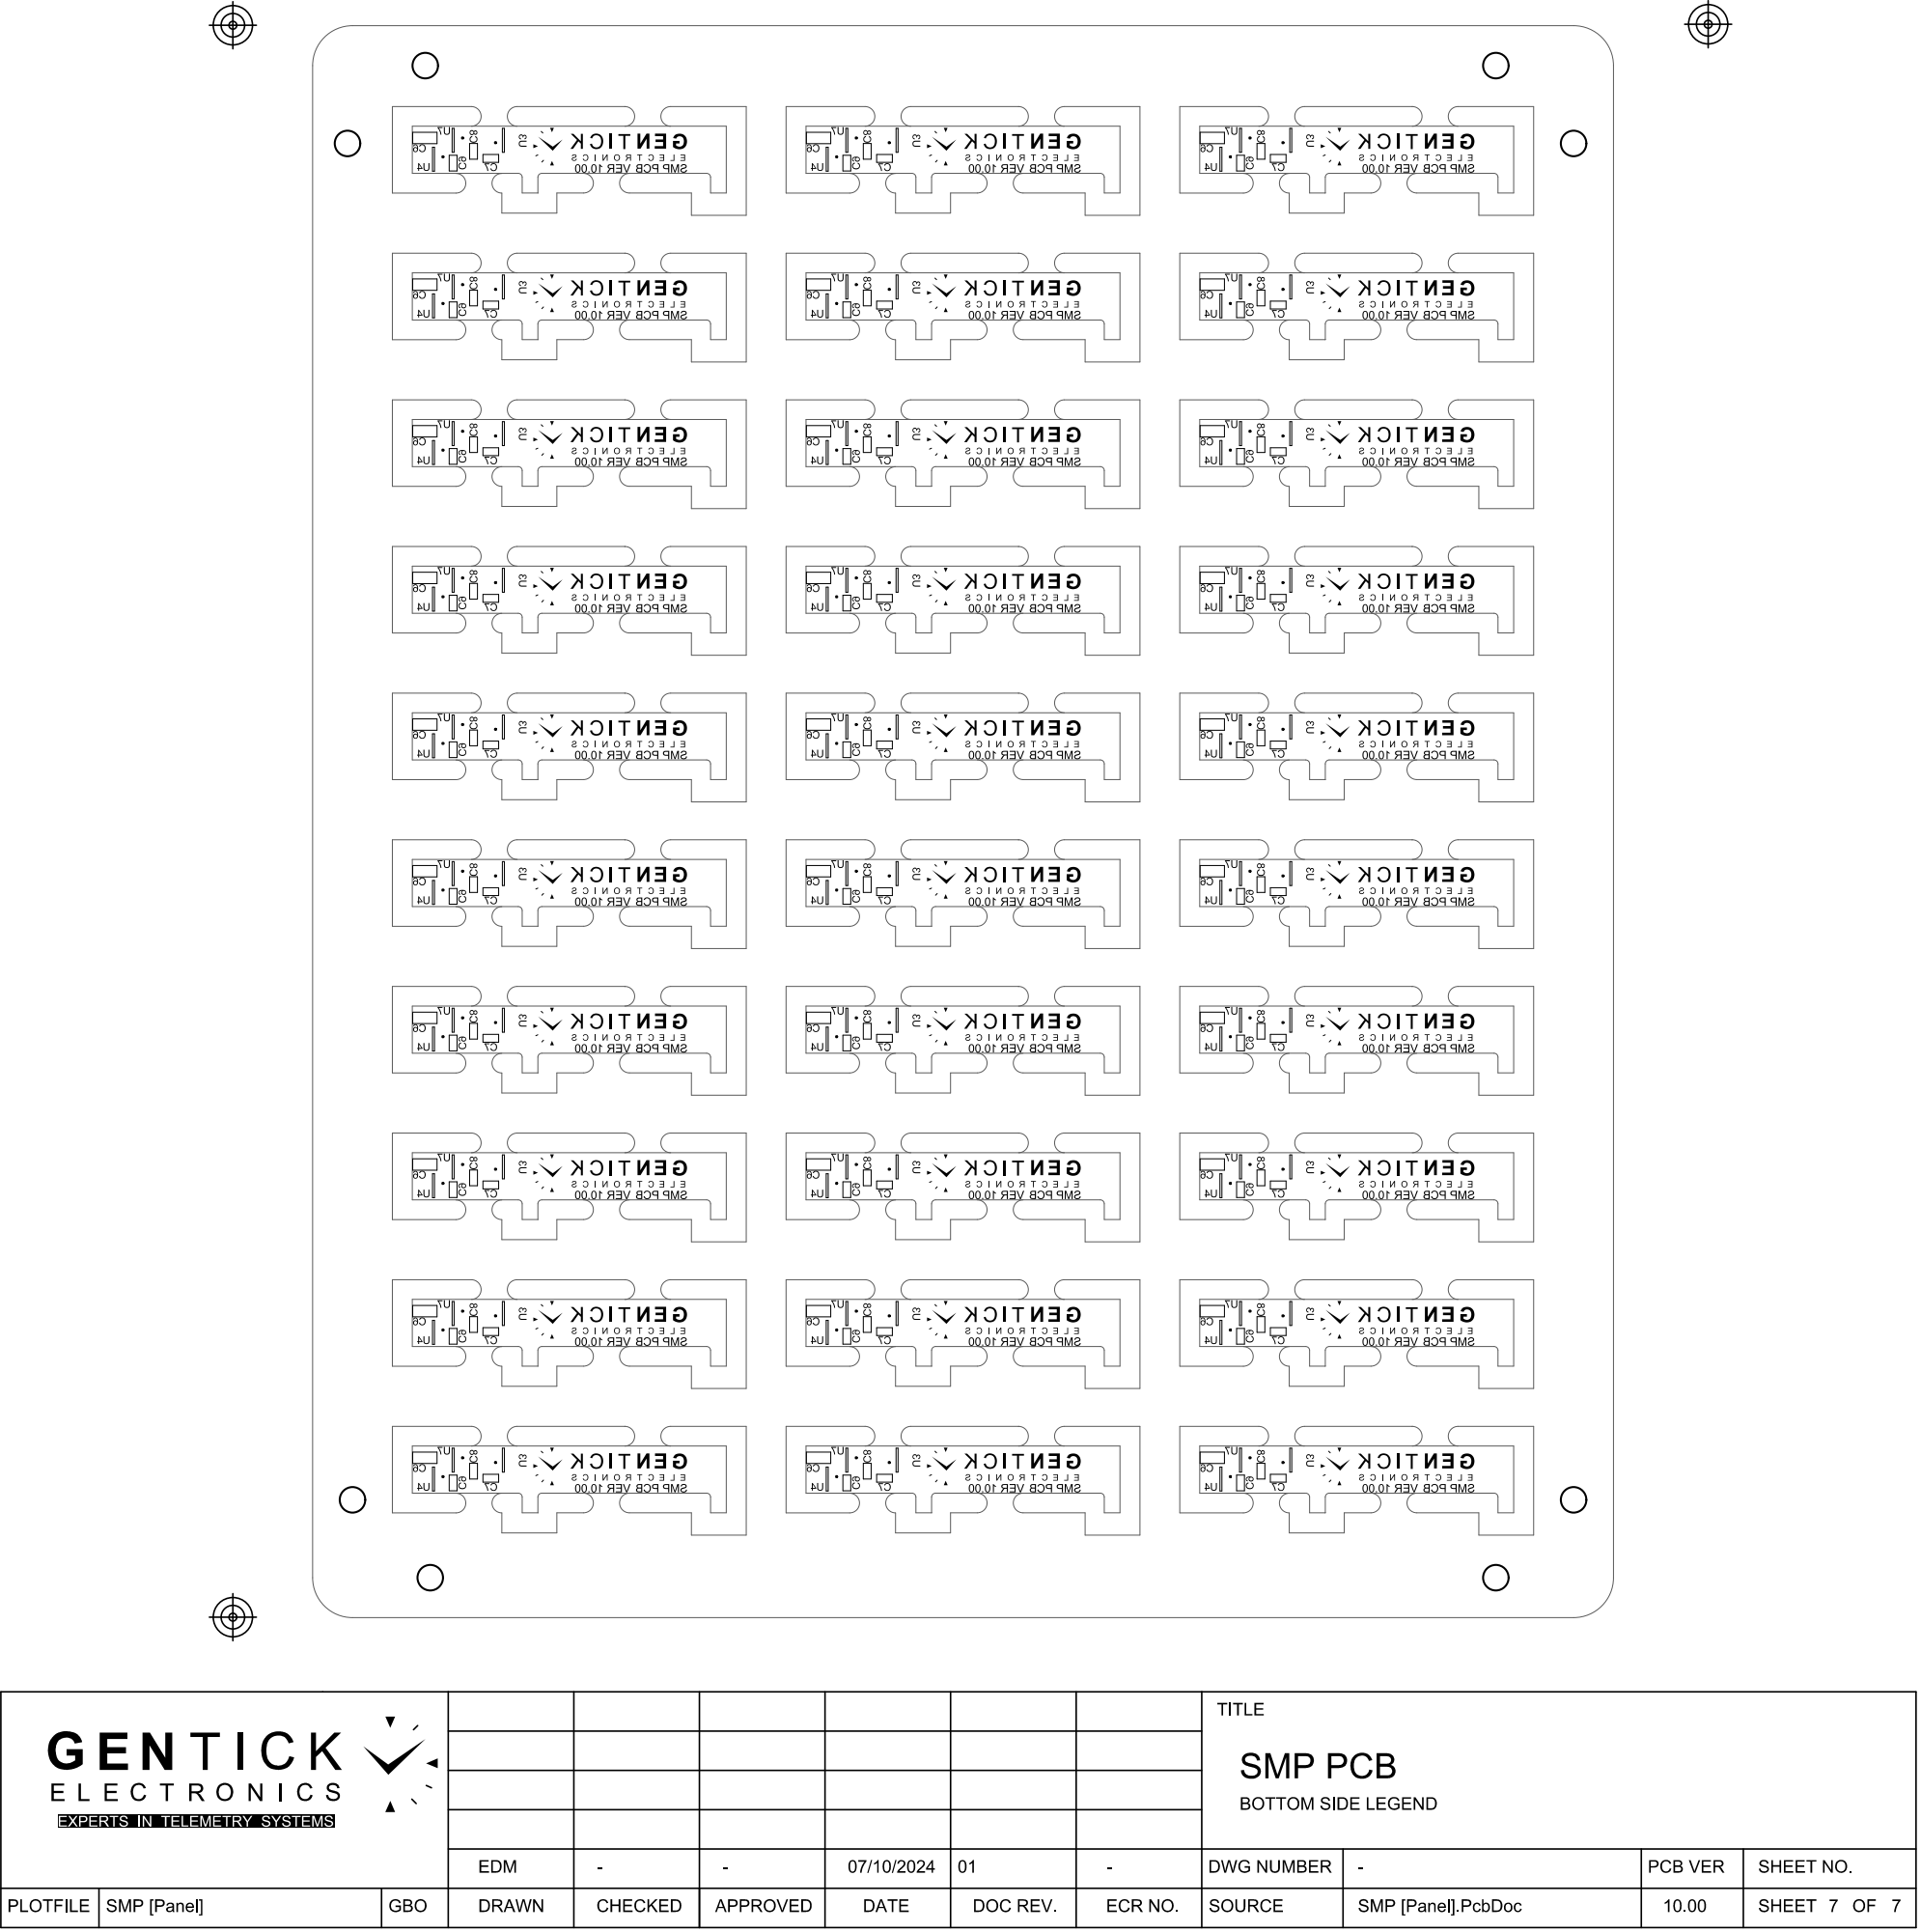
[picture p132: page 7]
