Iron-Byron/Testing-Documentation-for-SMP/Schematic of Sense boards/SMP ver 10.00/SMP ver 10.00 PCB PDF files/SMP ver 10.00 PCB Sch files.PDF

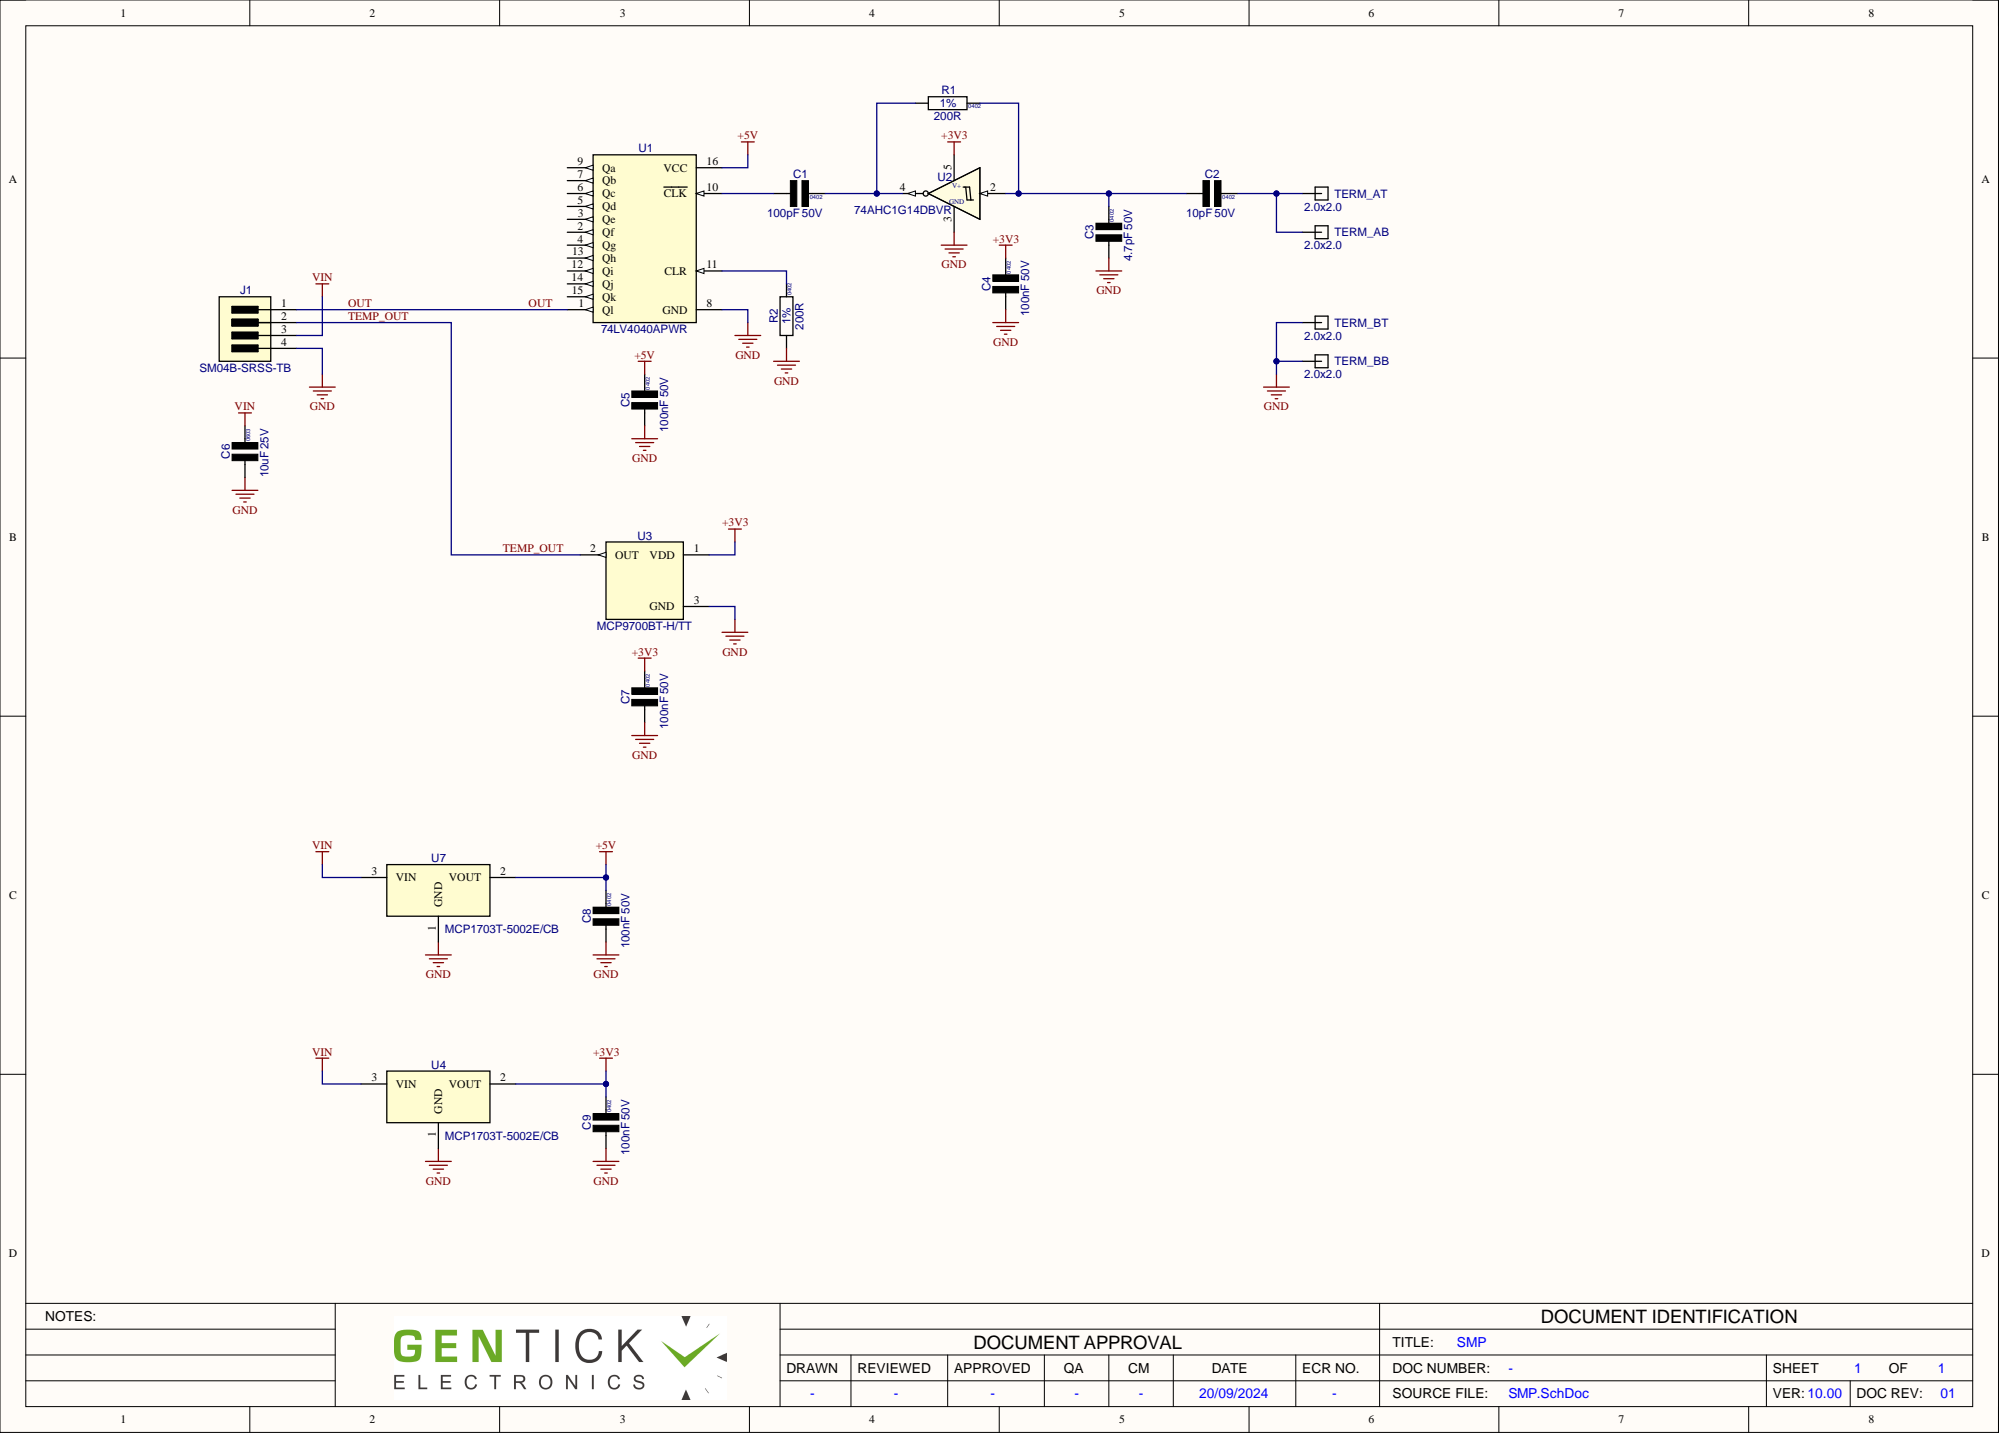
[picture p133: page 1]
