Iron-Byron/Testing-Documentation-for-SMP/Schematic of Sense boards/SMP ver 10.00/SMP ver 10.00 PCB PDF files/SMP ver 10.00 PCB Stencil files.PDF

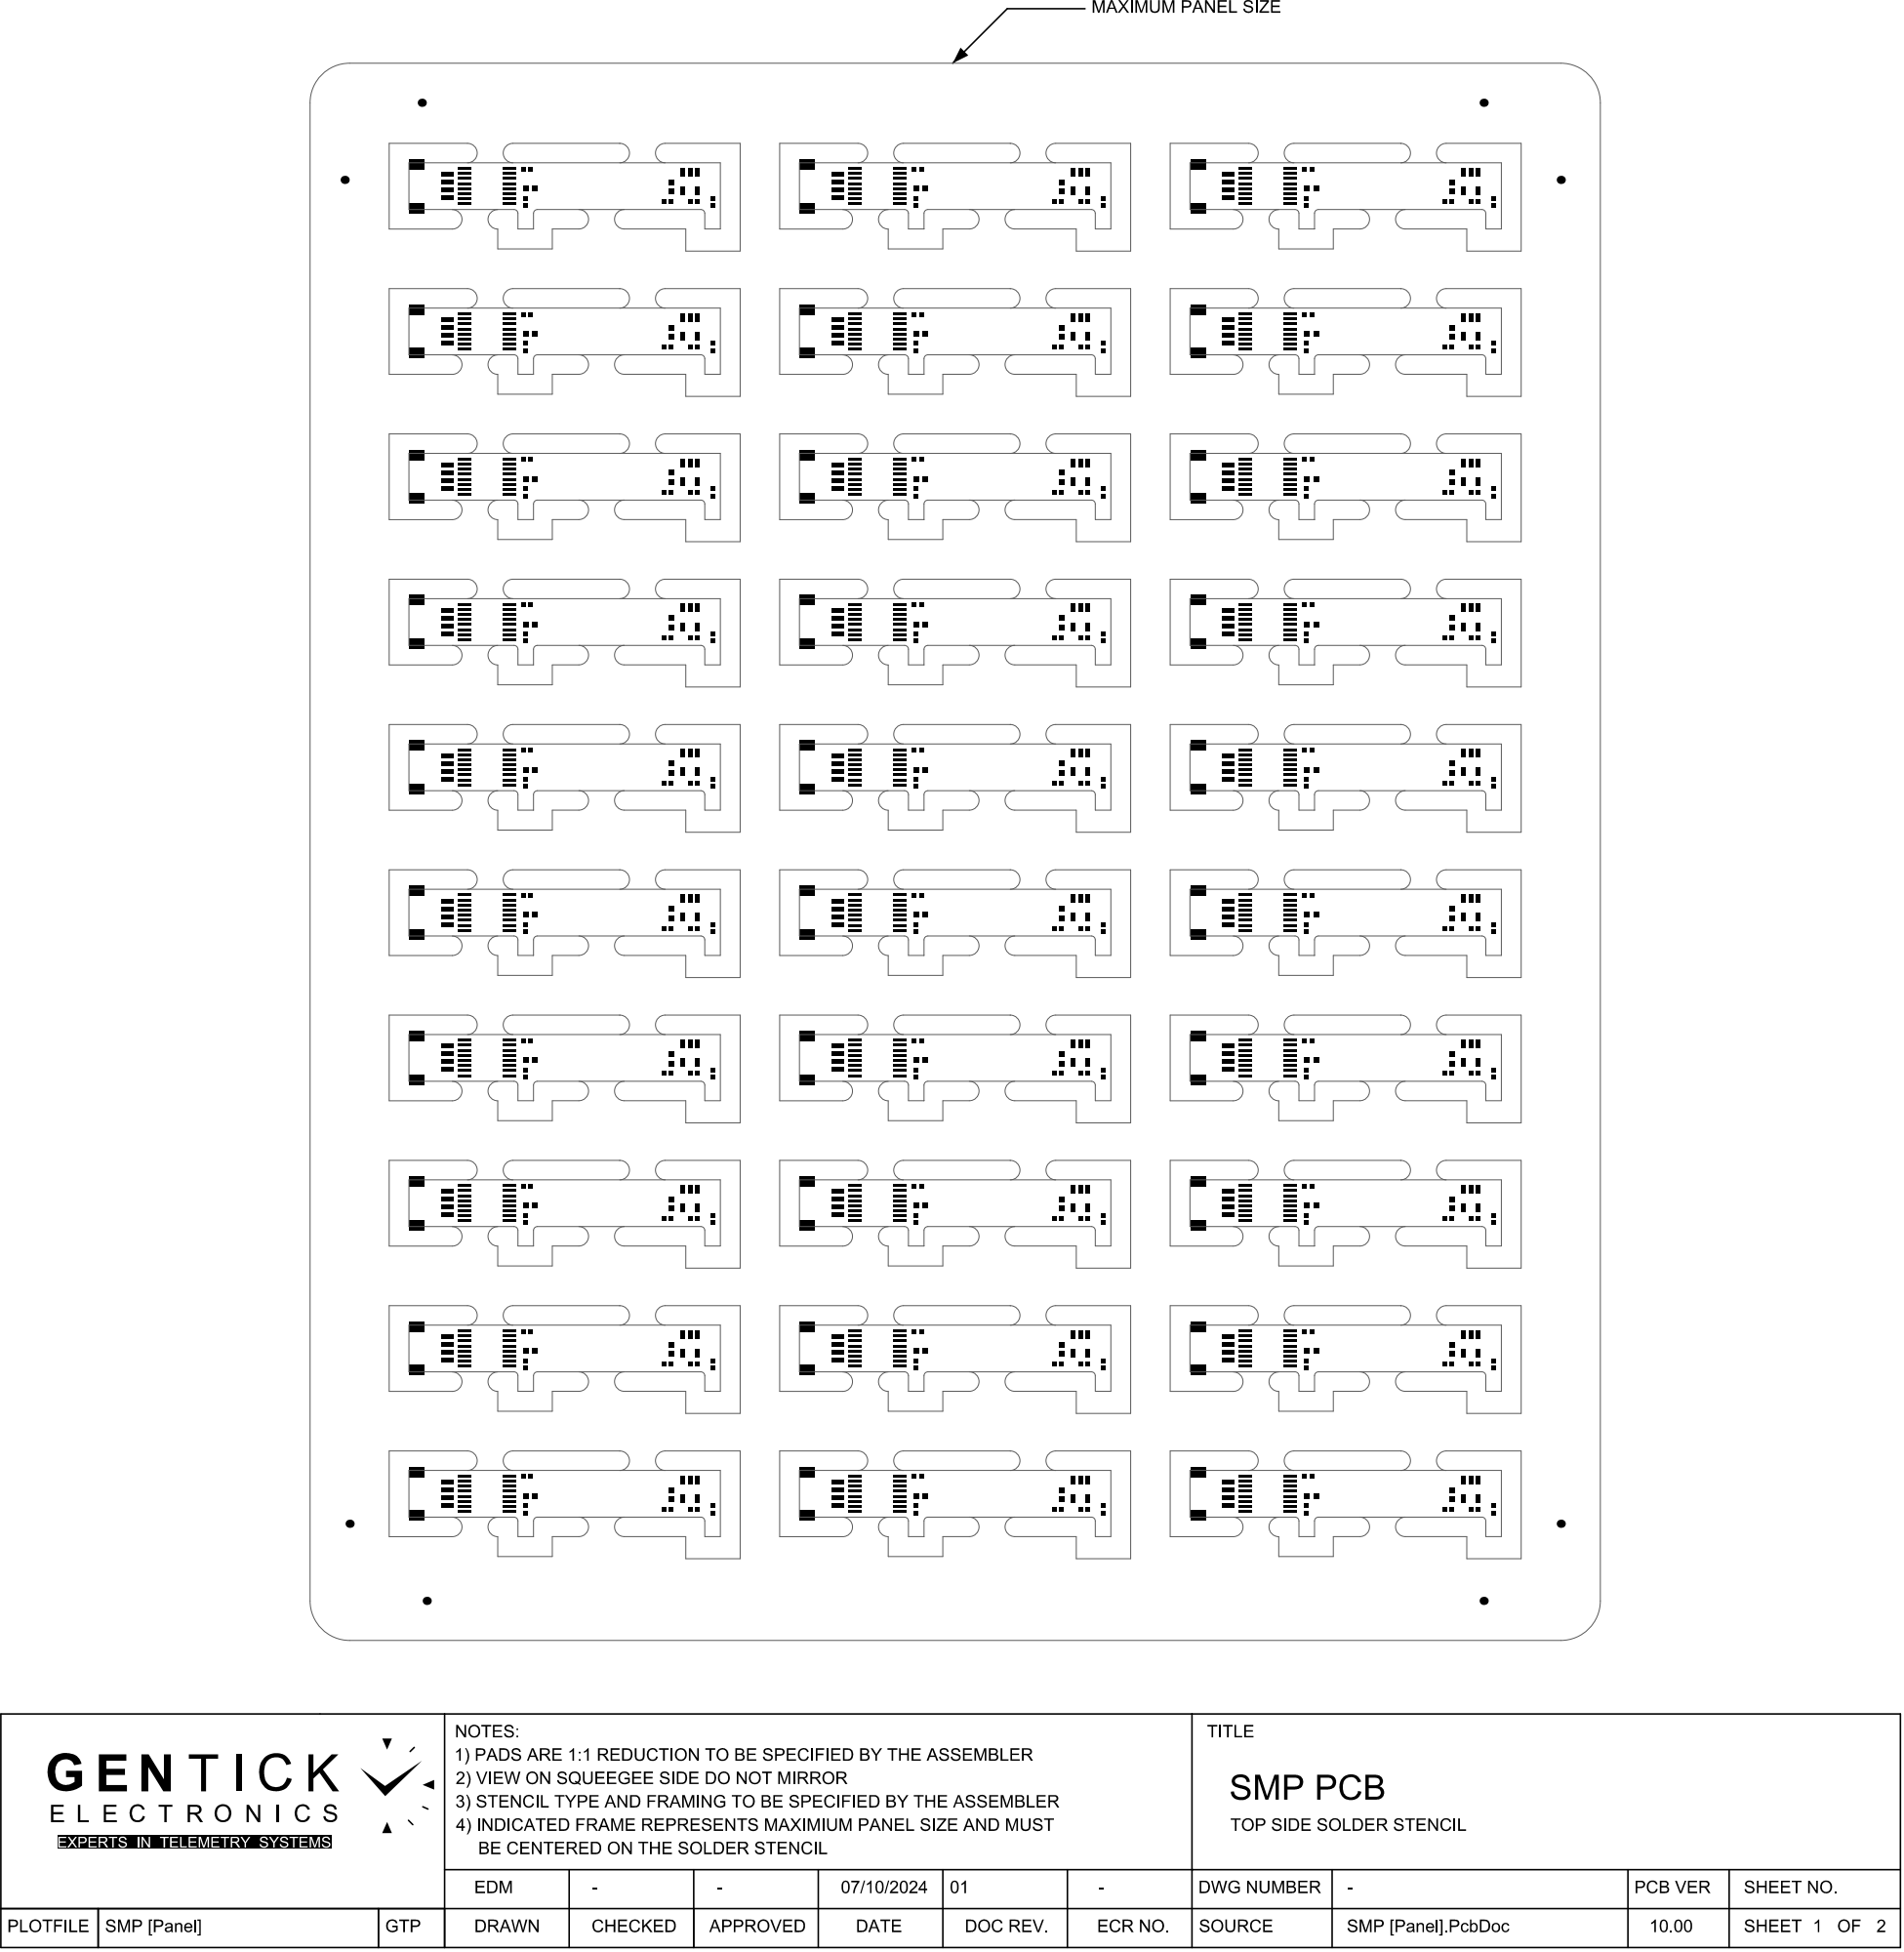
[picture p134: page 1]

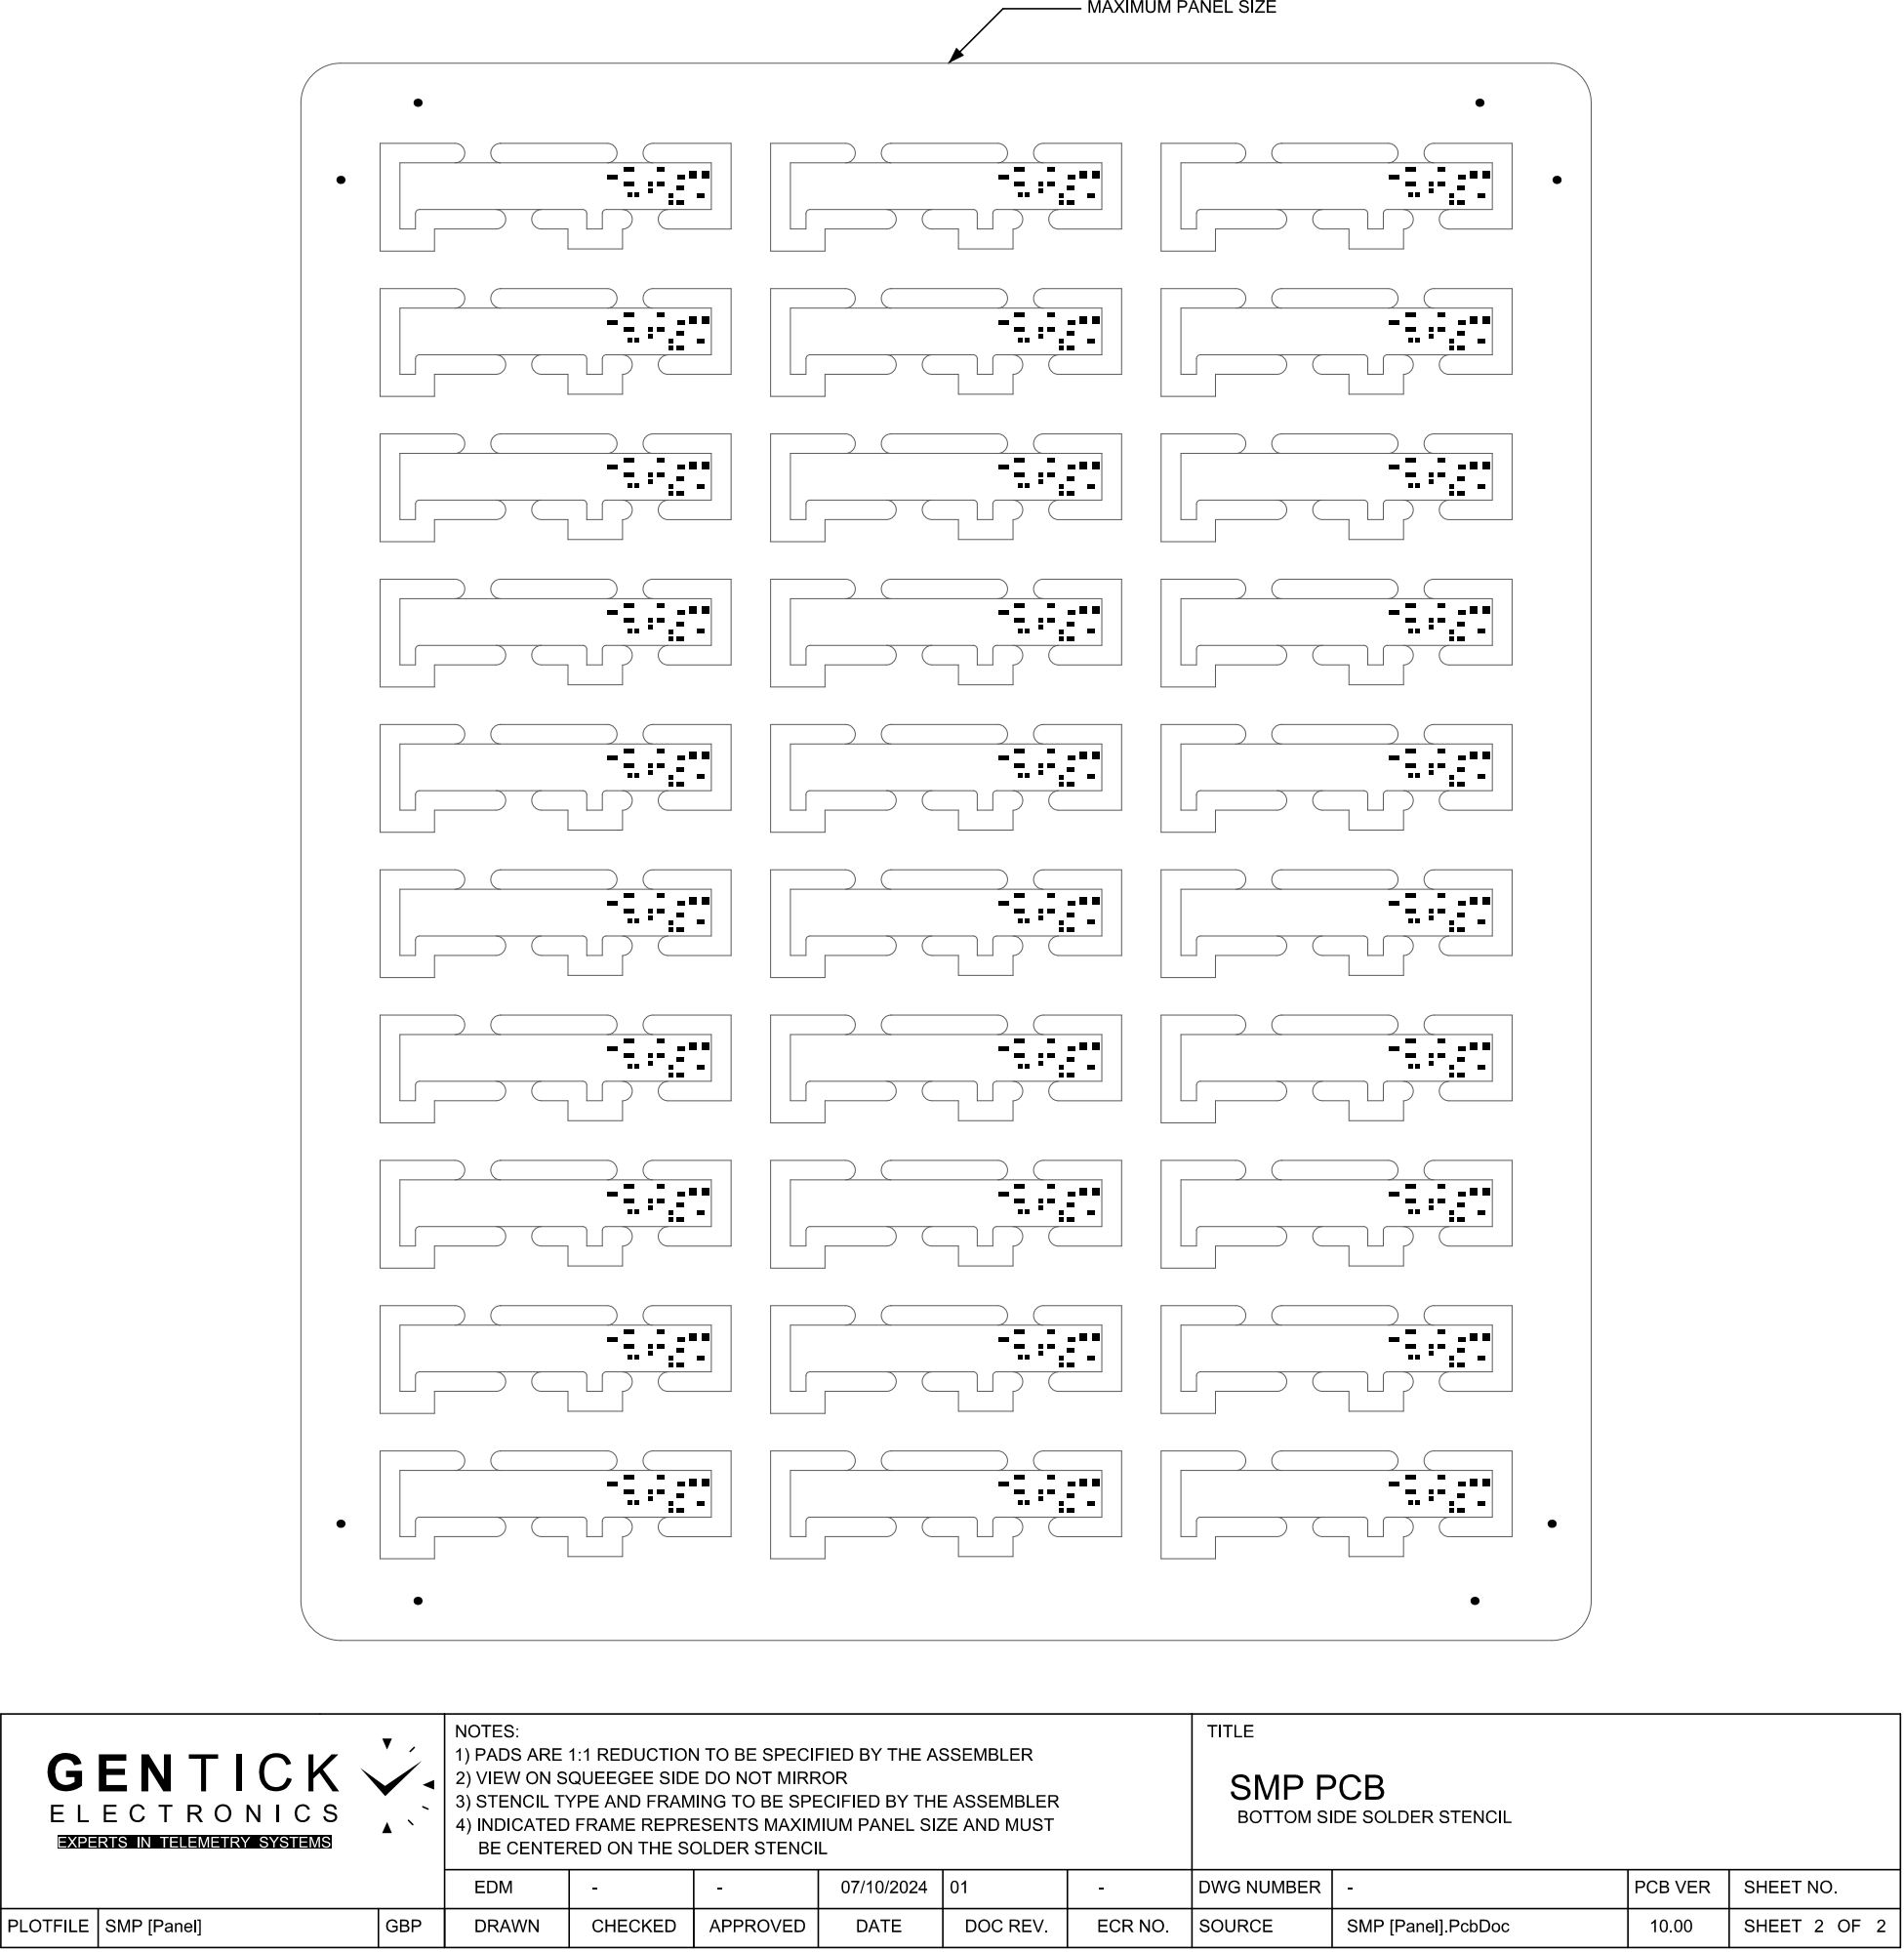
[picture p135: page 2]
