Iron-Byron/Testing-Documentation-for-SMP/(list of files, drawings)

Other design files:
Schematic of Sense boards/SMP ver 10.00/SMP ASCII.PcbDoc
Schematic of Sense boards/SMP ver 10.00/SMP ASCII.SchDoc
